rx-viper/rxsms/eagle/bom-total.ods

Sheet: All
 |  | Qty Variant |  |  | 11 | 6 | 1 | 1 | 1 | 6 | Extra, Staffelung | Qty Total
Value | Device | OC_FARNELL | OC_RS | OC_Buerklin | Qty RX | Qty ZARM | Qty MST1 | Qty MST2 | Qty Pwr ZARM | Qty MST Test
 | AK500/2 | 1131855 |  |  | 1 | 0 | 1 | 1 |  |  | 2 | 15
 | F09HP | 1207597 |  |  | 2 | 2 | 2 | 2 |  |  |  | 38
 | F15HP | 1207598 |  |  | 1 | 1 | 1 | 1 | 1 |  |  | 20
 | M15HPS | 1097065 |  |  | 0 | 0 | 0 | 0 | 0 | 1 |  | 6
 | schrauben | 1855027 |  |  | 6 | 6 | 6 | 6 | 2 | 2 |  | 128
 | ML26L | 1096983 |  |  | 0 | 1 | 1 | 1 | 1 |  |  | 9
 | ML6 | 1096984 |  |  | 1 | 1 | 5 | 5 |  |  |  | 27
100k | R-EU_R0805 | 2333538 |  |  | 1 | 1 | 1 | 1 |  |  |  | 19
100n | C-EUC0805K | 1759265 |  |  | 20 | 16 | 20 | 20 |  |  | 4 | 360
10k | R-EU_R0805 | 1887308 |  |  | 17 | 17 | 17 | 17 |  |  | 2 | 325
10u/16V | C-EUC0805K | 2320856 |  |  | 1 | 1 | 1 | 1 |  |  | 1 | 20
127 | R-EU_R0805 | 2141745 |  |  | 2 | 2 | 2 | 2 |  |  |  | 38
150 | R-EU_R0805 | 1099794 |  |  | 1 | 0 | 1 | 1 |  |  | 7 | 20
1M | R-EU_R0805 | 2333544 |  |  | 0 | 0 | 1 | 1 |  |  |  | 2
1k | R-EU_R0805 | 2332071 |  |  | 5 | 4 | 5 | 5 |  |  | 1 | 90
1u | C-EUC0805K | 2320853 |  |  | 5 | 5 | 9 | 9 |  |  | 7 | 110
22k | R-EU_R0805 | 2303686 |  |  | 1 | 1 | 1 | 1 |  |  | 1 | 20
22u/25V | C-EUC0805K | 1907510 |  |  | 2 | 2 | 2 | 2 |  |  | 2 | 40
24/1% | R-EU_R0805 |  | 666-2386 |  | 0 | 0 | 4 | 4 |  |  | 2 | 10
270 | R-EU_R0805 | 2332064 |  |  | 2 | 2 | 2 | 2 |  |  | 2 | 40
330 | R-EU_R0805 | 1500705 |  |  | 1 | 1 | 1 | 1 |  |  | 1 | 20
3V | ZENER-DIODESOT23 | 1081418 |  |  | 1 | 1 | 1 | 1 |  |  | 1 | 20
4n7 | C-EUC0805K | 2407305 |  |  | 0 | 0 | 1 | 1 |  |  |  | 2
4u7/50V | C-EUC0805K | 2346932 |  |  | 5 | 5 | 5 | 5 |  |  | 5 | 100
10k | STRK11K |  | 737-7833 |  | 0 | 0 | 3 | 3 |  |  |  | 6
50k | STRK11K | 1345093 |  |  | 3 | 0 | 0 | 0 |  |  |  | 33
68 | R-EU_R0805 | 1099792 |  |  | 7 | 6 | 7 | 7 |  |  | 3 | 130
ADUM3160 | ADUM3160 | 1843660 |  |  | 0 | 0 | 1 | 1 |  |  |  | 2
BERNSTEIN | LEDCHIPLED_1206 | 2322083 |  |  | 2 | 2 | 2 | 2 |  |  |  | 38
BSS123 | BSS123 | 9558640RL |  |  | 11 | 11 | 11 | 11 |  |  | 1 | 210
BTS6143 | BTS6143 | 1440813 |  |  | 1 | 1 | 1 | 1 |  |  |  | 19
COIL | COIL | 2333799 |  |  | 2 | 2 | 2 | 2 |  |  |  | 38
GREEN | LEDCHIPLED_1206 | 2099244 |  |  | 3 | 0 | 3 | 1 |  |  |  | 37
HCPL0600 | HCPL0600 | 9994696 |  |  | 4 | 4 | 4 | 4 |  |  |  | 76
LM1117 | LM1117 | 1685603 |  |  | 1 | 1 | 1 | 1 |  |  |  | 19
MAX3232ESE | MAX3232ESE | 9725539 |  |  | 1 | 1 | 1 | 1 |  |  |  | 19
NC7WZ17P6X | NC7WZ17P6X | 1651986 |  |  | 1 | 1 | 1 | 1 |  |  |  | 19
NUP2202W1 | NUP2202W1 |  | 463-690 |  | 0 | 0 | 1 | 1 |  |  | 8 | 10
PN61729-S | PN61729-S | 1642035 |  |  | 0 | 0 | 1 | 1 |  |  |  | 2
RLP2-200-500 | RLP2-200-500 |  | 752-9157 |  | 0 | 1 | 0 | 1 |  |  | 3 | 10
SMS_IP67 | SMS_IP67 | 1217758 |  |  | 5 | 0 | 5 | 0 |  |  |  | 60
SP490 | SP490 | 9387234 |  |  | 1 | 1 | 1 | 1 |  |  |  | 19
SWITCH_LED | SWITCH_LED |  |  | 12 G 203 | 0 | 3 | 0 | 3 |  |  |  | 21
SWITCH_LED | SWITCH_LED |  |  | 12 G 205 | 0 | 1 | 0 | 2 |  |  | 2 | 10
TEN3-2410N | TEN3-2410N |  | 801-9330 |  | 1 | 1 | 1 | 1 |  |  | -10 | 9
TEN3-2410N | TEN3-2410N |  | 801-9330P |  | 1 | 1 | 1 | 1 |  |  | -9 | 10
TPS73125 | TPS731 | 2112625 |  |  | 1 | 1 | 1 | 1 |  |  |  | 19
TSR_1-2450 | TSR_1-2450 | 1696320 |  |  | 1 | 1 | 1 | 1 |  |  |  | 19
UDN2596 | UDN2596 | 1103848 |  |  | 1 | 1 | 1 | 1 |  |  | 1 | 20
XMEGA-A4UTQFP | XMEGA-A4UTQFP | 2066309 |  |  | 1 | 1 | 1 | 1 |  |  |  | 19
YELLOW | LEDCHIPLED_1206 | 2099249 |  |  | 3 | 0 | 3 | 0 |  |  |  | 36
0 | R-EU_R0805 | 2309112 |  |  | 2 | 2 | 2 | 2 |  |  |  | 38
12V | ZENER-DIODEDO34-7 | 1779204 |  |  | 0 | 0 | 0 | 0 | 2 |  |  | 2
FDD4141TO252 | FDD4141TO252 | 2101406 |  |  | 0 | 0 | 0 | 0 | 1 |  |  | 1
black | JACK | 1854507 |  |  | 0 | 0 | 0 | 0 | 1 |  |  | 1
red | JACK | 1854508 |  |  | 0 | 0 | 0 | 0 | 1 |  |  | 1
blue | JACK | 1854511 |  |  | 0 | 0 | 0 | 0 | 0 |  |  | 0
yellow | JACK | 1854510 |  |  | 0 | 0 | 0 | 0 | 1 |  |  | 1
RLP1-200-500 | RLP1-200-500 | 1887972 |  |  | 0 | 0 | 0 | 0 | 1 |  |  | 1
SCHURTER-LSH-1301.9314 | SCHURTER-LSH-1301.9314 | 1217763 |  |  | 0 | 0 | 0 | 0 | 0 | 1 |  | 6
26 Pol | Flachbandkabel | 297343 |  |  | 0 | 0 | 0 | 0 | 1 | 0 |  | 1
26 Pol | Crimp Buchse | 1200506 |  |  | 0 | 1 | 0 | 0 | 1 | 0 | 3 | 10
BUERKLIN17H912 | BUERKLIN17H912 |  |  | 17H912 | 0 | 0 | 0 | 0 | 1 | 0 |  | 1

Sheet: RS
666-2386 | 10
737-7833 | 6
463-690 | 10
752-9157 | 10
801-9330 | 9
801-9330P | 10

Sheet: FARNELL
1131855 | 15
1207597 | 38
1207598 | 20
1097065 | 6
1855027 | 128
1096983 | 9
1096984 | 27
2333538 | 19
1759265 | 360
1887308 | 325
2320856 | 20
2141745 | 38
1099794 | 20
2333544 | 2
2332071 | 90
2320853 | 110
2303686 | 20
1907510 | 40
2332064 | 40
1500705 | 20
1081418 | 20
2407305 | 2
2346932 | 100
1345093 | 33
1099792 | 130
1843660 | 2
2322083 | 38
9558640RL | 210
1440813 | 19
2333799 | 38
2099244 | 37
9994696 | 76
1685603 | 19
9725539 | 19
1651986 | 19
1642035 | 2
1217758 | 60
9387234 | 19
2112625 | 19
1696320 | 19
1103848 | 20
2066309 | 19
2099249 | 36
2309112 | 38
1779204 | 2
2101406 | 1
1854507 | 1
1854508 | 1
1854510 | 1
1887972 | 1
1217763 | 6
297343 | 1
1200506 | 10

Sheet: BUERKLIN
12 G 203 | 21
12 G 205 | 10
17H912 | 1
