rx-viper/rxsms/eagle/simulator/bom-sim.ods

Sheet: rxsms-2.0-parts
Part | Value | Device | Package | Description | OC_BUERKLIN | OC_FARNELL | OC_RS | VAR_RX | VAR_ZARM | VAR_MST_RX | VAR_MST_ZARM | Bestückung
C1 | 1u | C-EUC0805K | C0805K | CAPACITOR, European symbol |  | 2320853 |  | 1 | 1 | 1 | 1 | 1
C2 | 1u | C-EUC0805K | C0805K | CAPACITOR, European symbol |  | 2320853 |  | 1 | 1 | 1 | 1 | 1
C3 | 1u | C-EUC0805K | C0805K | CAPACITOR, European symbol |  | 2320853 |  | 1 | 1 | 1 | 1 | 1
C4 | 1u | C-EUC0805K | C0805K | CAPACITOR, European symbol |  | 2320853 |  | 1 | 1 | 1 | 1 | 1
C5 | 1u | C-EUC0805K | C0805K | CAPACITOR, European symbol |  | 2320853 |  | 1 | 1 | 1 | 1 | 1
C6 | 100n | C-EUC0805K | C0805K | CAPACITOR, European symbol |  | 1759265 |  | 1 | 1 | 1 | 1 | 1
C7 | 100n | C-EUC0805K | C0805K | CAPACITOR, European symbol |  | 1759265 |  | 1 | 1 | 1 | 1 | 1
C8 | 100n | C-EUC0805K | C0805K | CAPACITOR, European symbol |  | 1759265 |  | 1 | 1 | 1 | 1 | 1
C9 | 100n | C-EUC0805K | C0805K | CAPACITOR, European symbol |  | 1759265 |  | 1 | 1 | 1 | 1 | 1
C10 | opt | C-EUC0805K | C0805K | CAPACITOR, European symbol
C11 | opt | C-EUC0805K | C0805K | CAPACITOR, European symbol
C12 | 4u7/50V | C-EUC0805K | C0805K | CAPACITOR, European symbol |  | 2346932 |  | 1 | 1 | 1 | 1 | 1
C13 | 4u7/50V | C-EUC0805K | C0805K | CAPACITOR, European symbol |  | 2346932 |  | 1 | 1 | 1 | 1 | 1
C14 | 22u/25V | C-EUC0805K | C0805K | CAPACITOR, European symbol |  | 1907510 |  | 1 | 1 | 1 | 1 | 1
C15 | 22u/25V | C-EUC0805K | C0805K | CAPACITOR, European symbol |  | 1907510 |  | 1 | 1 | 1 | 1 | 1
C16 | 100n | C-EUC0805K | C0805K | CAPACITOR, European symbol |  | 1759265 |  | 1 | 1 | 1 | 1 | 1
C17 | 1u | C-EUC0805K | C0805K | CAPACITOR, European symbol |  | 2320853 |  |  |  | 1 | 1
C18 | 1u | C-EUC0805K | C0805K | CAPACITOR, European symbol |  | 2320853 |  |  |  | 1 | 1
C19 | 1u | C-EUC0805K | C0805K | CAPACITOR, European symbol |  | 2320853 |  |  |  | 1 | 1
C20 | 1u | C-EUC0805K | C0805K | CAPACITOR, European symbol |  | 2320853 |  |  |  | 1 | 1
C21 | 100n | C-EUC0805K | C0805K | CAPACITOR, European symbol |  | 1759265 |  | 1 | 1 | 1 | 1 | 1
C22 | 100n | C-EUC0805K | C0805K | CAPACITOR, European symbol |  | 1759265 |  | 1 | 1 | 1 | 1 | 1
C23 | 100n | C-EUC0805K | C0805K | CAPACITOR, European symbol |  | 1759265 |  | 1 | 1 | 1 | 1 | 1
C24 | 100n | C-EUC0805K | C0805K | CAPACITOR, European symbol |  | 1759265 |  | 1 | 1 | 1 | 1 | 1
C25 | 100n | C-EUC0805K | C0805K | CAPACITOR, European symbol |  | 1759265 |  | 1 | 1 | 1 | 1 | 1
C26 | 100n | C-EUC0805K | C0805K | CAPACITOR, European symbol |  | 1759265 |  | 1 | 1 | 1 | 1 | 1
C27 | 100n | C-EUC0805K | C0805K | CAPACITOR, European symbol |  | 1759265 |  | 1 | 1 | 1 | 1 | 1
C28 | 100n | C-EUC0805K | C0805K | CAPACITOR, European symbol |  | 1759265 |  | 1 | 1 | 1 | 1 | 1
C29 | 100n | C-EUC0805K | C0805K | CAPACITOR, European symbol |  | 1759265 |  | 1 | 1 | 1 | 1 | 1
C30 | 4u7/50V | C-EUC0805K | C0805K | CAPACITOR, European symbol |  | 2346932 |  | 1 | 1 | 1 | 1 | 1
C31 | 4u7/50V | C-EUC0805K | C0805K | CAPACITOR, European symbol |  | 2346932 |  | 1 | 1 | 1 | 1 | 1
C32 | 10u/16V | C-EUC0805K | C0805K | CAPACITOR, European symbol |  | 2320856 |  | 1 | 1 | 1 | 1 | 1
C33 | 100n | C-EUC0805K | C0805K | CAPACITOR, European symbol |  | 1759265 |  | 1 | 1 | 1 | 1 | 1
C34 | 4n7 | C-EUC0805K | C0805K | CAPACITOR, European symbol |  | 2407305 |  |  |  | 1 | 1
C35 | 4u7/50V | C-EUC0805K | C0805K | CAPACITOR, European symbol |  | 2346932 |  | 1 | 1 | 1 | 1 | 1
C36 | 100n | C-EUC0805K | C0805K | CAPACITOR, European symbol |  | 1759265 |  | 1 | 1 | 1 | 1 | 1
C37 | 100n | C-EUC0805K | C0805K | CAPACITOR, European symbol |  | 1759265 |  | 1 | 1 | 1 | 1 | 1
C38 | 100n | C-EUC0805K | C0805K | CAPACITOR, European symbol |  | 1759265 |  | 1 | 1 | 1 | 1 | 1
C39 | 100n | C-EUC0805K | C0805K | CAPACITOR, European symbol |  | 1759265 |  | 1 | 1 | 1 | 1 | 1
C40 | 100n | C-EUC0805K | C0805K | CAPACITOR, European symbol |  | 1759265 |  | 1 | 1 | 1 | 1 | 1
D1 | 12V | ZENER-DIODEDO34-7 | DO34Z7 | Z-Diode |  | 1779204 |  | 1 | 1 | 1 | 1 | 1
JP1 |  | JP1E | JP1 | JUMPER
JP2 |  | JP1E | JP1 | JUMPER
L1 | COIL | COIL | BOURNS-SRR0906 |  |  | 2333799 |  | 1 | 1 | 1 | 1 | 1
L2 | COIL | COIL | BOURNS-SRR0906 |  |  | 2333799 |  | 1 | 1 | 1 | 1 | 1
LED1_LO | YELLOW | LEDCHIPLED_1206 | CHIPLED_1206 | LED |  | 2099249 |  | 1 |  | 1 |  | 1
LED2_SOE | YELLOW | LEDCHIPLED_1206 | CHIPLED_1206 | LED |  | 2099249 |  | 1 |  | 1 |  | 1
LED3_SODS | YELLOW | LEDCHIPLED_1206 | CHIPLED_1206 | LED |  | 2099249 |  | 1 |  | 1 |  | 1
LED4_ERRINH | GREEN | LEDCHIPLED_1206 | CHIPLED_1206 | LED |  | 2099244 |  | 1 |  | 1 |  | 1
LED5_PWR | GREEN | LEDCHIPLED_1206 | CHIPLED_1206 | LED |  | 2099244 |  | 1 |  | 1 |  | 1
LED6 | BERNSTEIN | LEDCHIPLED_1206 | CHIPLED_1206 | LED |  | 2322083 |  | 1 | 1 | 1 | 1 | 1
LED7 | BERNSTEIN | LEDCHIPLED_1206 | CHIPLED_1206 | LED |  | 2322083 |  | 1 | 1 | 1 | 1 | 1
LED8 | GREEN | LEDCHIPLED_1206 | CHIPLED_1206 | LED |  | 2099244 |  | 1 | 1 | 1 | 1 | 1
OK1 | HCPL0600 | HCPL0600 | SOIC08 | HEWLETT PACKARD OPTO COUPLER |  | 9994696 |  | 1 | 1 | 1 | 1 | 1
OK2 | HCPL0600 | HCPL0600 | SOIC08 | HEWLETT PACKARD OPTO COUPLER |  | 9994696 |  | 1 | 1 | 1 | 1 | 1
OK3 | HCPL0600 | HCPL0600 | SOIC08 | HEWLETT PACKARD OPTO COUPLER |  | 9994696 |  | 1 | 1 | 1 | 1 | 1
OK4 | HCPL0600 | HCPL0600 | SOIC08 | HEWLETT PACKARD OPTO COUPLER |  | 9994696 |  | 1 | 1 | 1 | 1 | 1
Q1 | opt | CRYSTALHC49S | HC49/S | CRYSTAL |  | 1667008
Q2 | BSS123 | BSS123 | SOT23 | N-CHANNEL MOS FET |  | 9558640 | 545-0135 | 1 | 1 | 1 | 1 | 1
Q3 | BSS123 | BSS123 | SOT23 | N-CHANNEL MOS FET |  | 9558640 | 545-0135 | 1 | 1 | 1 | 1 | 1
Q4 | BSS123 | BSS123 | SOT23 | N-CHANNEL MOS FET |  | 9558640 | 545-0135 | 1 | 1 | 1 | 1 | 1
Q5 | BSS123 | BSS123 | SOT23 | N-CHANNEL MOS FET |  | 9558640 | 545-0135 | 1 | 1 | 1 | 1 | 1
Q6 | BSS123 | BSS123 | SOT23 | N-CHANNEL MOS FET |  | 9558640 | 545-0135 | 1 | 1 | 1 | 1 | 1
Q7 | BSS123 | BSS123 | SOT23 | N-CHANNEL MOS FET |  | 9558640 | 545-0135 | 1 | 1 | 1 | 1 | 1
Q8 | BSS123 | BSS123 | SOT23 | N-CHANNEL MOS FET |  | 9558640 | 545-0135 | 1 | 1 | 1 | 1 | 1
Q9 | BSS123 | BSS123 | SOT23 | N-CHANNEL MOS FET |  | 9558640 | 545-0135 | 1 | 1 | 1 | 1 | 1
Q10 | BSS123 | BSS123 | SOT23 | N-CHANNEL MOS FET |  | 9558640 | 545-0135 | 1 | 1 | 1 | 1 | 1
Q11 | BSS123 | BSS123 | SOT23 | N-CHANNEL MOS FET |  | 9558640 | 545-0135 | 1 | 1 | 1 | 1 | 1
Q12 | BSS123 | BSS123 | SOT23 | N-CHANNEL MOS FET |  | 9558640 | 545-0135 | 1 | 1 | 1 | 1 | 1
Q13 | FDD4141TO252 | FDD4141TO252 | TO252 | P-Channel PowerTrench� MOSFET |  | 2101406 |  | 1 | 1 | 1 | 1 | 1
R1 | 10k | R-EU_R0805 | R0805 | RESISTOR, European symbol |  | 1887308 |  | 1 | 1 | 1 | 1 | 1
R2 | 10k | R-EU_R0805 | R0805 | RESISTOR, European symbol |  | 1887308 |  | 1 | 1 | 1 | 1 | 1
R3 | 10k | R-EU_R0805 | R0805 | RESISTOR, European symbol |  | 1887308 |  | 1 | 1 | 1 | 1 | 1
R4 | 2k2 | R-EU_R0805 | R0805 | RESISTOR, European symbol |  | 2332076 |  | 1 | 1 | 1 | 1 | 1
R5 | 10k | R-EU_R0805 | R0805 | RESISTOR, European symbol |  | 1887308 |  | 1 | 1 | 1 | 1 | 1
R6 | 10k | R-EU_R0805 | R0805 | RESISTOR, European symbol |  | 1887308 |  | 1 | 1 | 1 | 1 | 1
R7 | 10k | R-EU_R0805 | R0805 | RESISTOR, European symbol |  | 1887308 |  | 1 | 1 | 1 | 1 | 1
R8 | 10k | R-EU_R0805 | R0805 | RESISTOR, European symbol |  | 1887308 |  | 1 | 1 | 1 | 1 | 1
R9 | 10k | R-EU_R0805 | R0805 | RESISTOR, European symbol |  | 1887308 |  | 1 | 1 | 1 | 1 | 1
R10 | 10k | R-EU_R0805 | R0805 | RESISTOR, European symbol |  | 1887308 |  | 1 | 1 | 1 | 1 | 1
R11 | 10k | R-EU_R0805 | R0805 | RESISTOR, European symbol |  | 1887308 |  | 1 | 1 | 1 | 1 | 1
R12 | 24/1% | R-EU_R0805 | R0805 | RESISTOR, European symbol |  |  | 666-2386 |  |  | 1 | 1
R13 | 24/1% | R-EU_R0805 | R0805 | RESISTOR, European symbol |  |  | 666-2386 |  |  | 1 | 1
R14 | 24/1% | R-EU_R0805 | R0805 | RESISTOR, European symbol |  |  | 666-2386 |  |  | 1 | 1
R15 | 24/1% | R-EU_R0805 | R0805 | RESISTOR, European symbol |  |  | 666-2386 |  |  | 1 | 1
R16 | 1k | R-EU_R0805 | R0805 | RESISTOR, European symbol |  | 2332071 |  | 1 | 1 | 1 | 1 | 1
R17 | 1k | R-EU_R0805 | R0805 | RESISTOR, European symbol |  | 2332071 |  | 1 | 1 | 1 | 1 | 1
R18 | 1k | R-EU_R0805 | R0805 | RESISTOR, European symbol |  | 2332071 |  | 1 | 1 | 1 | 1 | 1
R19 | 1k | R-EU_R0805 | R0805 | RESISTOR, European symbol |  | 2332071 |  | 1 | 1 | 1 | 1 | 1
R20 | 1k | R-EU_R0805 | R0805 | RESISTOR, European symbol |  | 2332071 |  | 1 | 1 | 1 | 1 | 1
R21 | 10k | R-EU_R0805 | R0805 | RESISTOR, European symbol |  | 1887308 |  | 1 | 1 | 1 | 1 | 1
R22 | 127 | R-EU_R0805 | R0805 | RESISTOR, European symbol |  | 2141745 |  | 1 | 1 | 1 | 1 | 1
R23 | 10k | R-EU_R0805 | R0805 | RESISTOR, European symbol |  | 1887308 |  | 1 | 1 | 1 | 1 | 1
R24 | 10k | R-EU_R0805 | R0805 | RESISTOR, European symbol |  | 1887308 |  | 1 | 1 | 1 | 1 | 1
R25 | 127 | R-EU_R0805 | R0805 | RESISTOR, European symbol |  | 2141745 |  | 1 | 1 | 1 | 1 | 1
R26 | 10k | R-EU_R0805 | R0805 | RESISTOR, European symbol |  | 1887308 |  | 1 | 1 | 1 | 1 | 1
R27 | 10k | R-EU_R0805 | R0805 | RESISTOR, European symbol |  | 1887308 |  | 1 | 1 | 1 | 1 | 1
R28 | 10k | R-EU_R0805 | R0805 | RESISTOR, European symbol |  | 1887308 |  | 1 | 1 | 1 | 1 | 1
R29 | 270 | R-EU_R0805 | R0805 | RESISTOR, European symbol |  | 2332064 |  | 1 | 1 | 1 | 1 | 1
R30 | 10k | R-EU_R0805 | R0805 | RESISTOR, European symbol |  | 1887308 |  | 1 | 1 | 1 | 1 | 1
R31 | 10k | R-EU_R0805 | R0805 | RESISTOR, European symbol |  | 1887308 |  | 1 | 1 | 1 | 1 | 1
R32 | 270 | R-EU_R0805 | R0805 | RESISTOR, European symbol |  | 2332064 |  | 1 | 1 | 1 | 1 | 1
R33 | 0 | R-EU_R0805 | R0805 | RESISTOR, European symbol |  | 2309112 |  | 1 | 1 | 1 | 1 | 1
R34 | 0 | R-EU_R0805 | R0805 | RESISTOR, European symbol |  | 2309112
R35 | 0 | R-EU_R0805 | R0805 | RESISTOR, European symbol |  | 2309112 |  | 1 | 1 | 1 | 1 | 1
R36 | 1k | R-EU_R0805 | R0805 | RESISTOR, European symbol |  | 2332071 |  | 1 | 1 | 1 | 1 | 1
R37 | 2k2 | R-EU_R0805 | R0805 | RESISTOR, European symbol |  | 2332076 |  | 1 | 1 | 1 | 1 | 1
R39 | 2k2 | R-EU_R0805 | R0805 | RESISTOR, European symbol |  | 2332076 |  | 1 | 1 | 1 | 1 | 1
R40 | 2k2 | R-EU_R0805 | R0805 | RESISTOR, European symbol |  | 2332076 |  | 1 | 1 | 1 | 1 | 1
R43 | 1k | R-EU_R0805 | R0805 | RESISTOR, European symbol |  | 2332071 |  | 1 | 1 | 1 | 1 | 1
R44 | 1k | R-EU_R0805 | R0805 | RESISTOR, European symbol |  | 2332071 |  | 1 | 1 | 1 | 1 | 1
R46.1 | 1k | R-EU_R0805 | R0805 | RESISTOR, European symbol |  | 2332071 |  | 1 |  | 1 |  | 1
R46.2 | 100 | R-EU_R0805 | R0805 | RESISTOR, European symbol |  | 2332058 |  |  | 1 |  | 1
R47.1 | 1k | R-EU_R0805 | R0805 | RESISTOR, European symbol |  | 2332071 |  | 1 |  | 1 |  | 1
R47.2 | 100 | R-EU_R0805 | R0805 | RESISTOR, European symbol |  | 2332058 |  |  | 1 |  | 1
R48 | 1M | R-EU_R0805 | R0805 | RESISTOR, European symbol |  | 2333544 |  |  |  | 1 | 1
R49 | 2k7 | R-EU_R0805 | R0805 | RESISTOR, European symbol |  | 2332077 |  | 1 | 1 | 1 | 1 | 1
R50 | 330 | R-EU_R0805 | R0805 | RESISTOR, European symbol |  | 1500705 |  | 1 | 1 | 1 | 1 | 1
SCREW1 | 4-40/M3 | DSUB_MOUNTING_SCREW | SCREW_DUMMY |  |  | 2135988 |  | 1 | 1 | 1 | 1
SCREW2 | 4-40/M3 | DSUB_MOUNTING_SCREW | SCREW_DUMMY |  |  | 2135988 |  | 1 | 1 | 1 | 1
SCREW3 | 4-40/M3 | DSUB_MOUNTING_SCREW | SCREW_DUMMY |  |  | 2135988 |  | 1 | 1 | 1 | 1
SCREW4 | 4-40/M3 | DSUB_MOUNTING_SCREW | SCREW_DUMMY |  |  | 2135988 |  | 1 | 1 | 1 | 1
SCREW5 | 4-40/M3 | DSUB_MOUNTING_SCREW | SCREW_DUMMY |  |  | 2135988 |  | 1 | 1 | 1 | 1
SCREW6 | 4-40/M3 | DSUB_MOUNTING_SCREW | SCREW_DUMMY |  |  | 2135988 |  | 1 | 1 | 1 | 1
SJ1 |  | SJ | SJ | SMD solder JUMPER
SJ2 |  | SJ | SJ | SMD solder JUMPER
SJ3 |  | SJ | SJ | SMD solder JUMPER
SJ4 |  | SJ | SJ | SMD solder JUMPER
SJ5 |  | SJ | SJ | SMD solder JUMPER
SJ6 |  | SJ | SJ | SMD solder JUMPER
SJ7 |  | SJ | SJ | SMD solder JUMPER
SJ8 |  | SJ | SJ | SMD solder JUMPER
SJ9 |  | SJ | SJ | SMD solder JUMPER
SV1 |  | ML26L | ML26L | HARTING |  | 1096983 |  | 1 | 1 | 1 | 1 | 1
SV2 |  | ML6 | ML6 | HARTING |  | 1096984 | 740-7105 |  |  | 1 | 1
SV3 |  | ML6 | ML6 | HARTING |  | 1096984 | 740-7105 |  |  | 1 | 1
SV4 |  | ML6 | ML6 | HARTING |  | 1096984 | 740-7105 |  |  | 1 | 1
SV5 |  | ML6 | ML6 | HARTING |  | 1096984 | 740-7105 |  |  | 1 | 1
SV6 |  | ML6 | ML6 | HARTING |  | 1096984 | 740-7105 | 1 | 1 | 1 | 1 | 1
T1_LO | SMS_IP67 | SMS_IP67 | IP67 | Gro�er Tastschalter Taster Switch Schalter |  | 1217758 |  | 1 |  | 1
T2_SOE | SMS_IP67 | SMS_IP67 | IP67 | Gro�er Tastschalter Taster Switch Schalter |  | 1217758 |  | 1 |  | 1
T3_SOE | SWITCH_LED | SWITCH_LED | SWITCH_LED |  | 12 G 203 |  |  |  | 1 |  | 1
T4_PWR | SMS_IP67 | SMS_IP67 | IP67 | Gro�er Tastschalter Taster Switch Schalter |  | 1217758 |  | 1 |  | 1
T5_ERRINH | SMS_IP67 | SMS_IP67 | IP67 | Gro�er Tastschalter Taster Switch Schalter |  | 1217758 |  | 1 |  | 1
T6_PWR | SWITCH_LED | SWITCH_LED | SWITCH_LED |  | 12 G 205 |  |  |  | 1 |  | 1
T7_ERRINH | SWITCH_LED | SWITCH_LED | SWITCH_LED |  | 12 G 205 |  |  |  |  |  | 1
T8_LO | SWITCH_LED | SWITCH_LED | SWITCH_LED |  | 12 G 203 |  |  |  | 1 |  | 1
T9_SODS | SMS_IP67 | SMS_IP67 | IP67 | Gro�er Tastschalter Taster Switch Schalter |  | 1217758 |  | 1 |  | 1
T10_SODS | SWITCH_LED | SWITCH_LED | SWITCH_LED |  | 12 G 203 |  |  |  | 1 |  | 1
U$3 | black | JACK | JACK |  |  | 1854507 |  | 1 |  | 1
U$4 | UDN2596 | UDN2596 | DIL20 |  |  | 1103848 |  | 1 | 1 | 1 | 1 | 1
U$5 | SP490 | SP490 | SO08 |  |  | 9387234 |  | 1 | 1 | 1 | 1 | 1
U$6 | BTS6143 | BTS6143 | TO-252-5-1 |  |  | 1440813 |  | 1 | 1 | 1 | 1 | 1
U$7_BER | 50k | STRK11K | VERT_POTI | Potentiometer |  | 1345093 |  | 1 |  | 1 | 1
U$8_DROPR | 50k | STRK11K | VERT_POTI | Potentiometer |  | 1345093 |  | 1 |  | 1 | 1
U$9 | red | JACK | JACK |  |  | 1854508 |  | 1 |  | 1
U$9_DROPDUR | 50k | STRK11K | VERT_POTI | Potentiometer |  | 1345093 |  | 1 |  | 1 | 1
U$10 | TEN3-2410N | TEN3-2410N | TEN3-2410N |  |  |  | 801-9330 | 1 | 1 | 1 | 1 | 1
U1 | MAX3232ESE | MAX3232ESE | SO16 | True RS-232 Transceivers 3.0V to 5.5V, Low-Power |  | 9725539 |  | 1 | 1 | 1 | 1 | 1
U2 | XMEGA-A4UTQFP | XMEGA-A4UTQFP | TQFP44 | Atmel XMega A4U series processor |  | 2066309 |  | 1 | 1 | 1 | 1 | 1
U3 | TSR_1-2450 | TSR_1-2450 | TSR-1 | TRACO TSR-1 Series |  | 1696320 |  | 1 | 1 | 1 | 1 | 1
U4 | LM1117 | LM1117 | TO252 |  |  | 1685603 |  | 1 | 1 | 1 | 1 | 1
U5 | NC7WZ17P6X | NC7WZ17P6X | SOT65P210X110-6N | Dual Buffer |  | 1651986 |  | 1 | 1 | 1 | 1 | 1
U6 | ADUM3160 | ADUM3160 | SO-16W |  |  | 1843660 |  |  |  | 1 | 1
U7 | TPS73125 | TPS731 | SOT25 |  |  | 2112625 |  | 1 | 1 | 1 | 1 | 1
U8 | NUP2202W1 | NUP2202W1 | SOT363_PHILIPS |  |  |  | 463-690 |  |  | 1 | 1
X1 | PN61729-S | PN61729-S | PN61729-S | BERG USB connector |  | 1642035 | 515-1989 |  |  | 1 | 1
X2_GROUNDSTATION |  | F09HP | F09HP | SUB-D |  | 1207597 |  | 1 | 1 | 1 | 1 | 1
X3_DEBUG |  | F09HP | F09HP | SUB-D |  | 1207597 |  | 1 | 1 | 1 | 1 | 1
X4 |  | F15HP | F15HP | SUB-D |  | 1207598 |  | 1 | 1 | 1 | 1 | 1
X5 | RLP2-200-500 | RLP2-200-500 | RLP2-200-500 |  |  |  | 752-9157 |  | 1 |  | 1
X6 |  | AK500/2 | AK500/2 | CONNECTOR |  | 1131855 |  | 1 | 1 | 1 | 1 | 1

Sheet: rxsms-2.0-values
 | Value | Device | Package | Parts | OC_BUERKLIN | OC_FARNELL | OC_RS
1 |  | AK500/2 | AK500/2 | X6 |  | 1131855
2 |  | F09HP | F09HP | X2_GROUNDSTATION, X3_DEBUG |  | 1207597
1 |  | F15HP | F15HP | X4 |  | 1207598
2 |  | JP1E | JP1 | JP1, JP2
1 |  | ML26L | ML26L | SV1 |  | 1096983
5 |  | ML6 | ML6 | SV2, SV3, SV4, SV5, SV6 |  | 1096984 | 740-7105
9 |  | SJ | SJ | SJ1, SJ2, SJ3, SJ4, SJ5, SJ6, SJ7, SJ8, SJ9
20 | 100n | C-EUC0805K | C0805K | C6, C7, C8, C9, C16, C21, C22, C23, C24, C25, C26, C27, C28, C29, C33, C36, C37, C38, C39, C40 |  | 1759265
18 | 10k | R-EU_R0805 | R0805 | R1, R2, R3, R5, R6, R7, R8, R9, R10, R11, R21, R23, R24, R26, R27, R28, R30, R31 |  | 1887308
1 | 10u/16V | C-EUC0805K | C0805K | C32 |  | 2320856
2 | 127 | R-EU_R0805 | R0805 | R22, R25 |  | 2141745
1 | 12V | ZENER-DIODEDO34-7 | DO34Z7 | D1 |  | 1779204
1 | 1M | R-EU_R0805 | R0805 | R48 |  | 2333544
8 | 1k | R-EU_R0805 | R0805 | R16, R17, R18, R19, R20, R36, R43, R44 |  | 2332071
2 | 1k | R-EU_R0805 | R0805 | R46, R47 |  | 2332071
2 | 100 | R-EU_R0805 | R0805 | R46, R47 |  | 2332058
9 | 1u | C-EUC0805K | C0805K | C1, C2, C3, C4, C5, C17, C18, C19, C20 |  | 2320853
2 | 22u/25V | C-EUC0805K | C0805K | C14, C15 |  | 1907510
4 | 24/1% | R-EU_R0805 | R0805 | R12, R13, R14, R15 |  |  | 666-2386
2 | 270 | R-EU_R0805 | R0805 | R29, R32 |  | 2332064
4 | 2k2 | R-EU_R0805 | R0805 | R4, R37, R39, R40 |  | 2332076
1 | 2k7 | R-EU_R0805 | R0805 | R49 |  | 2332077
1 | 330 | R-EU_R0805 | R0805 | R50 |  | 1500705
6 | 4-40/M3 | DSUB_MOUNTING_SCREW | SCREW_DUMMY | SCREW1, SCREW2, SCREW3, SCREW4, SCREW5, SCREW6 |  | 2135988
1 | 4n7 | C-EUC0805K | C0805K | C34 |  | 2407305
5 | 4u7/50V | C-EUC0805K | C0805K | C12, C13, C30, C31, C35 |  | 2346932
3 | 50k | STRK11K | VERT_POTI | U$7_BER, U$8_DROPR, U$9_DROPDUR |  | 1345093
1 | ADUM3160 | ADUM3160 | SO-16W | U6 |  | 1843660
2 | BERNSTEIN | LEDCHIPLED_1206 | CHIPLED_1206 | LED6, LED7 |  | 2322083
11 | BSS123 | BSS123 | SOT23 | Q2, Q3, Q4, Q5, Q6, Q7, Q8, Q9, Q10, Q11, Q12 |  | 9558640 | 545-0135
1 | BTS6143 | BTS6143 | TO-252-5-1 | U$6 |  | 1440813
2 | COIL | COIL | BOURNS-SRR0906 | L1, L2 |  | 2333799
1 | FDD4141TO252 | FDD4141TO252 | TO252 | Q13 |  | 2101406
3 | GREEN | LEDCHIPLED_1206 | CHIPLED_1206 | LED4_ERRINH, LED5_PWR, LED8 |  | 2099244
4 | HCPL0600 | HCPL0600 | SOIC08 | OK1, OK2, OK3, OK4 |  | 9994696
1 | black | JACK | JACK | U$3 |  | 1854507
1 | red | JACK | JACK | U$9 |  | 1854508
1 | LM1117 | LM1117 | TO252 | U4 |  | 1685603
1 | MAX3232ESE | MAX3232ESE | SO16 | U1 |  | 9725539
1 | NC7WZ17P6X | NC7WZ17P6X | SOT65P210X110-6N | U5 |  | 1651986
1 | NUP2202W1 | NUP2202W1 | SOT363_PHILIPS | U8 |  |  | 463-690
1 | PN61729-S | PN61729-S | PN61729-S | X1 |  | 1642035 | 515-1989
1 | RLP2-200-500 | RLP2-200-500 | RLP2-200-500 | X5 |  |  | 752-9157
5 | SMS_IP67 | SMS_IP67 | IP67 | T1_LO, T2_SOE, T4_PWR, T5_ERRINH, T9_SODS |  | 1217758
1 | SP490 | SP490 | SO08 | U$5 |  | 9387234
3 | SWITCH_LED | SWITCH_LED | SWITCH_LED | T3_SOE, T8_LO, T10_SODS | 12 G 203
2 | SWITCH_LED | SWITCH_LED | SWITCH_LED | T6_PWR, T7_ERRINH | 12 G 205
1 | TEN3-2410N | TEN3-2410N | TEN3-2410N | U$10 |  |  | 801-9330
1 | TPS73125 | TPS731 | SOT25 | U7 |  | 2112625
1 | TSR_1-2450 | TSR_1-2450 | TSR-1 | U3 |  | 1696320
1 | UDN2596 | UDN2596 | DIL20 | U$4 |  | 1103848
1 | XMEGA-A4UTQFP | XMEGA-A4UTQFP | TQFP44 | U2 |  | 2066309
3 | YELLOW | LEDCHIPLED_1206 | CHIPLED_1206 | LED1_LO, LED2_SOE, LED3_SODS |  | 2099249
2 | opt | C-EUC0805K | C0805K | C10, C11
1 | opt | CRYSTALHC49S | HC49/S | Q1 |  | 1667008
3 | 0 | R-EU_R0805 | R0805 | R33, R34, R35 |  | 2309112

Sheet: VAR_RX
 | Value | Device | Package | Parts | Description | MF | MPN | OC_BUERKLIN | OC_FARNELL | OC_NEWARK | OC_RS | PACKAGE | SUPPLIER
1 |  | AK500/2 | AK500/2 | X6 | CONNECTOR |  |  |  | 1131855 | unknown
2 |  | F09HP | F09HP | X2_GROUNDSTATION, X3_DEBUG | SUB-D |  |  |  | 1207597 | unknown
1 |  | F15HP | F15HP | X4 | SUB-D |  |  |  | 1207598 | unknown
0 |  | JP1E | JP1 | JP1, JP2 | JUMPER
1 |  | ML26L | ML26L | SV1 | HARTING |  |  |  | 1096983 | unknown
1 |  | ML6 | ML6 | SV2, SV3, SV4, SV5, SV6 | HARTING |  |  |  | 1096984 | unknown | 740-7105
0 |  | SJ | SJ | SJ1, SJ2, SJ3, SJ4, SJ5, SJ6, SJ7, SJ8, SJ9 | SMD solder JUMPER
20 | 100n | C-EUC0805K | C0805K | C6, C7, C8, C9, C16, C21, C22, C23, C24, C25, C26, C27, C28, C29, C33, C36, C37, C38, C39, C40 | CAPACITOR, European symbol |  |  |  | 1759265
18 | 10k | R-EU_R0805 | R0805 | R1, R2, R3, R5, R6, R7, R8, R9, R10, R11, R21, R23, R24, R26, R27, R28, R30, R31 | RESISTOR, European symbol |  |  |  | 1887308
1 | 10u/16V | C-EUC0805K | C0805K | C32 | CAPACITOR, European symbol |  |  |  | 2320856
2 | 127 | R-EU_R0805 | R0805 | R22, R25 | RESISTOR, European symbol |  |  |  | 2141745
1 | 12V | ZENER-DIODEDO34-7 | DO34Z7 | D1 | Z-Diode |  |  |  | 1779204
0 | 1M | R-EU_R0805 | R0805 | R48 | RESISTOR, European symbol |  |  |  | 2333544
8 | 1k | R-EU_R0805 | R0805 | R16, R17, R18, R19, R20, R36, R43, R44 | RESISTOR, European symbol |  |  |  | 2332071
2 | 1k | R-EU_R0805 | R0805 | R46, R47 | RESISTOR, European symbol |  |  |  | 2332071
0 | 100 | R-EU_R0805 | R0805 | R46, R47 | RESISTOR, European symbol |  |  |  | 2332058
5 | 1u | C-EUC0805K | C0805K | C1, C2, C3, C4, C5, C17, C18, C19, C20 | CAPACITOR, European symbol |  |  |  | 2320853
2 | 22u/25V | C-EUC0805K | C0805K | C14, C15 | CAPACITOR, European symbol |  |  |  | 1907510
0 | 24/1% | R-EU_R0805 | R0805 | R12, R13, R14, R15 | RESISTOR, European symbol |  |  |  |  |  | 666-2386
2 | 270 | R-EU_R0805 | R0805 | R29, R32 | RESISTOR, European symbol |  |  |  | 2332064
4 | 2k2 | R-EU_R0805 | R0805 | R4, R37, R39, R40 | RESISTOR, European symbol |  |  |  |  |  | 679-1207
1 | 2k7 | R-EU_R0805 | R0805 | R49 | RESISTOR, European symbol |  |  |  | 2332077
1 | 330 | R-EU_R0805 | R0805 | R50 | RESISTOR, European symbol |  |  |  | 1500705
6 | 4-40/M3 | DSUB_MOUNTING_SCREW | SCREW_DUMMY | SCREW1, SCREW2, SCREW3, SCREW4, SCREW5, SCREW6 |  |  |  |  | 2135988
0 | 4n7 | C-EUC0805K | C0805K | C34 | CAPACITOR, European symbol |  |  |  | 2407305
5 | 4u7/50V | C-EUC0805K | C0805K | C12, C13, C30, C31, C35 | CAPACITOR, European symbol |  |  |  | 2346932
3 | 50k | STRK11K | VERT_POTI | U$7_BER, U$8_DROPR, U$9_DROPDUR | Potentiometer |  |  |  | 1345093
0 | ADUM3160 | ADUM3160 | SO-16W | U6 |  |  |  |  | 1843660
2 | BERNSTEIN | LEDCHIPLED_1206 | CHIPLED_1206 | LED6, LED7 | LED |  |  |  | 2322083
11 | BSS123 | BSS123 | SOT23 | Q2, Q3, Q4, Q5, Q6, Q7, Q8, Q9, Q10, Q11, Q12 | N-CHANNEL MOS FET |  |  |  | 9558640 |  | 545-0135
1 | BTS6143 | BTS6143 | TO-252-5-1 | U$6 |  |  |  |  | 1440813
2 | COIL | COIL | BOURNS-SRR0906 | L1, L2 |  |  |  |  | 2333799
1 | FDD4141TO252 | FDD4141TO252 | TO252 | Q13 | P-Channel PowerTrench� MOSFET |  |  |  | 2101406
3 | GREEN | LEDCHIPLED_1206 | CHIPLED_1206 | LED4_ERRINH, LED5_PWR, LED8 | LED |  |  |  | 2099244
4 | HCPL0600 | HCPL0600 | SOIC08 | OK1, OK2, OK3, OK4 | HEWLETT PACKARD OPTO COUPLER | AGILENT TECHNOLOGIES | HCPL-0600-000E |  | 9994696 | 88H7774
1 | black | JACK | JACK | U$3 |  |  |  |  | 1854507
1 | red | JACK | JACK | U$9 |  |  |  |  | 1854508
1 | LM1117 | LM1117 | TO252 | U4 |  |  |  |  | 1685603
1 | MAX3232ESE | MAX3232ESE | SO16 | U1 | True RS-232 Transceivers 3.0V to 5.5V, Low-Power | MAXIM | MAX3232ESE |  | 9725539 | 79C3880
1 | NC7WZ17P6X | NC7WZ17P6X | SOT65P210X110-6N | U5 | Dual Buffer |  | NC7WZ17P6X |  | 1651986 | 38C7625 |  | SC-70-6 | FAIRCHILD SEMICONDUCTOR
0 | NUP2202W1 | NUP2202W1 | SOT363_PHILIPS | U8 |  |  |  |  |  |  | 463-690
0 | PN61729-S | PN61729-S | PN61729-S | X1 | BERG USB connector |  |  |  | 1642035 | unknown | 515-1989
0 | RLP2-200-500 | RLP2-200-500 | RLP2-200-500 | X5 |  |  |  |  |  |  | 752-9157
5 | SMS_IP67 | SMS_IP67 | IP67 | T1_LO, T2_SOE, T4_PWR, T5_ERRINH, T9_SODS | Gro�er Tastschalter Taster Switch Schalter |  |  |  | 1217758
1 | SP490 | SP490 | SO08 | U$5 |  |  |  |  | 9387234
0 | SWITCH_LED | SWITCH_LED | SWITCH_LED | T3_SOE, T8_LO, T10_SODS |  |  |  | 12 G 203
0 | SWITCH_LED | SWITCH_LED | SWITCH_LED | T6_PWR, T7_ERRINH |  |  |  | 12 G 205
1 | TEN3-2410N | TEN3-2410N | TEN3-2410N | U$10 |  |  |  |  |  |  | 801-9330
1 | TPS73125 | TPS731 | SOT25 | U7 |  |  |  |  | 2112625
1 | TSR_1-2450 | TSR_1-2450 | TSR-1 | U3 | TRACO TSR-1 Series |  |  |  | 1696320
1 | UDN2596 | UDN2596 | DIL20 | U$4 |  |  |  |  | 1103848
1 | XMEGA-A4UTQFP | XMEGA-A4UTQFP | TQFP44 | U2 | Atmel XMega A4U series processor |  |  |  | 2066309
3 | YELLOW | LEDCHIPLED_1206 | CHIPLED_1206 | LED1_LO, LED2_SOE, LED3_SODS | LED |  |  |  | 2099249
0 | opt | C-EUC0805K | C0805K | C10, C11 | CAPACITOR, European symbol
0 | opt | CRYSTALHC49S | HC49/S | Q1 | CRYSTAL |  |  |  | 1667008 | unknown
2 | 0 | R-EU_R0805 | R0805 | R33, R34, R35 | RESISTOR, European symbol |  |  |  | 2309112

Sheet: VAR_ZARM
 | Value | Device | Package | Parts | Description | MF | MPN | OC_BUERKLIN | OC_FARNELL | OC_NEWARK | OC_RS | PACKAGE | SUPPLIER
1 |  | AK500/2 | AK500/2 | X6 | CONNECTOR |  |  |  | 1131855 | unknown
2 |  | F09HP | F09HP | X2_GROUNDSTATION, X3_DEBUG | SUB-D |  |  |  | 1207597 | unknown
1 |  | F15HP | F15HP | X4 | SUB-D |  |  |  | 1207598 | unknown
0 |  | JP1E | JP1 | JP1, JP2 | JUMPER
1 |  | ML26L | ML26L | SV1 | HARTING |  |  |  | 1096983 | unknown
1 |  | ML6 | ML6 | SV2, SV3, SV4, SV5, SV6 | HARTING |  |  |  | 1096984 | unknown | 740-7105
0 |  | SJ | SJ | SJ1, SJ2, SJ3, SJ4, SJ5, SJ6, SJ7, SJ8, SJ9 | SMD solder JUMPER
20 | 100n | C-EUC0805K | C0805K | C6, C7, C8, C9, C16, C21, C22, C23, C24, C25, C26, C27, C28, C29, C33, C36, C37, C38, C39, C40 | CAPACITOR, European symbol |  |  |  | 1759265
18 | 10k | R-EU_R0805 | R0805 | R1, R2, R3, R5, R6, R7, R8, R9, R10, R11, R21, R23, R24, R26, R27, R28, R30, R31 | RESISTOR, European symbol |  |  |  | 1887308
1 | 10u/16V | C-EUC0805K | C0805K | C32 | CAPACITOR, European symbol |  |  |  | 2320856
2 | 127 | R-EU_R0805 | R0805 | R22, R25 | RESISTOR, European symbol |  |  |  | 2141745
1 | 12V | ZENER-DIODEDO34-7 | DO34Z7 | D1 | Z-Diode |  |  |  | 1779204
0 | 1M | R-EU_R0805 | R0805 | R48 | RESISTOR, European symbol |  |  |  | 2333544
8 | 1k | R-EU_R0805 | R0805 | R16, R17, R18, R19, R20, R36, R43, R44 | RESISTOR, European symbol |  |  |  | 2332071
0 | 1k | R-EU_R0805 | R0805 | R46, R47 | RESISTOR, European symbol |  |  |  | 2332071
2 | 100 | R-EU_R0805 | R0805 | R46, R47 | RESISTOR, European symbol |  |  |  | 2332058
5 | 1u | C-EUC0805K | C0805K | C1, C2, C3, C4, C5, C17, C18, C19, C20 | CAPACITOR, European symbol |  |  |  | 2320853
2 | 22u/25V | C-EUC0805K | C0805K | C14, C15 | CAPACITOR, European symbol |  |  |  | 1907510
0 | 24/1% | R-EU_R0805 | R0805 | R12, R13, R14, R15 | RESISTOR, European symbol |  |  |  |  |  | 666-2386
2 | 270 | R-EU_R0805 | R0805 | R29, R32 | RESISTOR, European symbol |  |  |  | 2332064
4 | 2k2 | R-EU_R0805 | R0805 | R4, R37, R39, R40 | RESISTOR, European symbol |  |  |  |  |  | 679-1207
1 | 2k7 | R-EU_R0805 | R0805 | R49 | RESISTOR, European symbol |  |  |  | 2332077
1 | 330 | R-EU_R0805 | R0805 | R50 | RESISTOR, European symbol |  |  |  | 1500705
6 | 4-40/M3 | DSUB_MOUNTING_SCREW | SCREW_DUMMY | SCREW1, SCREW2, SCREW3, SCREW4, SCREW5, SCREW6 |  |  |  |  | 2135988
0 | 4n7 | C-EUC0805K | C0805K | C34 | CAPACITOR, European symbol |  |  |  | 2407305
5 | 4u7/50V | C-EUC0805K | C0805K | C12, C13, C30, C31, C35 | CAPACITOR, European symbol |  |  |  | 2346932
0 | 50k | STRK11K | VERT_POTI | U$7_BER, U$8_DROPR, U$9_DROPDUR | Potentiometer |  |  |  | 1345093
0 | ADUM3160 | ADUM3160 | SO-16W | U6 |  |  |  |  | 1843660
2 | BERNSTEIN | LEDCHIPLED_1206 | CHIPLED_1206 | LED6, LED7 | LED |  |  |  | 2322083
11 | BSS123 | BSS123 | SOT23 | Q2, Q3, Q4, Q5, Q6, Q7, Q8, Q9, Q10, Q11, Q12 | N-CHANNEL MOS FET |  |  |  | 9558640 |  | 545-0135
1 | BTS6143 | BTS6143 | TO-252-5-1 | U$6 |  |  |  |  | 1440813
2 | COIL | COIL | BOURNS-SRR0906 | L1, L2 |  |  |  |  | 2333799
1 | FDD4141TO252 | FDD4141TO252 | TO252 | Q13 | P-Channel PowerTrench� MOSFET |  |  |  | 2101406
1 | GREEN | LEDCHIPLED_1206 | CHIPLED_1206 | LED4_ERRINH, LED5_PWR, LED8 | LED |  |  |  | 2099244
4 | HCPL0600 | HCPL0600 | SOIC08 | OK1, OK2, OK3, OK4 | HEWLETT PACKARD OPTO COUPLER | AGILENT TECHNOLOGIES | HCPL-0600-000E |  | 9994696 | 88H7774
0 | black | JACK | JACK | U$3 |  |  |  |  | 1854507
0 | red | JACK | JACK | U$9 |  |  |  |  | 1854508
1 | LM1117 | LM1117 | TO252 | U4 |  |  |  |  | 1685603
1 | MAX3232ESE | MAX3232ESE | SO16 | U1 | True RS-232 Transceivers 3.0V to 5.5V, Low-Power | MAXIM | MAX3232ESE |  | 9725539 | 79C3880
1 | NC7WZ17P6X | NC7WZ17P6X | SOT65P210X110-6N | U5 | Dual Buffer |  | NC7WZ17P6X |  | 1651986 | 38C7625 |  | SC-70-6 | FAIRCHILD SEMICONDUCTOR
0 | NUP2202W1 | NUP2202W1 | SOT363_PHILIPS | U8 |  |  |  |  |  |  | 463-690
0 | PN61729-S | PN61729-S | PN61729-S | X1 | BERG USB connector |  |  |  | 1642035 | unknown | 515-1989
1 | RLP2-200-500 | RLP2-200-500 | RLP2-200-500 | X5 |  |  |  |  |  |  | 752-9157
0 | SMS_IP67 | SMS_IP67 | IP67 | T1_LO, T2_SOE, T4_PWR, T5_ERRINH, T9_SODS | Gro�er Tastschalter Taster Switch Schalter |  |  |  | 1217758
1 | SP490 | SP490 | SO08 | U$5 |  |  |  |  | 9387234
3 | SWITCH_LED | SWITCH_LED | SWITCH_LED | T3_SOE, T8_LO, T10_SODS |  |  |  | 12 G 203
1 | SWITCH_LED | SWITCH_LED | SWITCH_LED | T6_PWR, T7_ERRINH |  |  |  | 12 G 205
1 | TEN3-2410N | TEN3-2410N | TEN3-2410N | U$10 |  |  |  |  |  |  | 801-9330
1 | TPS73125 | TPS731 | SOT25 | U7 |  |  |  |  | 2112625
1 | TSR_1-2450 | TSR_1-2450 | TSR-1 | U3 | TRACO TSR-1 Series |  |  |  | 1696320
1 | UDN2596 | UDN2596 | DIL20 | U$4 |  |  |  |  | 1103848
1 | XMEGA-A4UTQFP | XMEGA-A4UTQFP | TQFP44 | U2 | Atmel XMega A4U series processor |  |  |  | 2066309
0 | YELLOW | LEDCHIPLED_1206 | CHIPLED_1206 | LED1_LO, LED2_SOE, LED3_SODS | LED |  |  |  | 2099249
0 | opt | C-EUC0805K | C0805K | C10, C11 | CAPACITOR, European symbol
0 | opt | CRYSTALHC49S | HC49/S | Q1 | CRYSTAL |  |  |  | 1667008 | unknown
2 | 0 | R-EU_R0805 | R0805 | R33, R34, R35 | RESISTOR, European symbol |  |  |  | 2309112

Sheet: VAR_MSTRX
 | Value | Device | Package | Parts | Description | MF | MPN | OC_BUERKLIN | OC_FARNELL | OC_NEWARK | OC_RS | PACKAGE | SUPPLIER
1 |  | AK500/2 | AK500/2 | X6 | CONNECTOR |  |  |  | 1131855 | unknown
2 |  | F09HP | F09HP | X2_GROUNDSTATION, X3_DEBUG | SUB-D |  |  |  | 1207597 | unknown
1 |  | F15HP | F15HP | X4 | SUB-D |  |  |  | 1207598 | unknown
0 |  | JP1E | JP1 | JP1, JP2 | JUMPER
1 |  | ML26L | ML26L | SV1 | HARTING |  |  |  | 1096983 | unknown
5 |  | ML6 | ML6 | SV2, SV3, SV4, SV5, SV6 | HARTING |  |  |  | 1096984 | unknown | 740-7105
0 |  | SJ | SJ | SJ1, SJ2, SJ3, SJ4, SJ5, SJ6, SJ7, SJ8, SJ9 | SMD solder JUMPER
20 | 100n | C-EUC0805K | C0805K | C6, C7, C8, C9, C16, C21, C22, C23, C24, C25, C26, C27, C28, C29, C33, C36, C37, C38, C39, C40 | CAPACITOR, European symbol |  |  |  | 1759265
18 | 10k | R-EU_R0805 | R0805 | R1, R2, R3, R5, R6, R7, R8, R9, R10, R11, R21, R23, R24, R26, R27, R28, R30, R31 | RESISTOR, European symbol |  |  |  | 1887308
1 | 10u/16V | C-EUC0805K | C0805K | C32 | CAPACITOR, European symbol |  |  |  | 2320856
2 | 127 | R-EU_R0805 | R0805 | R22, R25 | RESISTOR, European symbol |  |  |  | 2141745
1 | 12V | ZENER-DIODEDO34-7 | DO34Z7 | D1 | Z-Diode |  |  |  | 1779204
1 | 1M | R-EU_R0805 | R0805 | R48 | RESISTOR, European symbol |  |  |  | 2333544
8 | 1k | R-EU_R0805 | R0805 | R16, R17, R18, R19, R20, R36, R43, R44 | RESISTOR, European symbol |  |  |  | 2332071
2 | 1k | R-EU_R0805 | R0805 | R46, R47 | RESISTOR, European symbol |  |  |  | 2332071
0 | 100 | R-EU_R0805 | R0805 | R46, R47 | RESISTOR, European symbol |  |  |  | 2332058
9 | 1u | C-EUC0805K | C0805K | C1, C2, C3, C4, C5, C17, C18, C19, C20 | CAPACITOR, European symbol |  |  |  | 2320853
2 | 22u/25V | C-EUC0805K | C0805K | C14, C15 | CAPACITOR, European symbol |  |  |  | 1907510
4 | 24/1% | R-EU_R0805 | R0805 | R12, R13, R14, R15 | RESISTOR, European symbol |  |  |  |  |  | 666-2386
2 | 270 | R-EU_R0805 | R0805 | R29, R32 | RESISTOR, European symbol |  |  |  | 2332064
4 | 2k2 | R-EU_R0805 | R0805 | R4, R37, R39, R40 | RESISTOR, European symbol |  |  |  |  |  | 679-1207
1 | 2k7 | R-EU_R0805 | R0805 | R49 | RESISTOR, European symbol |  |  |  | 2332077
1 | 330 | R-EU_R0805 | R0805 | R50 | RESISTOR, European symbol |  |  |  | 1500705
6 | 4-40/M3 | DSUB_MOUNTING_SCREW | SCREW_DUMMY | SCREW1, SCREW2, SCREW3, SCREW4, SCREW5, SCREW6 |  |  |  |  | 2135988
1 | 4n7 | C-EUC0805K | C0805K | C34 | CAPACITOR, European symbol |  |  |  | 2407305
5 | 4u7/50V | C-EUC0805K | C0805K | C12, C13, C30, C31, C35 | CAPACITOR, European symbol |  |  |  | 2346932
3 | 50k | STRK11K | VERT_POTI | U$7_BER, U$8_DROPR, U$9_DROPDUR | Potentiometer |  |  |  | 1345093
1 | ADUM3160 | ADUM3160 | SO-16W | U6 |  |  |  |  | 1843660
2 | BERNSTEIN | LEDCHIPLED_1206 | CHIPLED_1206 | LED6, LED7 | LED |  |  |  | 2322083
11 | BSS123 | BSS123 | SOT23 | Q2, Q3, Q4, Q5, Q6, Q7, Q8, Q9, Q10, Q11, Q12 | N-CHANNEL MOS FET |  |  |  | 9558640 |  | 545-0135
1 | BTS6143 | BTS6143 | TO-252-5-1 | U$6 |  |  |  |  | 1440813
2 | COIL | COIL | BOURNS-SRR0906 | L1, L2 |  |  |  |  | 2333799
1 | FDD4141TO252 | FDD4141TO252 | TO252 | Q13 | P-Channel PowerTrench� MOSFET |  |  |  | 2101406
3 | GREEN | LEDCHIPLED_1206 | CHIPLED_1206 | LED4_ERRINH, LED5_PWR, LED8 | LED |  |  |  | 2099244
4 | HCPL0600 | HCPL0600 | SOIC08 | OK1, OK2, OK3, OK4 | HEWLETT PACKARD OPTO COUPLER | AGILENT TECHNOLOGIES | HCPL-0600-000E |  | 9994696 | 88H7774
1 | black | JACK | JACK | U$3 |  |  |  |  | 1854507
1 | red | JACK | JACK | U$9 |  |  |  |  | 1854508
1 | LM1117 | LM1117 | TO252 | U4 |  |  |  |  | 1685603
1 | MAX3232ESE | MAX3232ESE | SO16 | U1 | True RS-232 Transceivers 3.0V to 5.5V, Low-Power | MAXIM | MAX3232ESE |  | 9725539 | 79C3880
1 | NC7WZ17P6X | NC7WZ17P6X | SOT65P210X110-6N | U5 | Dual Buffer |  | NC7WZ17P6X |  | 1651986 | 38C7625 |  | SC-70-6 | FAIRCHILD SEMICONDUCTOR
1 | NUP2202W1 | NUP2202W1 | SOT363_PHILIPS | U8 |  |  |  |  |  |  | 463-690
1 | PN61729-S | PN61729-S | PN61729-S | X1 | BERG USB connector |  |  |  | 1642035 | unknown | 515-1989
0 | RLP2-200-500 | RLP2-200-500 | RLP2-200-500 | X5 |  |  |  |  |  |  | 752-9157
5 | SMS_IP67 | SMS_IP67 | IP67 | T1_LO, T2_SOE, T4_PWR, T5_ERRINH, T9_SODS | Gro�er Tastschalter Taster Switch Schalter |  |  |  | 1217758
1 | SP490 | SP490 | SO08 | U$5 |  |  |  |  | 9387234
0 | SWITCH_LED | SWITCH_LED | SWITCH_LED | T3_SOE, T8_LO, T10_SODS |  |  |  | 12 G 203
0 | SWITCH_LED | SWITCH_LED | SWITCH_LED | T6_PWR, T7_ERRINH |  |  |  | 12 G 205
1 | TEN3-2410N | TEN3-2410N | TEN3-2410N | U$10 |  |  |  |  |  |  | 801-9330
1 | TPS73125 | TPS731 | SOT25 | U7 |  |  |  |  | 2112625
1 | TSR_1-2450 | TSR_1-2450 | TSR-1 | U3 | TRACO TSR-1 Series |  |  |  | 1696320
1 | UDN2596 | UDN2596 | DIL20 | U$4 |  |  |  |  | 1103848
1 | XMEGA-A4UTQFP | XMEGA-A4UTQFP | TQFP44 | U2 | Atmel XMega A4U series processor |  |  |  | 2066309
3 | YELLOW | LEDCHIPLED_1206 | CHIPLED_1206 | LED1_LO, LED2_SOE, LED3_SODS | LED |  |  |  | 2099249
0 | opt | C-EUC0805K | C0805K | C10, C11 | CAPACITOR, European symbol
0 | opt | CRYSTALHC49S | HC49/S | Q1 | CRYSTAL |  |  |  | 1667008 | unknown
2 | 0 | R-EU_R0805 | R0805 | R33, R34, R35 | RESISTOR, European symbol |  |  |  | 2309112

Sheet: VAR_MSTZARM
 | Value | Device | Package | Parts | Description | MF | MPN | OC_BUERKLIN | OC_FARNELL | OC_NEWARK | OC_RS | PACKAGE | SUPPLIER
1 |  | AK500/2 | AK500/2 | X6 | CONNECTOR |  |  |  | 1131855 | unknown
2 |  | F09HP | F09HP | X2_GROUNDSTATION, X3_DEBUG | SUB-D |  |  |  | 1207597 | unknown
1 |  | F15HP | F15HP | X4 | SUB-D |  |  |  | 1207598 | unknown
0 |  | JP1E | JP1 | JP1, JP2 | JUMPER
1 |  | ML26L | ML26L | SV1 | HARTING |  |  |  | 1096983 | unknown
5 |  | ML6 | ML6 | SV2, SV3, SV4, SV5, SV6 | HARTING |  |  |  | 1096984 | unknown | 740-7105
0 |  | SJ | SJ | SJ1, SJ2, SJ3, SJ4, SJ5, SJ6, SJ7, SJ8, SJ9 | SMD solder JUMPER
20 | 100n | C-EUC0805K | C0805K | C6, C7, C8, C9, C16, C21, C22, C23, C24, C25, C26, C27, C28, C29, C33, C36, C37, C38, C39, C40 | CAPACITOR, European symbol |  |  |  | 1759265
18 | 10k | R-EU_R0805 | R0805 | R1, R2, R3, R5, R6, R7, R8, R9, R10, R11, R21, R23, R24, R26, R27, R28, R30, R31 | RESISTOR, European symbol |  |  |  | 1887308
1 | 10u/16V | C-EUC0805K | C0805K | C32 | CAPACITOR, European symbol |  |  |  | 2320856
2 | 127 | R-EU_R0805 | R0805 | R22, R25 | RESISTOR, European symbol |  |  |  | 2141745
1 | 12V | ZENER-DIODEDO34-7 | DO34Z7 | D1 | Z-Diode |  |  |  | 1779204
1 | 1M | R-EU_R0805 | R0805 | R48 | RESISTOR, European symbol |  |  |  | 2333544
8 | 1k | R-EU_R0805 | R0805 | R16, R17, R18, R19, R20, R36, R43, R44 | RESISTOR, European symbol |  |  |  | 2332071
0 | 1k | R-EU_R0805 | R0805 | R46, R47 | RESISTOR, European symbol |  |  |  | 2332071
2 | 100 | R-EU_R0805 | R0805 | R46, R47 | RESISTOR, European symbol |  |  |  | 2332058
9 | 1u | C-EUC0805K | C0805K | C1, C2, C3, C4, C5, C17, C18, C19, C20 | CAPACITOR, European symbol |  |  |  | 2320853
2 | 22u/25V | C-EUC0805K | C0805K | C14, C15 | CAPACITOR, European symbol |  |  |  | 1907510
4 | 24/1% | R-EU_R0805 | R0805 | R12, R13, R14, R15 | RESISTOR, European symbol |  |  |  |  |  | 666-2386
2 | 270 | R-EU_R0805 | R0805 | R29, R32 | RESISTOR, European symbol |  |  |  | 2332064
4 | 2k2 | R-EU_R0805 | R0805 | R4, R37, R39, R40 | RESISTOR, European symbol |  |  |  |  |  | 679-1207
1 | 2k7 | R-EU_R0805 | R0805 | R49 | RESISTOR, European symbol |  |  |  | 2332077
1 | 330 | R-EU_R0805 | R0805 | R50 | RESISTOR, European symbol |  |  |  | 1500705
6 | 4-40/M3 | DSUB_MOUNTING_SCREW | SCREW_DUMMY | SCREW1, SCREW2, SCREW3, SCREW4, SCREW5, SCREW6 |  |  |  |  | 2135988
1 | 4n7 | C-EUC0805K | C0805K | C34 | CAPACITOR, European symbol |  |  |  | 2407305
5 | 4u7/50V | C-EUC0805K | C0805K | C12, C13, C30, C31, C35 | CAPACITOR, European symbol |  |  |  | 2346932
3 | 50k | STRK11K | VERT_POTI | U$7_BER, U$8_DROPR, U$9_DROPDUR | Potentiometer |  |  |  | 1345093
1 | ADUM3160 | ADUM3160 | SO-16W | U6 |  |  |  |  | 1843660
2 | BERNSTEIN | LEDCHIPLED_1206 | CHIPLED_1206 | LED6, LED7 | LED |  |  |  | 2322083
11 | BSS123 | BSS123 | SOT23 | Q2, Q3, Q4, Q5, Q6, Q7, Q8, Q9, Q10, Q11, Q12 | N-CHANNEL MOS FET |  |  |  | 9558640 |  | 545-0135
1 | BTS6143 | BTS6143 | TO-252-5-1 | U$6 |  |  |  |  | 1440813
2 | COIL | COIL | BOURNS-SRR0906 | L1, L2 |  |  |  |  | 2333799
1 | FDD4141TO252 | FDD4141TO252 | TO252 | Q13 | P-Channel PowerTrench� MOSFET |  |  |  | 2101406
1 | GREEN | LEDCHIPLED_1206 | CHIPLED_1206 | LED4_ERRINH, LED5_PWR, LED8 | LED |  |  |  | 2099244
4 | HCPL0600 | HCPL0600 | SOIC08 | OK1, OK2, OK3, OK4 | HEWLETT PACKARD OPTO COUPLER | AGILENT TECHNOLOGIES | HCPL-0600-000E |  | 9994696 | 88H7774
0 | black | JACK | JACK | U$3 |  |  |  |  | 1854507
0 | red | JACK | JACK | U$9 |  |  |  |  | 1854508
1 | LM1117 | LM1117 | TO252 | U4 |  |  |  |  | 1685603
1 | MAX3232ESE | MAX3232ESE | SO16 | U1 | True RS-232 Transceivers 3.0V to 5.5V, Low-Power | MAXIM | MAX3232ESE |  | 9725539 | 79C3880
1 | NC7WZ17P6X | NC7WZ17P6X | SOT65P210X110-6N | U5 | Dual Buffer |  | NC7WZ17P6X |  | 1651986 | 38C7625 |  | SC-70-6 | FAIRCHILD SEMICONDUCTOR
1 | NUP2202W1 | NUP2202W1 | SOT363_PHILIPS | U8 |  |  |  |  |  |  | 463-690
1 | PN61729-S | PN61729-S | PN61729-S | X1 | BERG USB connector |  |  |  | 1642035 | unknown | 515-1989
1 | RLP2-200-500 | RLP2-200-500 | RLP2-200-500 | X5 |  |  |  |  |  |  | 752-9157
0 | SMS_IP67 | SMS_IP67 | IP67 | T1_LO, T2_SOE, T4_PWR, T5_ERRINH, T9_SODS | Gro�er Tastschalter Taster Switch Schalter |  |  |  | 1217758
1 | SP490 | SP490 | SO08 | U$5 |  |  |  |  | 9387234
3 | SWITCH_LED | SWITCH_LED | SWITCH_LED | T3_SOE, T8_LO, T10_SODS |  |  |  | 12 G 203
2 | SWITCH_LED | SWITCH_LED | SWITCH_LED | T6_PWR, T7_ERRINH |  |  |  | 12 G 205
1 | TEN3-2410N | TEN3-2410N | TEN3-2410N | U$10 |  |  |  |  |  |  | 801-9330
1 | TPS73125 | TPS731 | SOT25 | U7 |  |  |  |  | 2112625
1 | TSR_1-2450 | TSR_1-2450 | TSR-1 | U3 | TRACO TSR-1 Series |  |  |  | 1696320
1 | UDN2596 | UDN2596 | DIL20 | U$4 |  |  |  |  | 1103848
1 | XMEGA-A4UTQFP | XMEGA-A4UTQFP | TQFP44 | U2 | Atmel XMega A4U series processor |  |  |  | 2066309
0 | YELLOW | LEDCHIPLED_1206 | CHIPLED_1206 | LED1_LO, LED2_SOE, LED3_SODS | LED |  |  |  | 2099249
0 | opt | C-EUC0805K | C0805K | C10, C11 | CAPACITOR, European symbol
0 | opt | CRYSTALHC49S | HC49/S | Q1 | CRYSTAL |  |  |  | 1667008 | unknown
2 | 0 | R-EU_R0805 | R0805 | R33, R34, R35 | RESISTOR, European symbol |  |  |  | 2309112

Sheet: VAR_Bestückung
Qty | Value | Device | Package | Parts | Description | MF | MPN | OC_BUERKLIN | OC_FARNELL | OC_NEWARK | OC_RS | PACKAGE | SUPPLIER
1 |  | AK500/2 | AK500/2 | X6 | CONNECTOR |  |  |  | 1131855 | unknown
2 |  | F09HP | F09HP | X2_GROUNDSTATION, X3_DEBUG | SUB-D |  |  |  | 1207597 | unknown
1 |  | F15HP | F15HP | X4 | SUB-D |  |  |  | 1207598 | unknown
0 |  | JP1E | JP1 | JP1, JP2 | JUMPER
1 |  | ML26L | ML26L | SV1 | HARTING |  |  |  | 1096983 | unknown
1 |  | ML6 | ML6 | SV2, SV3, SV4, SV5, SV6 | HARTING |  |  |  | 1096984 | unknown | 740-7105
0 |  | SJ | SJ | SJ1, SJ2, SJ3, SJ4, SJ5, SJ6, SJ7, SJ8, SJ9 | SMD solder JUMPER
20 | 100n | C-EUC0805K | C0805K | C6, C7, C8, C9, C16, C21, C22, C23, C24, C25, C26, C27, C28, C29, C33, C36, C37, C38, C39, C40 | CAPACITOR, European symbol |  |  |  | 1759265
18 | 10k | R-EU_R0805 | R0805 | R1, R2, R3, R5, R6, R7, R8, R9, R10, R11, R21, R23, R24, R26, R27, R28, R30, R31 | RESISTOR, European symbol |  |  |  | 1887308
1 | 10u/16V | C-EUC0805K | C0805K | C32 | CAPACITOR, European symbol |  |  |  | 2320856
2 | 127 | R-EU_R0805 | R0805 | R22, R25 | RESISTOR, European symbol |  |  |  | 2141745
1 | 12V | ZENER-DIODEDO34-7 | DO34Z7 | D1 | Z-Diode |  |  |  | 1779204
0 | 1M | R-EU_R0805 | R0805 | R48 | RESISTOR, European symbol |  |  |  | 2333544
8 | 1k | R-EU_R0805 | R0805 | R16, R17, R18, R19, R20, R36, R43, R44 | RESISTOR, European symbol |  |  |  | 2332071
2 | 1k | R-EU_R0805 | R0805 | R46, R47 | RESISTOR, European symbol |  |  |  | 2332071
0 | 100 | R-EU_R0805 | R0805 | R46, R47 | RESISTOR, European symbol |  |  |  | 2332058
5 | 1u | C-EUC0805K | C0805K | C1, C2, C3, C4, C5, C17, C18, C19, C20 | CAPACITOR, European symbol |  |  |  | 2320853
2 | 22u/25V | C-EUC0805K | C0805K | C14, C15 | CAPACITOR, European symbol |  |  |  | 1907510
0 | 24/1% | R-EU_R0805 | R0805 | R12, R13, R14, R15 | RESISTOR, European symbol |  |  |  |  |  | 666-2386
2 | 270 | R-EU_R0805 | R0805 | R29, R32 | RESISTOR, European symbol |  |  |  | 2332064
4 | 2k2 | R-EU_R0805 | R0805 | R4, R37, R39, R40 | RESISTOR, European symbol |  |  |  |  |  | 679-1207
1 | 2k7 | R-EU_R0805 | R0805 | R49 | RESISTOR, European symbol |  |  |  | 2332077
1 | 330 | R-EU_R0805 | R0805 | R50 | RESISTOR, European symbol |  |  |  | 1500705
0 | 4-40/M3 | DSUB_MOUNTING_SCREW | SCREW_DUMMY | SCREW1, SCREW2, SCREW3, SCREW4, SCREW5, SCREW6 |  |  |  |  | 2135988
0 | 4n7 | C-EUC0805K | C0805K | C34 | CAPACITOR, European symbol |  |  |  | 2407305
5 | 4u7/50V | C-EUC0805K | C0805K | C12, C13, C30, C31, C35 | CAPACITOR, European symbol |  |  |  | 2346932
0 | 10k | STRK11K | VERT_POTI | U$7_BER, U$8_DROPR, U$9_DROPDUR | Potentiometer |  |  |  |  |  | 737-7833P
0 | ADUM3160 | ADUM3160 | SO-16W | U6 |  |  |  |  | 1843660
2 | BERNSTEIN | LEDCHIPLED_1206 | CHIPLED_1206 | LED6, LED7 | LED |  |  |  | 2322083
11 | BSS123 | BSS123 | SOT23 | Q2, Q3, Q4, Q5, Q6, Q7, Q8, Q9, Q10, Q11, Q12 | N-CHANNEL MOS FET |  |  |  | 9558640 |  | 545-0135
1 | BTS6143 | BTS6143 | TO-252-5-1 | U$6 |  |  |  |  | 1440813
2 | COIL | COIL | BOURNS-SRR0906 | L1, L2 |  |  |  |  | 2333799
1 | FDD4141TO252 | FDD4141TO252 | TO252 | Q13 | P-Channel PowerTrench� MOSFET |  |  |  | 2101406
3 | GREEN | LEDCHIPLED_1206 | CHIPLED_1206 | LED4_ERRINH, LED5_PWR, LED8 | LED |  |  |  | 2099244
4 | HCPL0600 | HCPL0600 | SOIC08 | OK1, OK2, OK3, OK4 | HEWLETT PACKARD OPTO COUPLER | AGILENT TECHNOLOGIES | HCPL-0600-000E |  | 9994696 | 88H7774
0 | black | JACK | JACK | U$3 |  |  |  |  | 1854507
0 | red | JACK | JACK | U$9 |  |  |  |  | 1854508
1 | LM1117 | LM1117 | TO252 | U4 |  |  |  |  | 1685603
1 | MAX3232ESE | MAX3232ESE | SO16 | U1 | True RS-232 Transceivers 3.0V to 5.5V, Low-Power | MAXIM | MAX3232ESE |  | 9725539 | 79C3880
1 | NC7WZ17P6X | NC7WZ17P6X | SOT65P210X110-6N | U5 | Dual Buffer |  | NC7WZ17P6X |  | 1651986 | 38C7625 |  | SC-70-6 | FAIRCHILD SEMICONDUCTOR
0 | NUP2202W1 | NUP2202W1 | SOT363_PHILIPS | U8 |  |  |  |  |  |  | 463-690
0 | PN61729-S | PN61729-S | PN61729-S | X1 | BERG USB connector |  |  |  | 1642035 | unknown | 515-1989
0 | RLP2-200-500 | RLP2-200-500 | RLP2-200-500 | X5 |  |  |  |  |  |  | 752-9157
0 | SMS_IP67 | SMS_IP67 | IP67 | T1_LO, T2_SOE, T4_PWR, T5_ERRINH, T9_SODS | Gro�er Tastschalter Taster Switch Schalter |  |  |  | 1217758
1 | SP490 | SP490 | SO08 | U$5 |  |  |  |  | 9387234
0 | SWITCH_LED | SWITCH_LED | SWITCH_LED | T3_SOE, T8_LO, T10_SODS |  |  |  | 12 G 203
0 | SWITCH_LED | SWITCH_LED | SWITCH_LED | T6_PWR, T7_ERRINH |  |  |  | 12 G 205
1 | TEN3-2410N | TEN3-2410N | TEN3-2410N | U$10 |  |  |  |  |  |  | 801-9330
1 | TPS73125 | TPS731 | SOT25 | U7 |  |  |  |  | 2112625
1 | TSR_1-2450 | TSR_1-2450 | TSR-1 | U3 | TRACO TSR-1 Series |  |  |  | 1696320
1 | UDN2596 | UDN2596 | DIL20 | U$4 |  |  |  |  | 1103848
1 | XMEGA-A4UTQFP | XMEGA-A4UTQFP | TQFP44 | U2 | Atmel XMega A4U series processor |  |  |  | 2066309
3 | YELLOW | LEDCHIPLED_1206 | CHIPLED_1206 | LED1_LO, LED2_SOE, LED3_SODS | LED |  |  |  | 2099249
0 | opt | C-EUC0805K | C0805K | C10, C11 | CAPACITOR, European symbol
0 | opt | CRYSTALHC49S | HC49/S | Q1 | CRYSTAL |  |  |  | 1667008 | unknown
2 | 0 | R-EU_R0805 | R0805 | R33, R34, R35 | RESISTOR, European symbol |  |  |  | 2309112

Sheet: SUM
Qty
Bestückung | VAR_RX | VAR_ZARM | VAR_MSTRX | VAR_MSTZARM
22 | 14 | 6 | 1 | 1
 |  |  |  |  |  |  |  |  | Extra Factor
 |  |  |  |  |  |  |  |  | 0.1
Qty | Value | Device | Parts | Description | OC_BUERKLIN | OC_FARNELL | OC_RS | Total_Min | Extra | Total Needed | Lagerbestand | Need to order
1 | 0 | AK500/2 | X6 | CONNECTOR | 0 | 1131855 | 0 | 22 | 2.2 | 25 | 13 | 12
2 | 0 | F09HP | X2_GROUNDSTATION, X3_DEBUG | SUB-D | 0 | 1207597 | 0 | 44 | 4.4 | 49 | 34 | 15
1 | 0 | F15HP | X4 | SUB-D | 0 | 1207598 | 0 | 22 | 2.2 | 25 | 18 | 7
0 | 0 | JP1E | JP1, JP2 | JUMPER | 0 | 0 | 0 | 0 | 0 | 0 | 0 | 0
1 | 0 | ML26L | SV1 | HARTING | 0 | 1096983 | 0 | 22 | 2.2 | 25 | 7 | 18
1 | 0 | ML6 | SV2, SV3, SV4, SV5, SV6 | HARTING | 0 | 1096984 | 740-7105 | 30 | 3 | 33 | 17 | 16
0 | 0 | SJ | SJ1, SJ2, SJ3, SJ4, SJ5, SJ6, SJ7, SJ8, SJ9 | SMD solder JUMPER | 0 | 0 | 0 | 0 | 0 | 0 | 0 | 0
20 | 100n | C-EUC0805K | C6, C7, C8, C9, C16, C21, C22, C23, C24, C25, C26, C27, C28, C29, C33, C36, C37, C38, C39, C40 | CAPACITOR, European symbol | 0 | 1759265 | 0 | 440 | 44 | 484 | 320 | 164
18 | 10k | R-EU_R0805 | R1, R2, R3, R5, R6, R7, R8, R9, R10, R11, R21, R23, R24, R26, R27, R28, R30, R31 | RESISTOR, European symbol | 0 | 1887308 | 0 | 396 | 39.6 | 436 | 291 | 145
1 | 10u/16V | C-EUC0805K | C32 | CAPACITOR, European symbol | 0 | 2320856 | 0 | 22 | 2.2 | 25 | 18 | 7
2 | 127 | R-EU_R0805 | R22, R25 | RESISTOR, European symbol | 0 | 2141745 | 0 | 44 | 4.4 | 49 | 34 | 15
1 | 12V | ZENER-DIODEDO34-7 | D1 | Z-Diode | 0 | 1779204 | 0 | 22 | 2.2 | 25 | 0 | 25
0 | 1M | R-EU_R0805 | R48 | RESISTOR, European symbol | 0 | 2333544 | 0 | 2 | 0 | 2 | 2 | 0
8 | 1k | R-EU_R0805 | R16, R17, R18, R19, R20, R36, R43, R44 | RESISTOR, European symbol | 0 | 2332071 | 0 | 176 | 17.6 | 194 | 80 | 114
2 | 1k | R-EU_R0805 | R46, R47 | RESISTOR, European symbol | 0 | 2332071 | 0 | 44 | 4.4 | 49 | 0 | 49
0 | 100 | R-EU_R0805 | R46, R47 | RESISTOR, European symbol | 0 | 2332058 | 0 | 14 | 0 | 14 | 0 | 14
5 | 1u | C-EUC0805K | C1, C2, C3, C4, C5, C17, C18, C19, C20 | CAPACITOR, European symbol | 0 | 2320853 | 0 | 118 | 11.8 | 130 | 92 | 38
2 | 22u/25V | C-EUC0805K | C14, C15 | CAPACITOR, European symbol | 0 | 1907510 | 0 | 44 | 4.4 | 49 | 36 | 13
0 | 24/1% | R-EU_R0805 | R12, R13, R14, R15 | RESISTOR, European symbol | 0 | 0 | 666-2386 | 8 | 0 | 8 | 10 | 0
2 | 270 | R-EU_R0805 | R29, R32 | RESISTOR, European symbol | 0 | 2332064 | 0 | 44 | 4.4 | 49 | 36 | 13
4 | 2k2 | R-EU_R0805 | R4, R37, R39, R40 | RESISTOR, European symbol | 0 | 0 | 679-1207 | 88 | 8.8 | 97 | 0 | 97
1 | 2k7 | R-EU_R0805 | R49 | RESISTOR, European symbol | 0 | 2332077 | 0 | 22 | 2.2 | 25 | 0 | 25
1 | 330 | R-EU_R0805 | R50 | RESISTOR, European symbol | 0 | 1500705 | 0 | 22 | 2.2 | 25 | 18 | 7
0 | 4-40/M3 | DSUB_MOUNTING_SCREW | SCREW1, SCREW2, SCREW3, SCREW4, SCREW5, SCREW6 | 0 | 0 | 2135988 | 0 | 132 | 0 | 132 | 0 | 132
0 | 4n7 | C-EUC0805K | C34 | CAPACITOR, European symbol | 0 | 2407305 | 0 | 2 | 0 | 2 | 2 | 0
5 | 4u7/50V | C-EUC0805K | C12, C13, C30, C31, C35 | CAPACITOR, European symbol | 0 | 2346932 | 0 | 110 | 11 | 121 | 90 | 31
0 | 10k | STRK11K | U$7_BER, U$8_DROPR, U$9_DROPDUR | Potentiometer | 0 | 0 | 737-7833P | 48 | 0 | 48 | 33 | 15
0 | ADUM3160 | ADUM3160 | U6 | 0 | 0 | 1843660 | 0 | 2 | 0 | 2 | 2 | 0
2 | BERNSTEIN | LEDCHIPLED_1206 | LED6, LED7 | LED | 0 | 2322083 | 0 | 44 | 4.4 | 49 | 34 | 15
11 | BSS123 | BSS123 | Q2, Q3, Q4, Q5, Q6, Q7, Q8, Q9, Q10, Q11, Q12 | N-CHANNEL MOS FET | 0 | 9558640 | 545-0135 | 242 | 24.2 | 267 | 188 | 79
1 | BTS6143 | BTS6143 | U$6 | 0 | 0 | 1440813 | 0 | 22 | 2.2 | 25 | 17 | 8
2 | COIL | COIL | L1, L2 | 0 | 0 | 2333799 | 0 | 44 | 4.4 | 49 | 34 | 15
1 | FDD4141TO252 | FDD4141TO252 | Q13 | P-Channel PowerTrench� MOSFET | 0 | 2101406 | 0 | 22 | 2.2 | 25 | 0 | 25
3 | GREEN | LEDCHIPLED_1206 | LED4_ERRINH, LED5_PWR, LED8 | LED | 0 | 2099244 | 0 | 66 | 6.6 | 73 | 31 | 42
4 | HCPL0600 | HCPL0600 | OK1, OK2, OK3, OK4 | HEWLETT PACKARD OPTO COUPLER | 0 | 9994696 | 0 | 88 | 8.8 | 97 | 68 | 29
0 | black | JACK | U$3 | 0 | 0 | 1854507 | 0 | 15 | 0 | 15 | 0 | 15
0 | red | JACK | U$9 | 0 | 0 | 1854508 | 0 | 15 | 0 | 15 | 0 | 15
1 | LM1117 | LM1117 | U4 | 0 | 0 | 1685603 | 0 | 22 | 2.2 | 25 | 17 | 8
1 | MAX3232ESE | MAX3232ESE | U1 | True RS-232 Transceivers 3.0V to 5.5V, Low-Power | 0 | 9725539 | 0 | 22 | 2.2 | 25 | 17 | 8
1 | NC7WZ17P6X | NC7WZ17P6X | U5 | Dual Buffer | 0 | 1651986 | 0 | 22 | 2.2 | 25 | 17 | 8
0 | NUP2202W1 | NUP2202W1 | U8 | 0 | 0 | 0 | 463-690 | 2 | 0 | 2 | 8 | 0
0 | PN61729-S | PN61729-S | X1 | BERG USB connector | 0 | 1642035 | 515-1989 | 2 | 0 | 2 | 2 | 0
0 | RLP2-200-500 | RLP2-200-500 | X5 | 0 | 0 | 0 | 752-9157 | 7 | 0 | 7 | 10 | 0
0 | SMS_IP67 | SMS_IP67 | T1_LO, T2_SOE, T4_PWR, T5_ERRINH, T9_SODS | Gro�er Tastschalter Taster Switch Schalter | 0 | 1217758 | 0 | 75 | 0 | 75 | 50 | 25
1 | SP490 | SP490 | U$5 | 0 | 0 | 9387234 | 0 | 22 | 2.2 | 25 | 17 | 8
0 | SWITCH_LED | SWITCH_LED | T3_SOE, T8_LO, T10_SODS | 0 | 12 G 203 | 0 | 0 | 21 | 0 | 21 | 21 | 0
0 | SWITCH_LED | SWITCH_LED | T6_PWR, T7_ERRINH | 0 | 12 G 205 | 0 | 0 | 8 | 0 | 8 | 10 | 0
1 | TEN3-2410N | TEN3-2410N | U$10 | 0 | 0 | 0 | 801-9330 | 22 | 2.2 | 25 | 17 | 8
1 | TPS73125 | TPS731 | U7 | 0 | 0 | 2112625 | 0 | 22 | 2.2 | 25 | 17 | 8
1 | TSR_1-2450 | TSR_1-2450 | U3 | TRACO TSR-1 Series | 0 | 1696320 | 0 | 22 | 2.2 | 25 | 17 | 8
1 | UDN2596 | UDN2596 | U$4 | 0 | 0 | 1103848 | 0 | 22 | 2.2 | 25 | 18 | 7
1 | XMEGA-A4UTQFP | XMEGA-A4UTQFP | U2 | Atmel XMega A4U series processor | 0 | 2066309 | 0 | 22 | 2.2 | 25 | 17 | 8
3 | YELLOW | LEDCHIPLED_1206 | LED1_LO, LED2_SOE, LED3_SODS | LED | 0 | 2099249 | 0 | 66 | 6.6 | 73 | 30 | 43
0 | opt | C-EUC0805K | C10, C11 | CAPACITOR, European symbol | 0 | 0 | 0 | 0 | 0 | 0 | 0 | 0
0 | opt | CRYSTALHC49S | Q1 | CRYSTAL | 0 | 1667008 | 0 | 0 | 0 | 0 | 0 | 0
2 | 0 | R-EU_R0805 | R33, R34, R35 | RESISTOR, European symbol | 0 | 2309112 | 0 | 44 | 4.4 | 49 | 34 | 15
0 | 0 | 0 | 0 | 0 | 0 | 0 | 0 | 0 | 0 | 0 |  | 0
0 | 0 | 0 | 0 | 0 | 0 | 0 | 0 | 0 | 0 | 0 |  | 0
0 | 0 | 0 | 0 | 0 | 0 | 0 | 0 | 0 | 0 | 0 |  | 0
0 | 0 | 0 | 0 | 0 | 0 | 0 | 0 | 0 | 0 | 0 |  | 0
0 | 0 | 0 | 0 | 0 | 0 | 0 | 0 | 0 | 0 | 0 |  | 0
0 | 0 | 0 | 0 | 0 | 0 | 0 | 0 | 0 | 0 | 0 |  | 0
0 | 0 | 0 | 0 | 0 | 0 | 0 | 0 | 0 | 0 | 0 |  | 0
0 | 0 | 0 | 0 | 0 | 0 | 0 | 0 | 0 | 0 | 0 |  | 0
0 | 0 | 0 | 0 | 0 | 0 | 0 | 0 | 0 | 0 | 0 |  | 0
0 | 0 | 0 | 0 | 0 | 0 | 0 | 0 | 0 | 0 | 0 |  | 0
0 | 0 | 0 | 0 | 0 | 0 | 0 | 0 | 0 | 0 | 0 |  | 0
0 | 0 | 0 | 0 | 0 | 0 | 0 | 0 | 0 | 0 | 0 |  | 0
0 | 0 | 0 | 0 | 0 | 0 | 0 | 0 | 0 | 0 | 0 |  | 0
0 | 0 | 0 | 0 | 0 | 0 | 0 | 0 | 0 | 0 | 0 |  | 0
0 | 0 | 0 | 0 | 0 | 0 | 0 | 0 | 0 | 0 | 0 |  | 0
0 | 0 | 0 | 0 | 0 | 0 | 0 | 0 | 0 | 0 | 0 |  | 0
0 | 0 | 0 | 0 | 0 | 0 | 0 | 0 | 0 | 0 | 0 |  | 0
0 | 0 | 0 | 0 | 0 | 0 | 0 | 0 | 0 | 0 | 0 |  | 0
0 | 0 | 0 | 0 | 0 | 0 | 0 | 0 | 0 | 0 | 0 |  | 0
0 | 0 | 0 | 0 | 0 | 0 | 0 | 0 | 0 | 0 | 0 |  | 0
0 | 0 | 0 | 0 | 0 | 0 | 0 | 0 | 0 | 0 | 0 |  | 0
0 | 0 | 0 | 0 | 0 | 0 | 0 | 0 | 0 | 0 | 0 |  | 0
0 | 0 | 0 | 0 | 0 | 0 | 0 | 0 | 0 | 0 | 0 |  | 0
0 | 0 | 0 | 0 | 0 | 0 | 0 | 0 | 0 | 0 | 0 |  | 0
0 | 0 | 0 | 0 | 0 | 0 | 0 | 0 | 0 | 0 | 0 |  | 0
0 | 0 | 0 | 0 | 0 | 0 | 0 | 0 | 0 | 0 | 0 |  | 0
0 | 0 | 0 | 0 | 0 | 0 | 0 | 0 | 0 | 0 | 0 |  | 0
0 | 0 | 0 | 0 | 0 | 0 | 0 | 0 | 0 | 0 | 0 |  | 0
0 | 0 | 0 | 0 | 0 | 0 | 0 | 0 | 0 | 0 | 0 |  | 0
0 | 0 | 0 | 0 | 0 | 0 | 0 | 0 | 0 | 0 | 0 |  | 0
0 | 0 | 0 | 0 | 0 | 0 | 0 | 0 | 0 | 0 | 0 |  | 0
0 | 0 | 0 | 0 | 0 | 0 | 0 | 0 | 0 | 0 | 0 |  | 0
0 | 0 | 0 | 0 | 0 | 0 | 0 | 0 | 0 | 0 | 0 |  | 0
0 | 0 | 0 | 0 | 0 | 0 | 0 | 0 | 0 | 0 | 0 |  | 0
0 | 0 | 0 | 0 | 0 | 0 | 0 | 0 | 0 | 0 | 0 |  | 0
0 | 0 | 0 | 0 | 0 | 0 | 0 | 0 | 0 | 0 | 0 |  | 0
0 | 0 | 0 | 0 | 0 | 0 | 0 | 0 | 0 | 0 | 0 |  | 0
0 | 0 | 0 | 0 | 0 | 0 | 0 | 0 | 0 | 0 | 0 |  | 0
 |  |  | 14 | 6 | 1 | 1
 |  |  | VAR_RX_EXTRA | VAR_ZARM_EXTRA | VAR_MSTRX_EXTRA | VAR_MSTZARM_EXTRA
OC_BUERKLIN | OC_FARNELL | OC_RS | Qty | Qty | Qty | Qty |  | Value | Device
0 | 1131855 | 0 | 0 | 0 | 0 | 0 |  | 0 | AK500/2
0 | 1207597 | 0 | 0 | 0 | 0 | 0 |  | 0 | F09HP
0 | 1207598 | 0 | 0 | 0 | 0 | 0 |  | 0 | F15HP
0 | 0 | 0 | 0 | 0 | 0 | 0 |  | 0 | JP1E
0 | 1096983 | 0 | 0 | 0 | 0 | 0 |  | 0 | ML26L
0 | 1096984 | 740-7105 | 0 | 0 | 4 | 4 |  | 0 | ML6
0 | 0 | 0 | 0 | 0 | 0 | 0 |  | 0 | SJ
0 | 1759265 | 0 | 0 | 0 | 0 | 0 |  | 100n | C-EUC0805K
0 | 1887308 | 0 | 0 | 0 | 0 | 0 |  | 10k | R-EU_R0805
0 | 2320856 | 0 | 0 | 0 | 0 | 0 |  | 10u/16V | C-EUC0805K
0 | 2141745 | 0 | 0 | 0 | 0 | 0 |  | 127 | R-EU_R0805
0 | 1779204 | 0 | 0 | 0 | 0 | 0 |  | 12V | ZENER-DIODEDO34-7
0 | 2333544 | 0 | 0 | 0 | 1 | 1 |  | 1M | R-EU_R0805 |  |  | ok
0 | 2332071 | 0 | 0 | 0 | 0 | 0 |  | 1k | R-EU_R0805
0 | 2332071 | 0 | 0 | 0 | 0 | 0 |  | 1k | R-EU_R0805
0 | 2332058 | 0 | 0 | 2 | 0 | 2 |  | 100 | R-EU_R0805 |  |  | ok
0 | 2320853 | 0 | 0 | 0 | 4 | 4 |  | 1u | C-EUC0805K
0 | 1907510 | 0 | 0 | 0 | 0 | 0 |  | 22u/25V | C-EUC0805K
0 | 0 | 666-2386 | 0 | 0 | 4 | 4 |  | 24/1% | R-EU_R0805 |  |  | ok
0 | 2332064 | 0 | 0 | 0 | 0 | 0 |  | 270 | R-EU_R0805
0 | 0 | 679-1207 | 0 | 0 | 0 | 0 |  | 2k2 | R-EU_R0805
0 | 2332077 | 0 | 0 | 0 | 0 | 0 |  | 2k7 | R-EU_R0805
0 | 1500705 | 0 | 0 | 0 | 0 | 0 |  | 330 | R-EU_R0805
0 | 2135988 | 0 | 6 | 6 | 6 | 6 |  | 4-40/M3 | DSUB_MOUNTING_SCREW |  |  | ok
0 | 2407305 | 0 | 0 | 0 | 1 | 1 |  | 4n7 | C-EUC0805K |  |  | ok
0 | 2346932 | 0 | 0 | 0 | 0 | 0 |  | 4u7/50V | C-EUC0805K
0 | 0 | 737-7833P | 3 | 0 | 3 | 3 |  | 10k | STRK11K |  |  | ok
0 | 1843660 | 0 | 0 | 0 | 1 | 1 |  | ADUM3160 | ADUM3160 |  |  | ok
0 | 2322083 | 0 | 0 | 0 | 0 | 0 |  | BERNSTEIN | LEDCHIPLED_1206
0 | 9558640 | 545-0135 | 0 | 0 | 0 | 0 |  | BSS123 | BSS123
0 | 1440813 | 0 | 0 | 0 | 0 | 0 |  | BTS6143 | BTS6143
0 | 2333799 | 0 | 0 | 0 | 0 | 0 |  | COIL | COIL
0 | 2101406 | 0 | 0 | 0 | 0 | 0 |  | FDD4141TO252 | FDD4141TO252
0 | 2099244 | 0 | 0 | 0 | 0 | 0 |  | GREEN | LEDCHIPLED_1206
0 | 9994696 | 0 | 0 | 0 | 0 | 0 |  | HCPL0600 | HCPL0600
0 | 1854507 | 0 | 1 | 0 | 1 | 0 |  | black | JACK |  |  | ok
0 | 1854508 | 0 | 1 | 0 | 1 | 0 |  | red | JACK |  |  | ok
0 | 1685603 | 0 | 0 | 0 | 0 | 0 |  | LM1117 | LM1117
0 | 9725539 | 0 | 0 | 0 | 0 | 0 |  | MAX3232ESE | MAX3232ESE
0 | 1651986 | 0 | 0 | 0 | 0 | 0 |  | NC7WZ17P6X | NC7WZ17P6X
0 | 0 | 463-690 | 0 | 0 | 1 | 1 |  | NUP2202W1 | NUP2202W1
0 | 1642035 | 515-1989 | 0 | 0 | 1 | 1 |  | PN61729-S | PN61729-S |  |  | ok
0 | 0 | 752-9157 | 0 | 1 | 0 | 1 |  | RLP2-200-500 | RLP2-200-500 |  |  | ok
0 | 1217758 | 0 | 5 | 0 | 5 | 0 |  | SMS_IP67 | SMS_IP67 |  |  | ok
0 | 9387234 | 0 | 0 | 0 | 0 | 0 |  | SP490 | SP490
12 G 203 | 0 | 0 | 0 | 3 | 0 | 3 |  | SWITCH_LED | SWITCH_LED |  |  | ok
12 G 205 | 0 | 0 | 0 | 1 | 0 | 2 |  | SWITCH_LED | SWITCH_LED |  |  | ok
0 | 0 | 801-9330 | 0 | 0 | 0 | 0 |  | TEN3-2410N | TEN3-2410N
0 | 2112625 | 0 | 0 | 0 | 0 | 0 |  | TPS73125 | TPS731
0 | 1696320 | 0 | 0 | 0 | 0 | 0 |  | TSR_1-2450 | TSR_1-2450
0 | 1103848 | 0 | 0 | 0 | 0 | 0 |  | UDN2596 | UDN2596
0 | 2066309 | 0 | 0 | 0 | 0 | 0 |  | XMEGA-A4UTQFP | XMEGA-A4UTQFP
0 | 2099249 | 0 | 0 | 0 | 0 | 0 |  | YELLOW | LEDCHIPLED_1206
0 | 0 | 0 | 0 | 0 | 0 | 0 |  | opt | C-EUC0805K
0 | 1667008 | 0 | 0 | 0 | 0 | 0 |  | opt | CRYSTALHC49S
0 | 2309112 | 0 | 0 | 0 | 0 | 0 |  | 0 | R-EU_R0805
0 | 0 | 0 | 0 | 0 | 0 | 0 |  | 0 | 0
0 | 0 | 0 | 0 | 0 | 0 | 0 |  | 0 | 0
0 | 0 | 0 | 0 | 0 | 0 | 0 |  | 0 | 0
0 | 0 | 0 | 0 | 0 | 0 | 0 |  | 0 | 0
0 | 0 | 0 | 0 | 0 | 0 | 0 |  | 0 | 0
0 | 0 | 0 | 0 | 0 | 0 | 0 |  | 0 | 0
0 | 0 | 0 | 0 | 0 | 0 | 0 |  | 0 | 0
0 | 0 | 0 | 0 | 0 | 0 | 0 |  | 0 | 0
0 | 0 | 0 | 0 | 0 | 0 | 0 |  | 0 | 0
0 | 0 | 0 | 0 | 0 | 0 | 0 |  | 0 | 0
0 | 0 | 0 | 0 | 0 | 0 | 0 |  | 0 | 0
0 | 0 | 0 | 0 | 0 | 0 | 0 |  | 0 | 0
0 | 0 | 0 | 0 | 0 | 0 | 0 |  | 0 | 0
0 | 0 | 0 | 0 | 0 | 0 | 0 |  | 0 | 0
0 | 0 | 0 | 0 | 0 | 0 | 0 |  | 0 | 0
0 | 0 | 0 | 0 | 0 | 0 | 0 |  | 0 | 0
0 | 0 | 0 | 0 | 0 | 0 | 0 |  | 0 | 0
0 | 0 | 0 | 0 | 0 | 0 | 0 |  | 0 | 0
0 | 0 | 0 | 0 | 0 | 0 | 0 |  | 0 | 0
0 | 0 | 0 | 0 | 0 | 0 | 0 |  | 0 | 0
0 | 0 | 0 | 0 | 0 | 0 | 0 |  | 0 | 0
0 | 0 | 0 | 0 | 0 | 0 | 0 |  | 0 | 0
0 | 0 | 0 | 0 | 0 | 0 | 0 |  | 0 | 0
0 | 0 | 0 | 0 | 0 | 0 | 0 |  | 0 | 0
0 | 0 | 0 | 0 | 0 | 0 | 0 |  | 0 | 0
0 | 0 | 0 | 0 | 0 | 0 | 0 |  | 0 | 0
0 | 0 | 0 | 0 | 0 | 0 | 0 |  | 0 | 0
0 | 0 | 0 | 0 | 0 | 0 | 0 |  | 0 | 0
0 | 0 | 0 | 0 | 0 | 0 | 0 |  | 0 | 0
0 | 0 | 0 | 0 | 0 | 0 | 0 |  | 0 | 0
0 | 0 | 0 | 0 | 0 | 0 | 0 |  | 0 | 0
0 | 0 | 0 | 0 | 0 | 0 | 0 |  | 0 | 0
0 | 0 | 0 | 0 | 0 | 0 | 0 |  | 0 | 0
0 | 0 | 0 | 0 | 0 | 0 | 0 |  | 0 | 0
0 | 0 | 0 | 0 | 0 | 0 | 0 |  | 0 | 0
0 | 0 | 0 | 0 | 0 | 0 | 0 |  | 0 | 0
0 | 0 | 0 | 0 | 0 | 0 | 0 |  | 0 | 0
0 | 0 | 0 | 0 | 0 | 0 | 0 |  | 0 | 0

Sheet: Order Farnell
1131855 | 12
1207597 | 15
1207598 | 7
1096983 | 18
1096984 | 16
1759265 | 164
1887308 | 145
2320856 | 7
2141745 | 15
1779204 | 25
2332071 | 114
2332071 | 49
2332058 | 14
2320853 | 38
1907510 | 13
2332064 | 13
2332077 | 25
1500705 | 7
2135988 | 132
2346932 | 31
2322083 | 15
9558640 | 79
1440813 | 8
2333799 | 15
2101406 | 25
2099244 | 42
9994696 | 29
1854507 | 15
1854508 | 15
1685603 | 8
9725539 | 8
1651986 | 8
1217758 | 25
9387234 | 8
2112625 | 8
1696320 | 8
1103848 | 7
2066309 | 8
2099249 | 43
2309112 | 15

Sheet: Order Buerklin
12 G 203 | 0
12 G 205 | 0

Sheet: Order RS
740-7105 | 16
679-1207 | 97
737-7833P | 15
545-0135 | 79
801-9330 | 8

Sheet: TODO
R37, R39, R40, R44, R43 | check values in variants ZARM and MST2_ZARM
U$3, U9 | assign correct prefix and update schematic/layout with updated symbol
