rx-viper/rxsms/eagle/pwrcircuit/rxsms-2.0-Stromvers.dxf

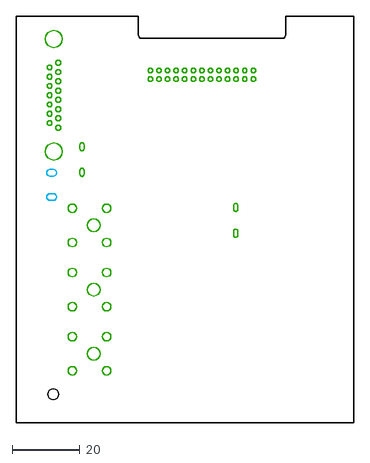
[picture p31: CAD file, 2015-03-17]
eagle/pwrcircuit/rxsms-2.0-Stromvers.dxf
100.0 x 120.5
