rx-viper/rxsms/doc/RXSMS Manual.pdf

# REXUS Service Module Simulator Manual RX(SM)²

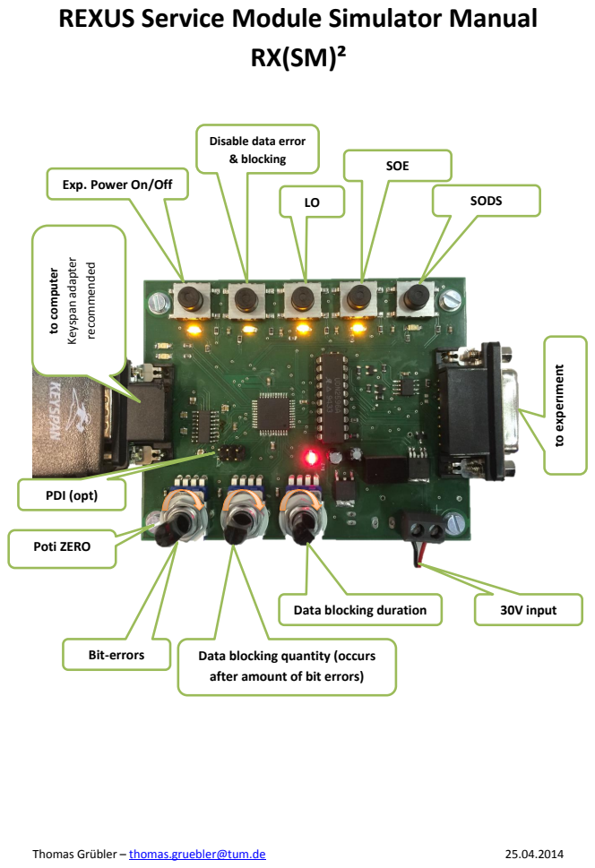
[picture p32: page 1]
Thomas Grübler – thomas.gruebler@tum.de; SODS; SOE; 30V input; to experiment; Bit-errors; Data blocking quantity (occurs; PDI (opt); to computer; Keyspan adapter; recommended; Poti ZERO

Disable data error
& blocking

Exp. Power On/Off

Data blocking duration

after amount of bit errors)
