rx-viper/rxsms/eagle/Testplatine/Testplatine_01_wiebeauftragt-sch.pdf

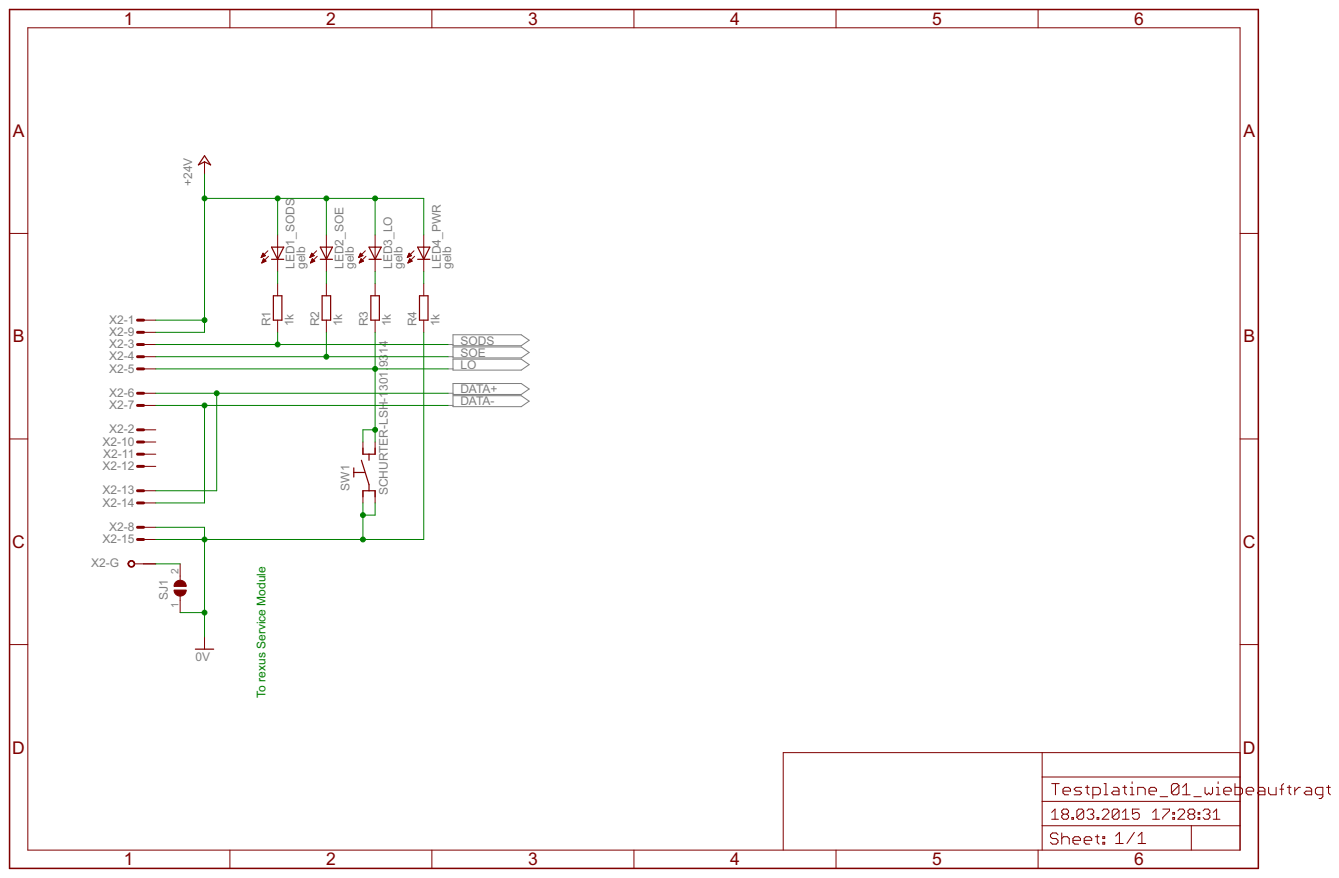
[picture p33: page 1]

+24V 0V 1k gelb gelb gelb gelb 1k1k1k SCHURTER-LSH-1301.9314 X2-9 X2-10 X2-11 X2-12 X2-13 X2-8 X2-7 X2-6 X2-5 X2-4 X2-3 X2-2 X2-1 X2-14 X2-15 X2-G R1 LED1_SODS LED2_SOE LED3_LO LED4_PWR R2R3R4 SW1 SJ1 2 1 SOE DATA+ DATA- SODS LO ABCD 1 2 3 4 5 6 ABCD 1 2 3 4 5 6 To rexus Service Module
