rx-viper/rxsms/eagle/simulator/rxsms-2.0-sch.pdf

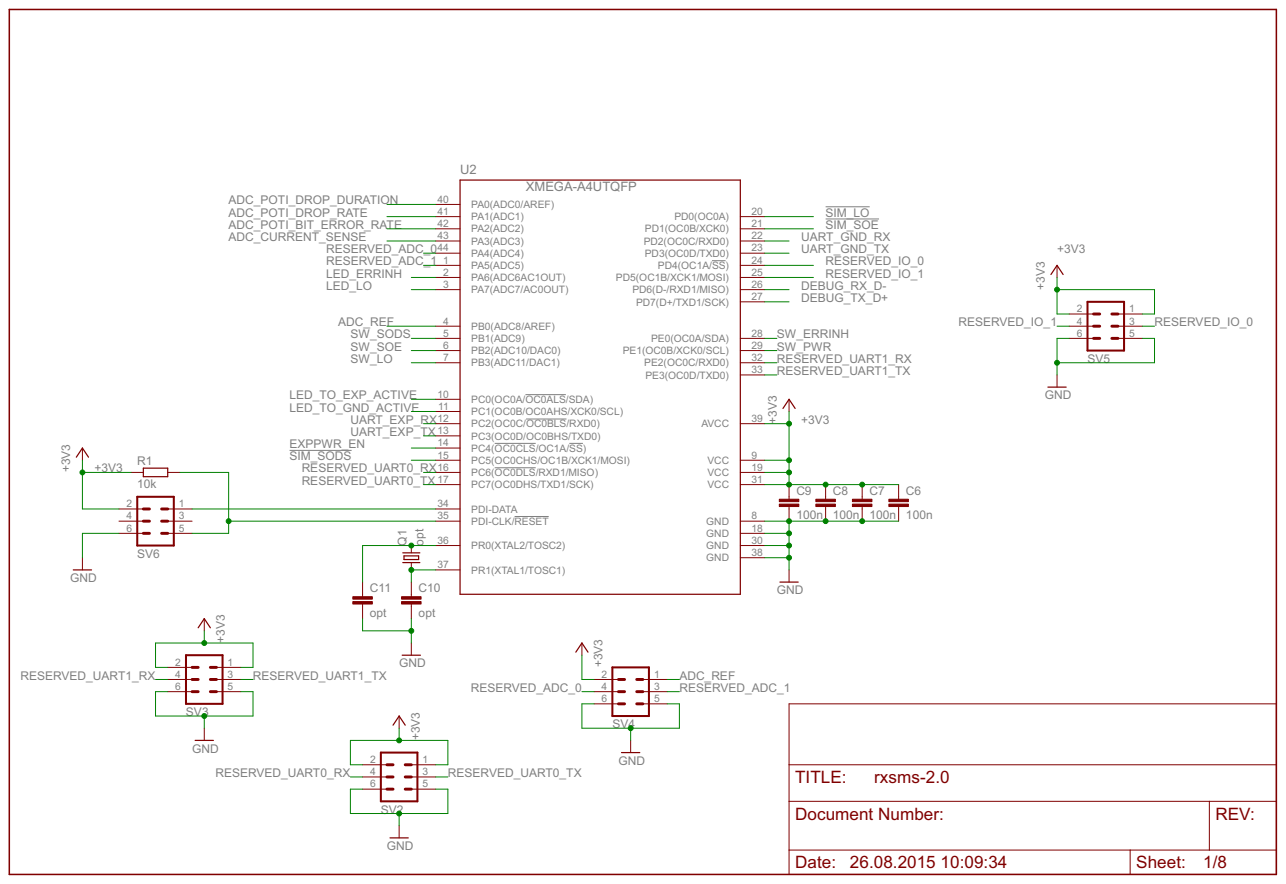
[picture p34: page 1]

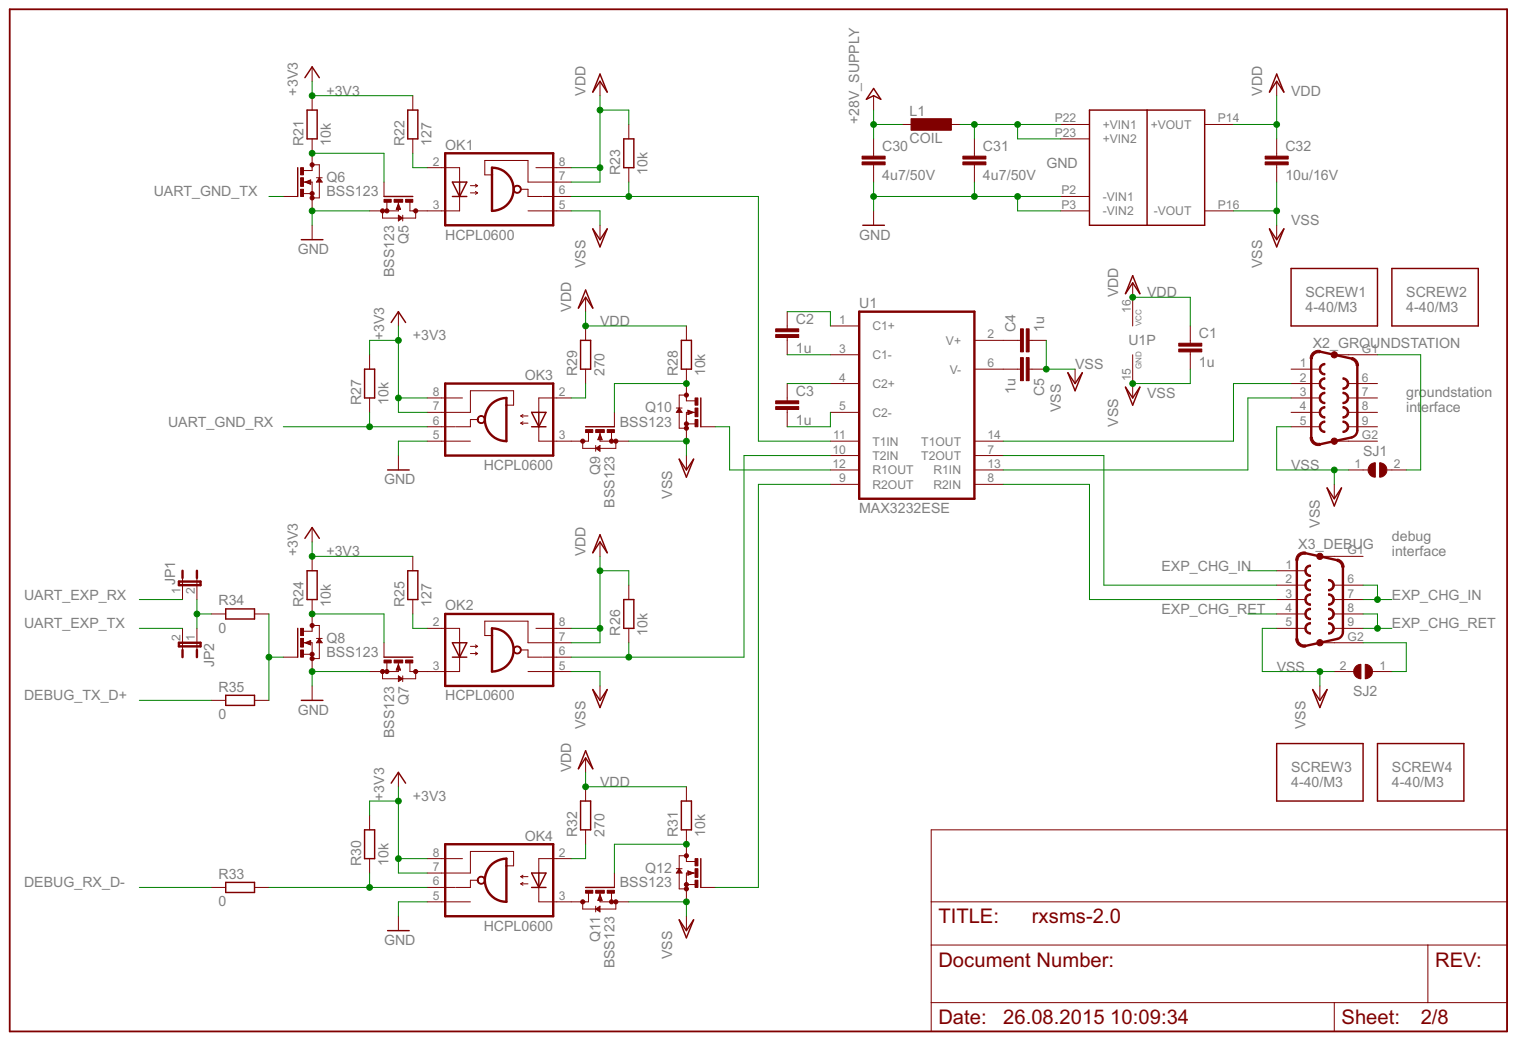
[picture p35: page 2]

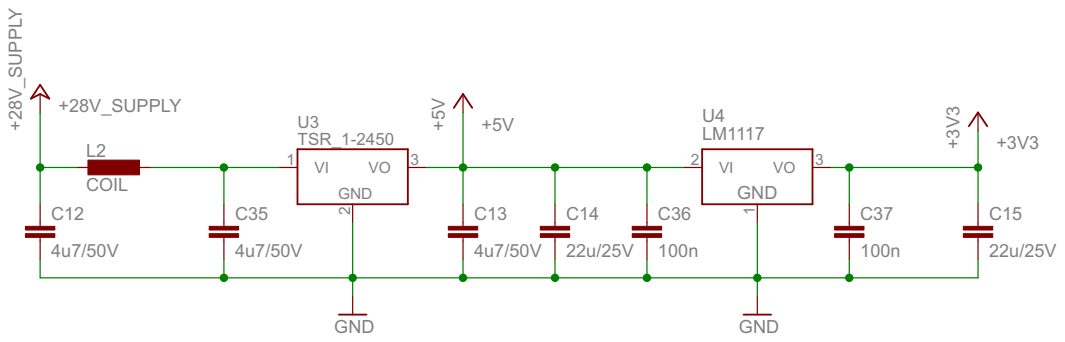
[picture p36: page 3]

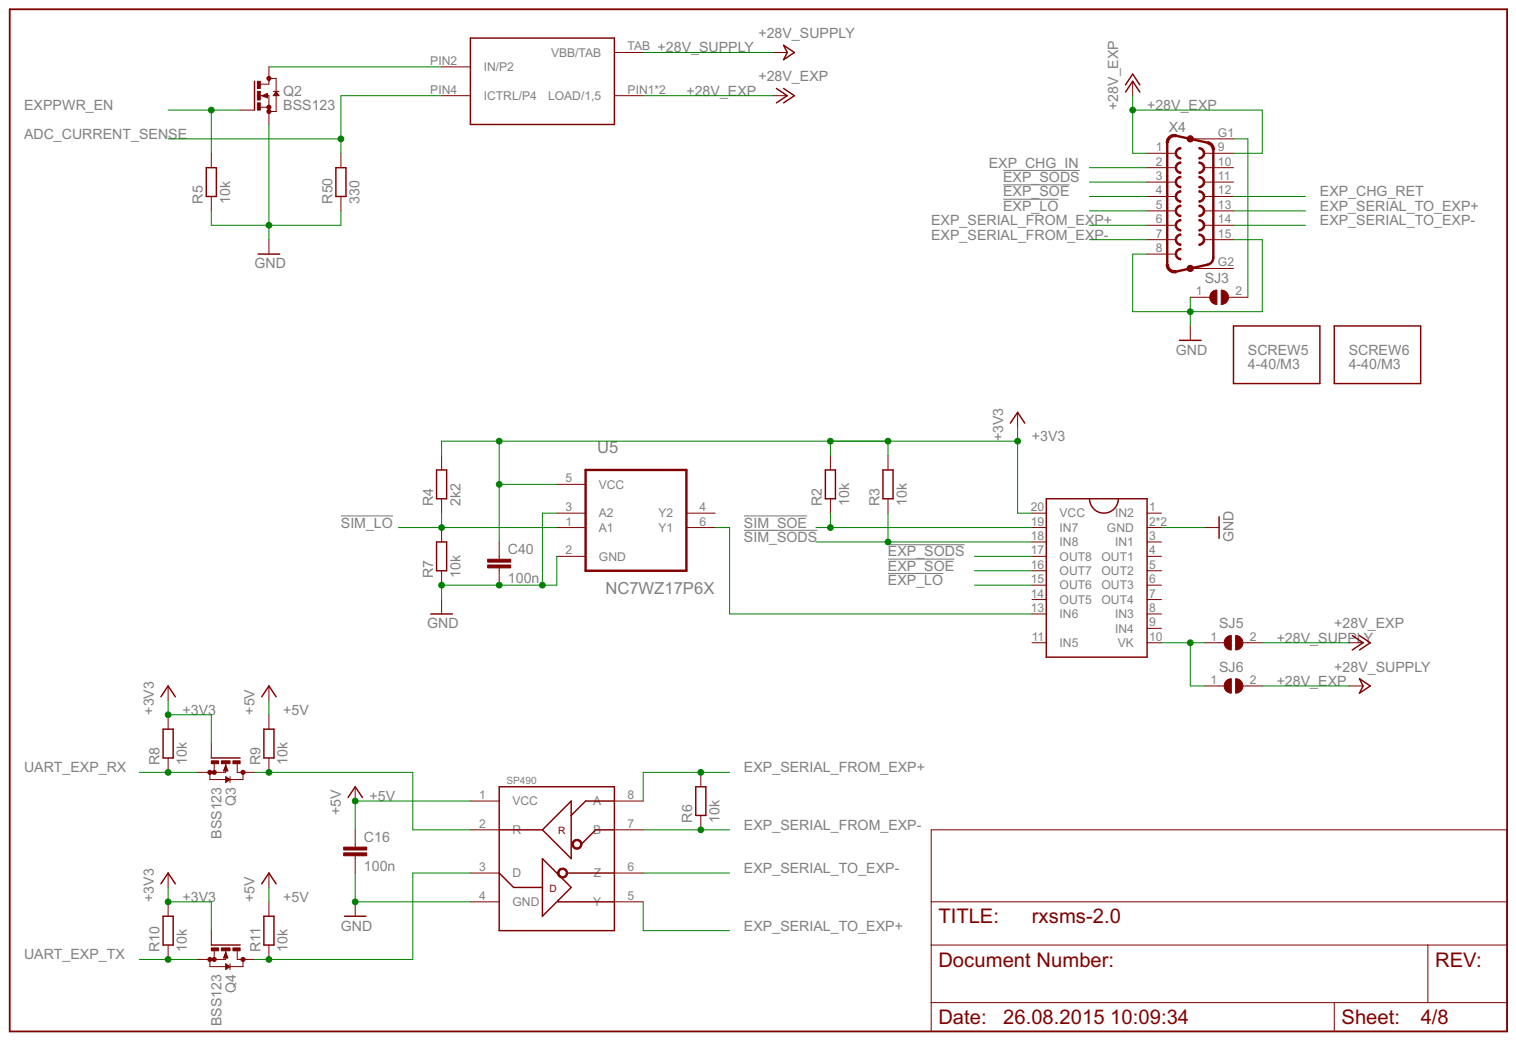
[picture p37: page 4]

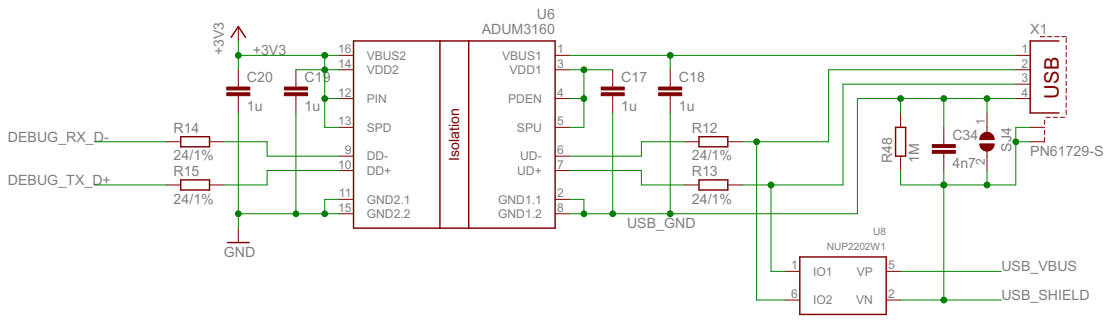
[picture p38: page 5]

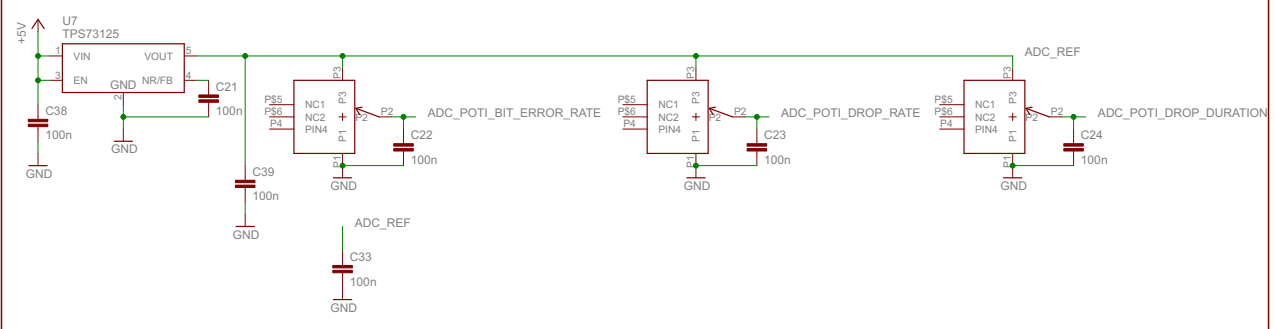
[picture p39: page 6]

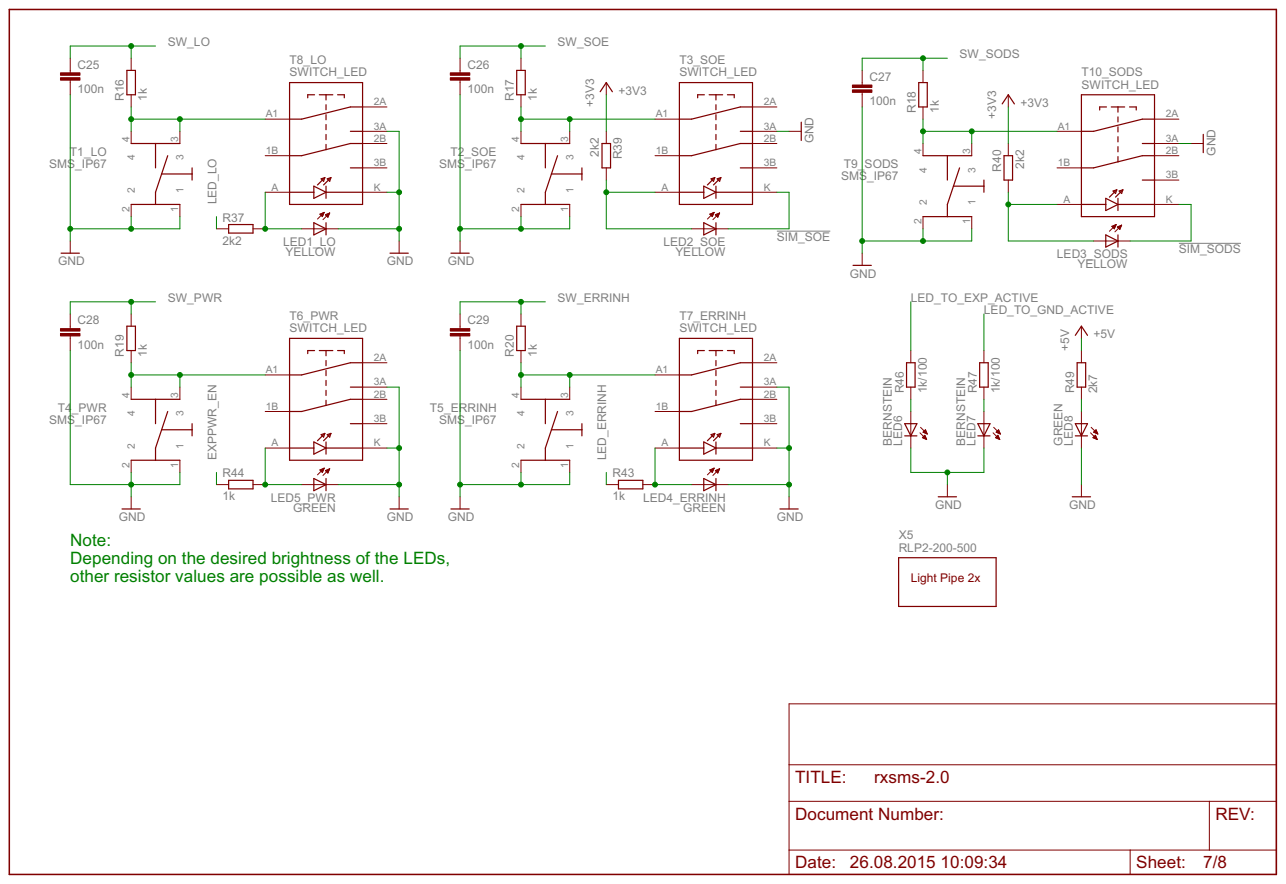
[picture p40: page 7]

Light Pipe 2x Note:
Depending on the desired brightness of the LEDs, other resistor values are possible as well.

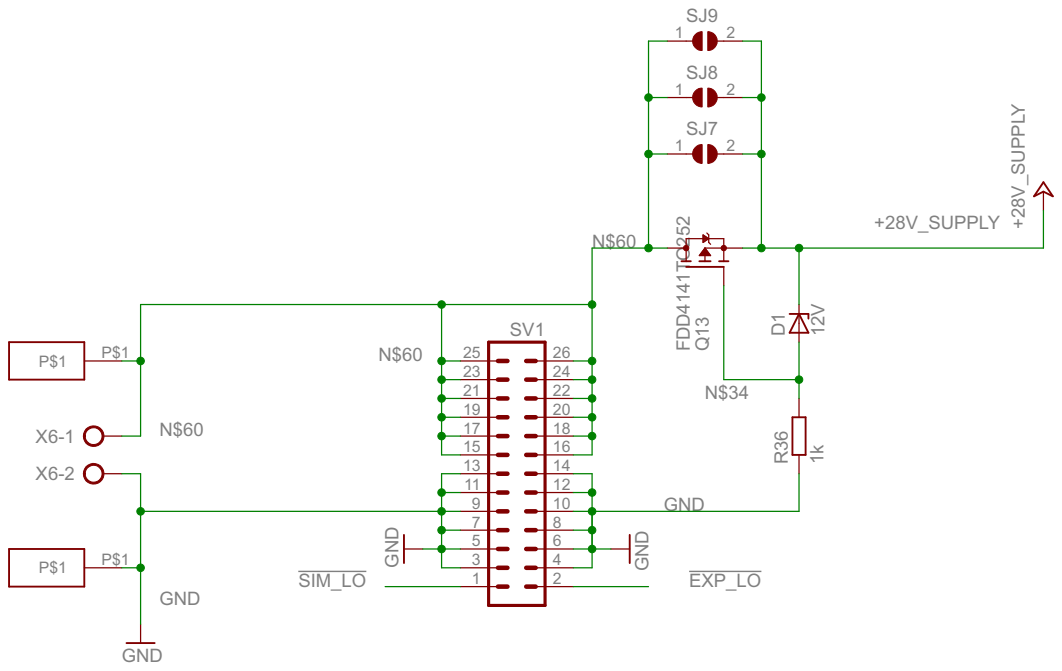
[picture p41: page 8]
