rx-viper/rxsms/eagle/Testplatine/Testplatine_01_wiebeauftragt-brd.pdf

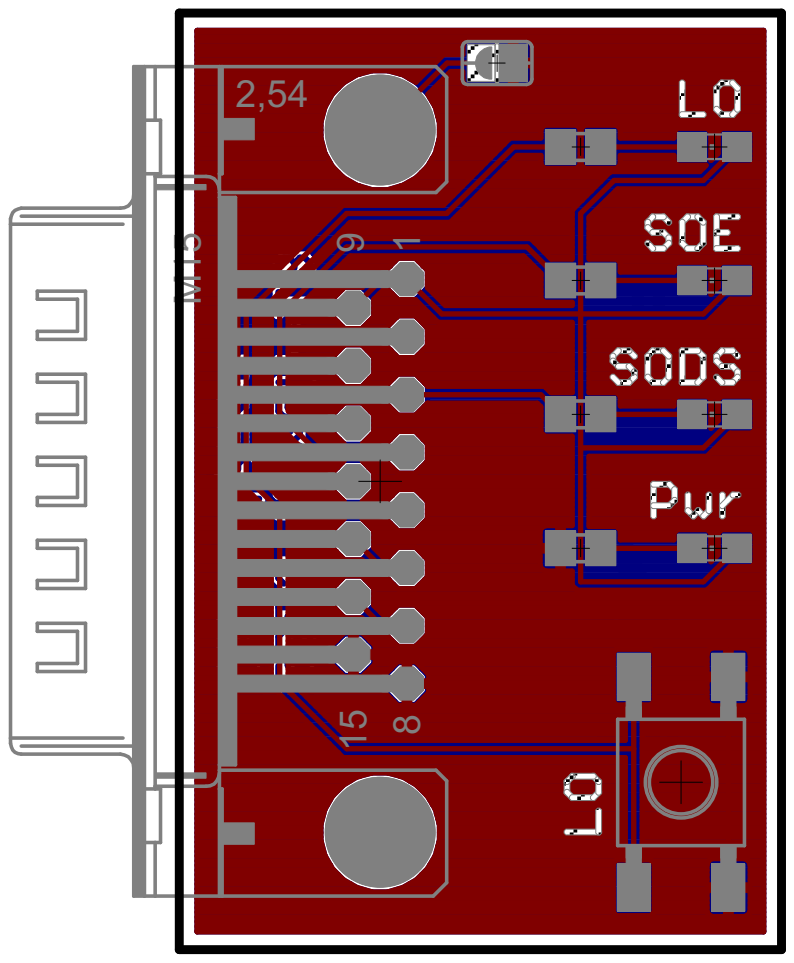
[picture p42: page 1]
