rx-viper/rxsms/eagle/Testplatine/Testplatine_01_wiebeauftragt-brd-bot.pdf

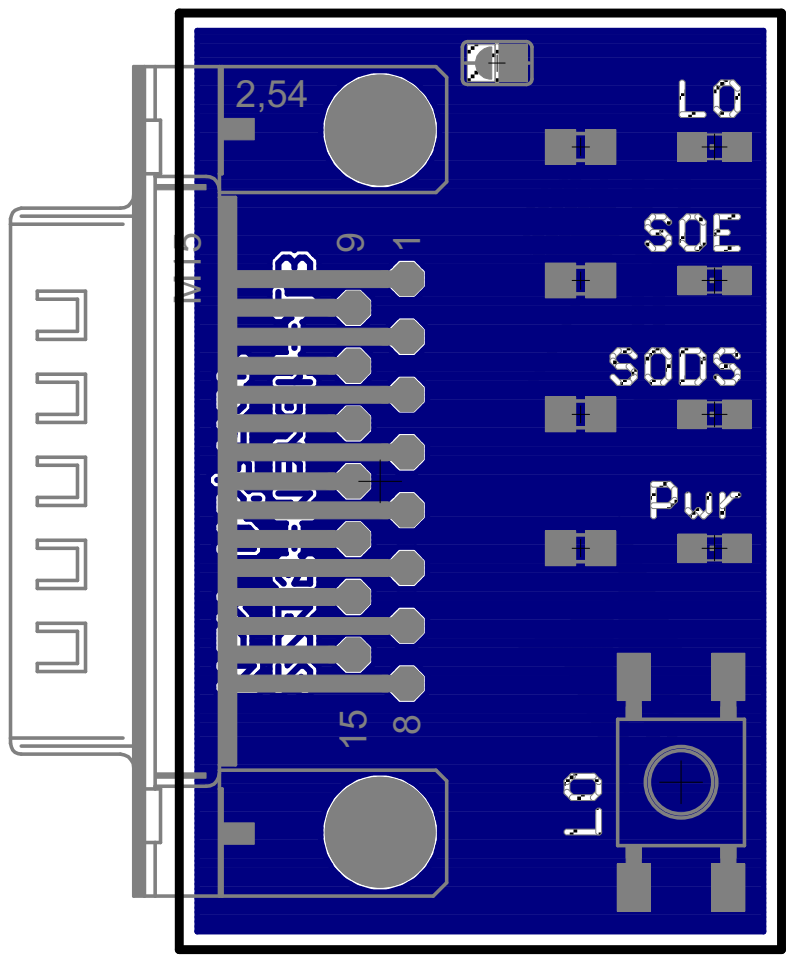
[picture p43: page 1]
