rx-viper/rxsms/eagle/Testplatine/Testplatine_01_wiebeauftragt-brd-top.pdf

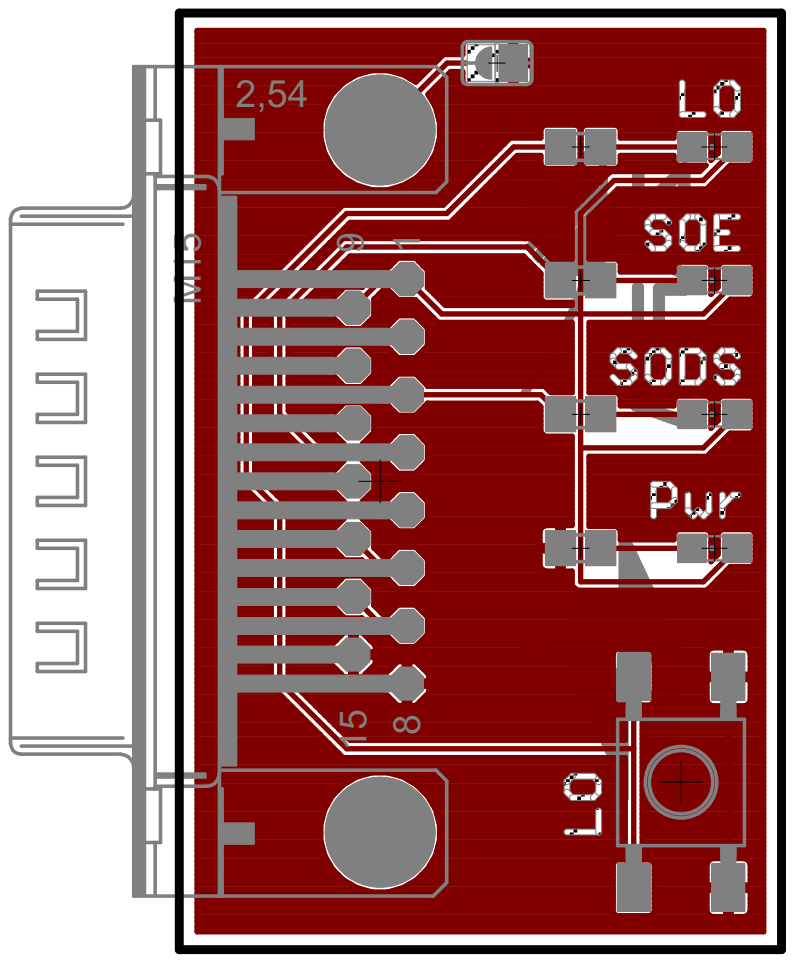
[picture p44: page 1]
