rx-viper/rxsms/eagle/pwrcircuit/rxsms-2.0-Stromvers-brd.pdf

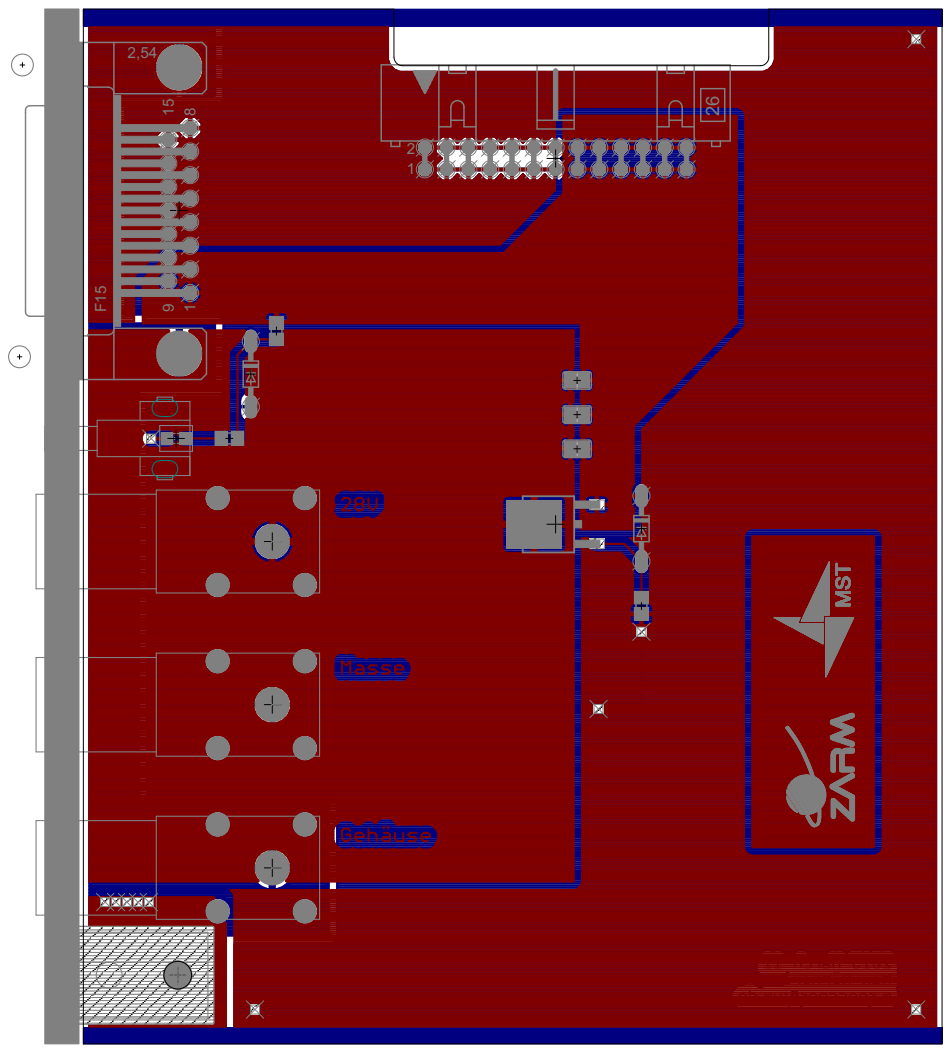
[picture p45: page 1]
