rx-viper/rxsms/eagle/pwrcircuit/rxsms-2.0-Stromvers-sch.pdf

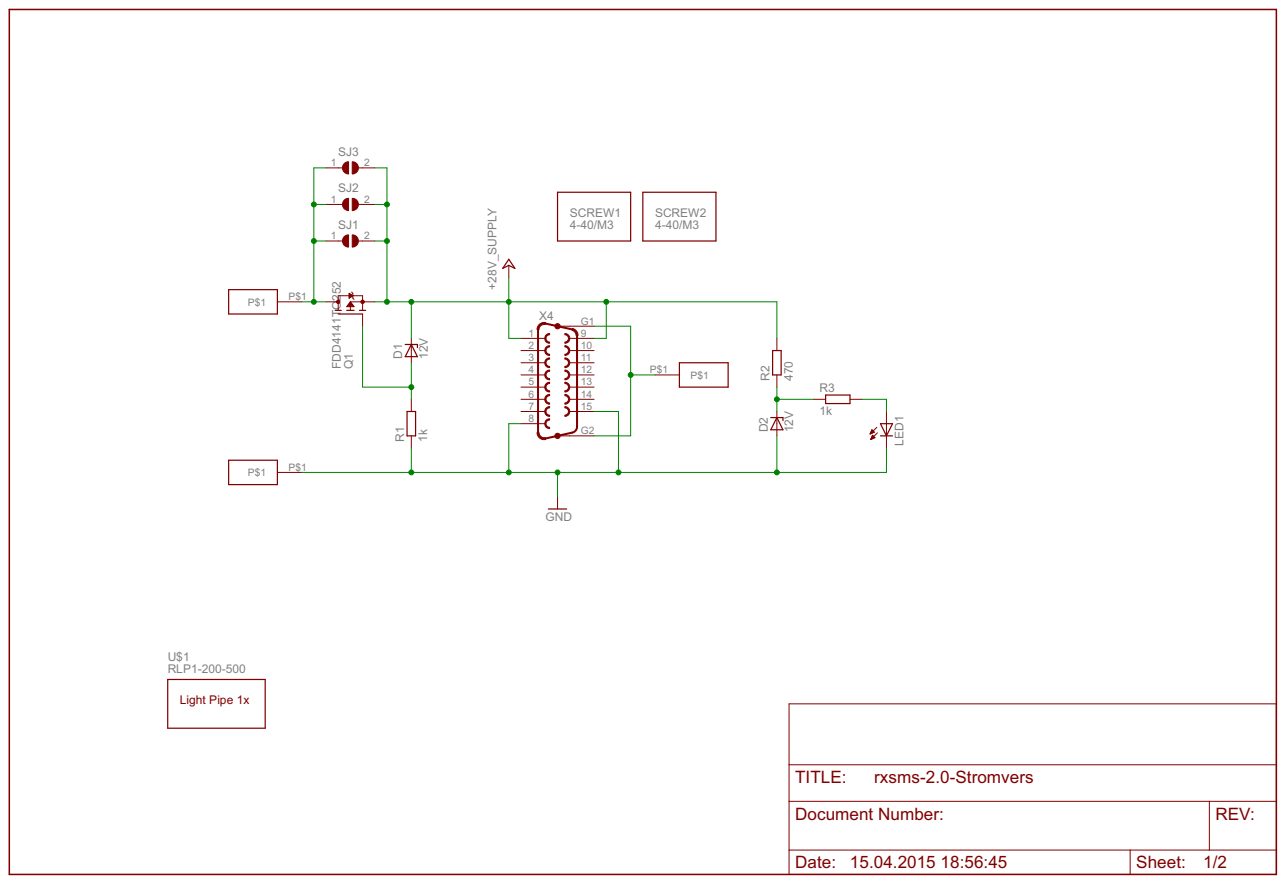
[picture p46: page 1]

Document Number: | REV:

Date: 15.04.2015 18:56:45 | Sheet: 1/2

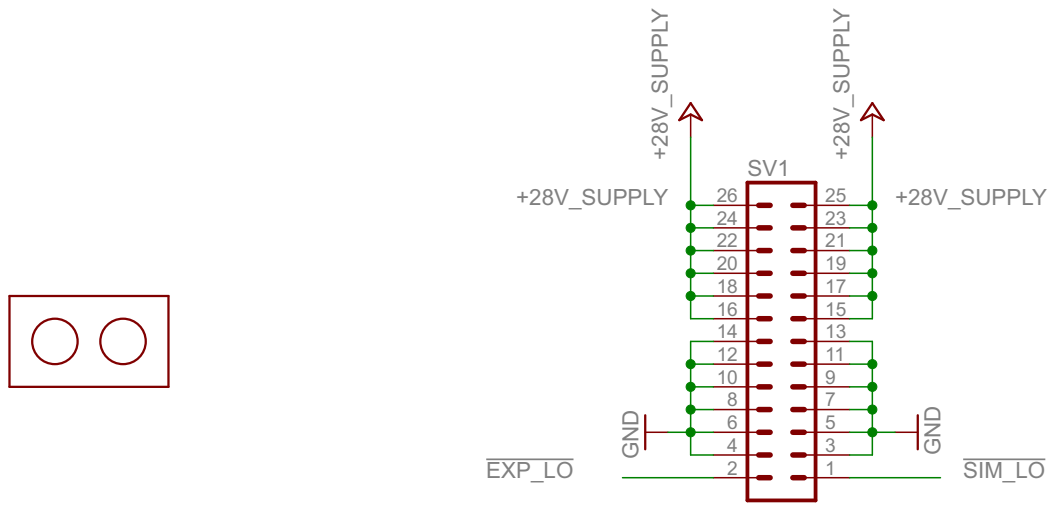
[picture p47: page 2]

Document Number: | REV:

Date: 15.04.2015 18:56:45 | Sheet: 2/2
