rx-viper/rxsms/eagle/simulator/rxsms-2.0-brd-bot.pdf

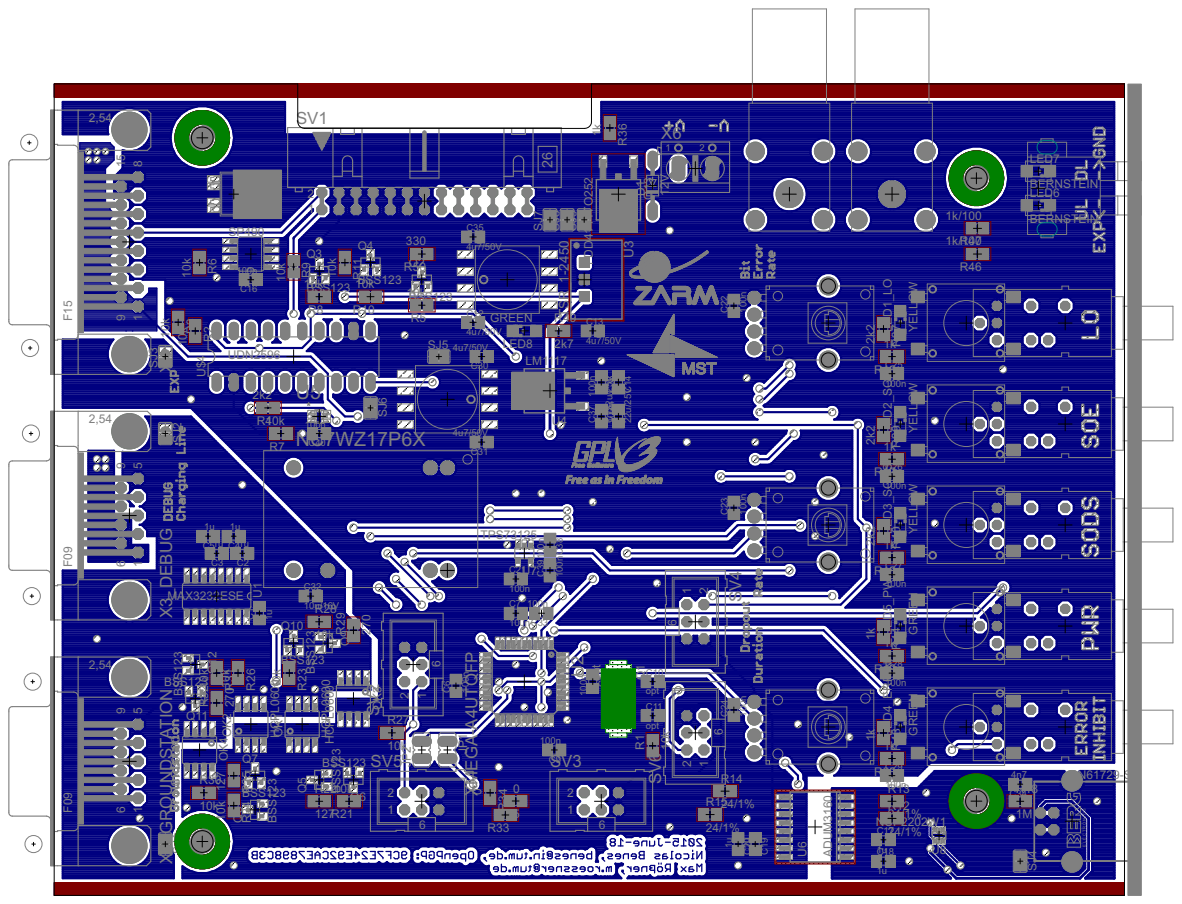
[picture p48: page 1]
