rx-viper/rxsms/eagle/simulator/rxsms-2.0-brd-fill.pdf

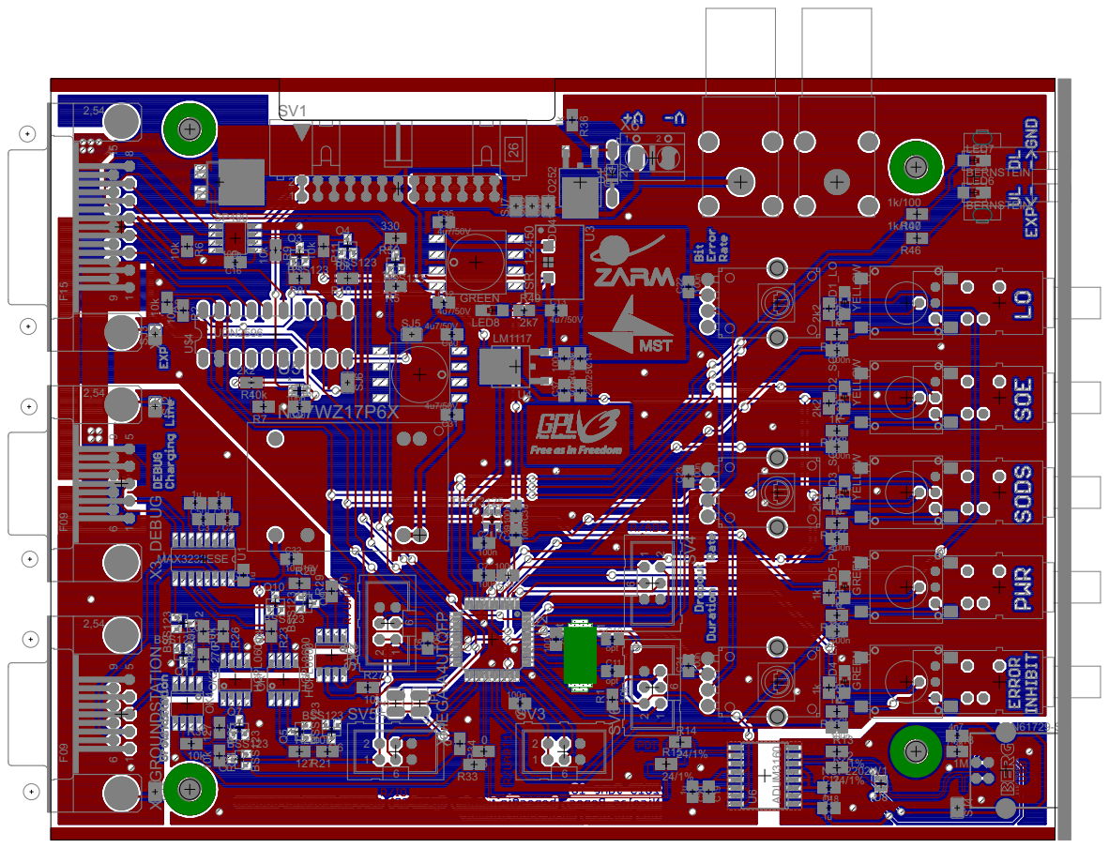
[picture p49: page 1]
