rx-viper/rxsms/eagle/simulator/rxsms-2.0-brd-outline.pdf

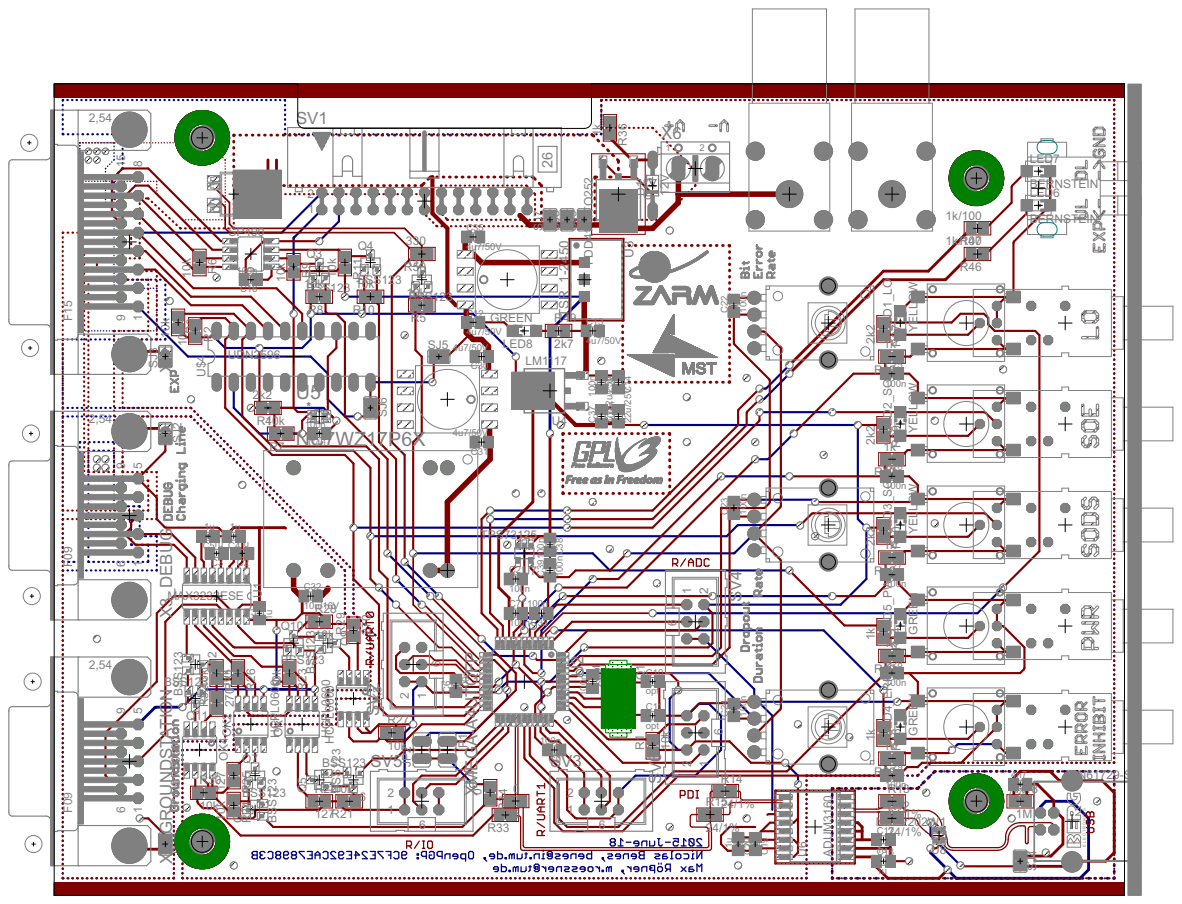
[picture p50: page 1]
