rx-viper/rxsms/eagle/simulator/rxsms-2.0-brd-top.pdf

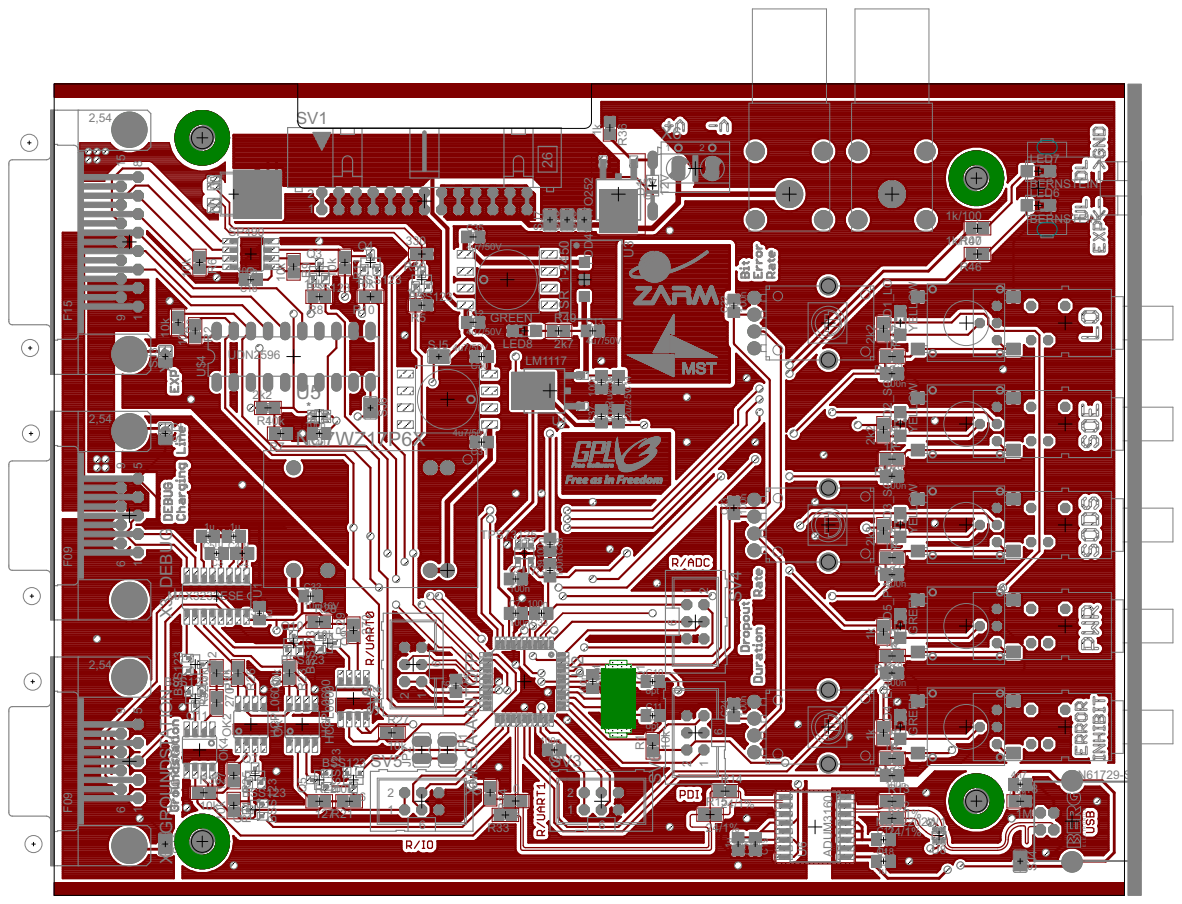
[picture p51: page 1]
