rx-viper/rxsms/eagle/pwrcircuit/rxsms-2.0-Stromvers-all.pdf

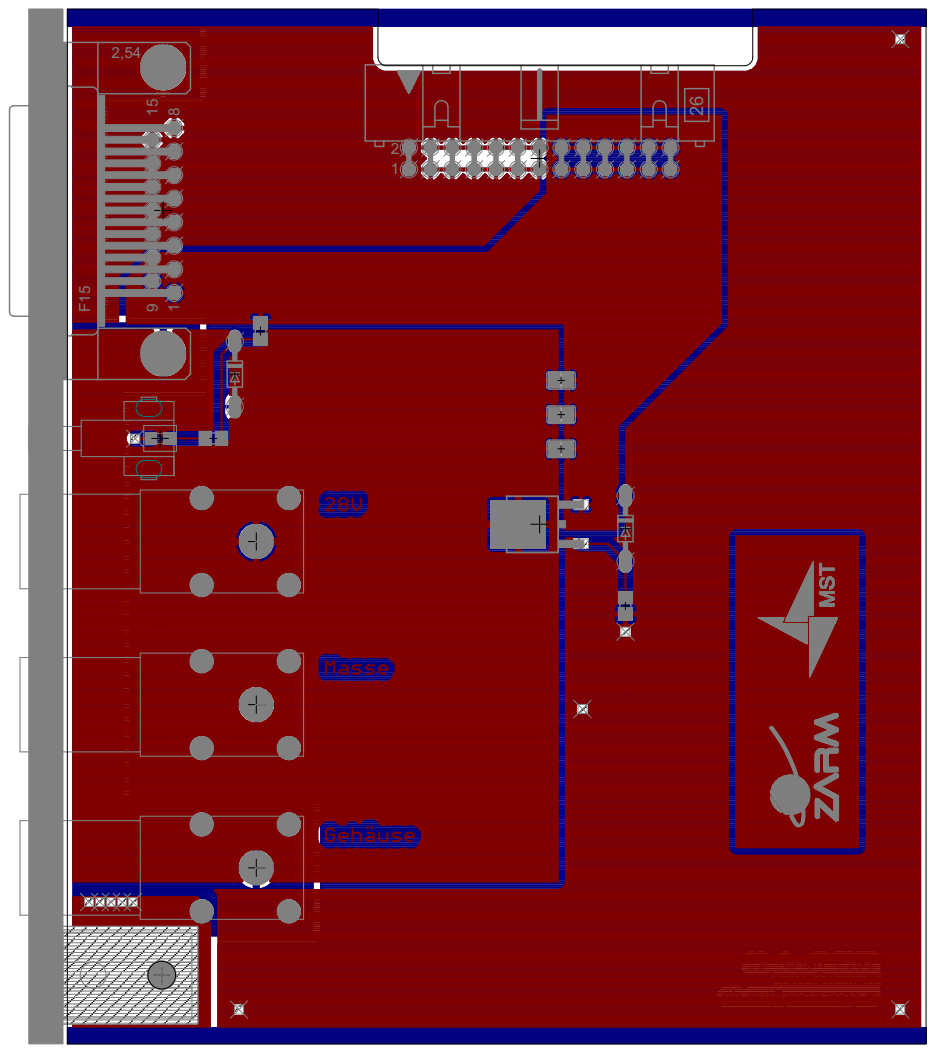
[picture p52: page 1]
