rx-viper/rxsms/eagle/pwrcircuit/rxsms-2.0-Stromvers-bot.pdf

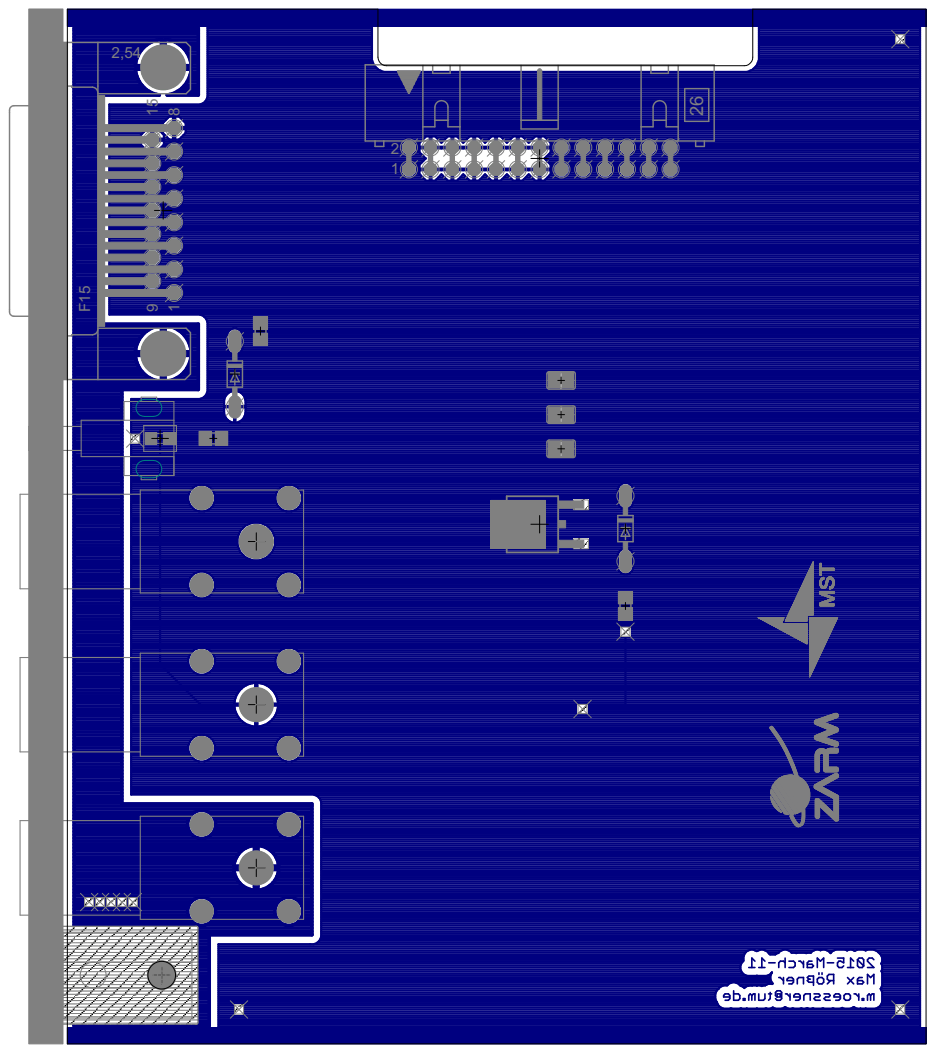
[picture p53: page 1]
