rx-viper/rxsms/eagle/pwrcircuit/rxsms-2.0-Stromvers-top.pdf

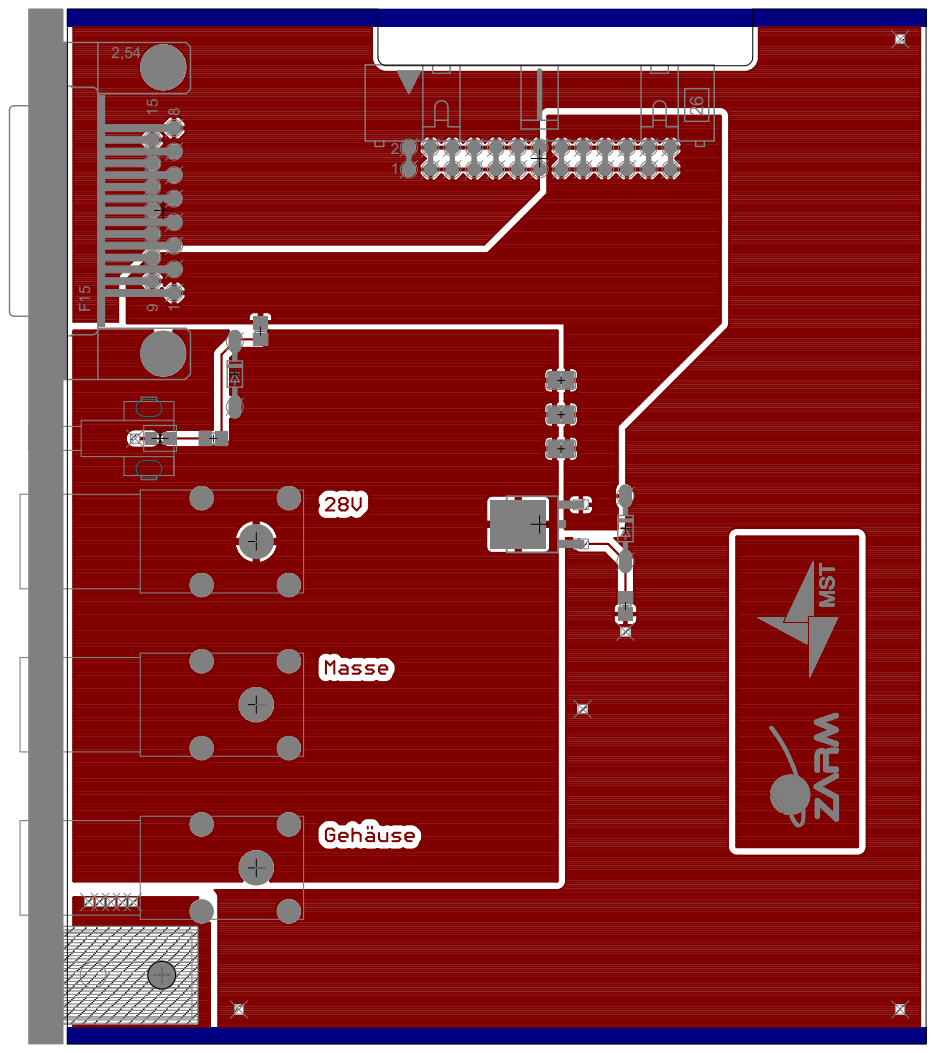
[picture p54: page 1]
