rx-viper/rxsms/eagle/simulator/rxsms-2.0.brd

## EAGLE design eagle/simulator/rxsms-2.0.brd (2015-06-18)

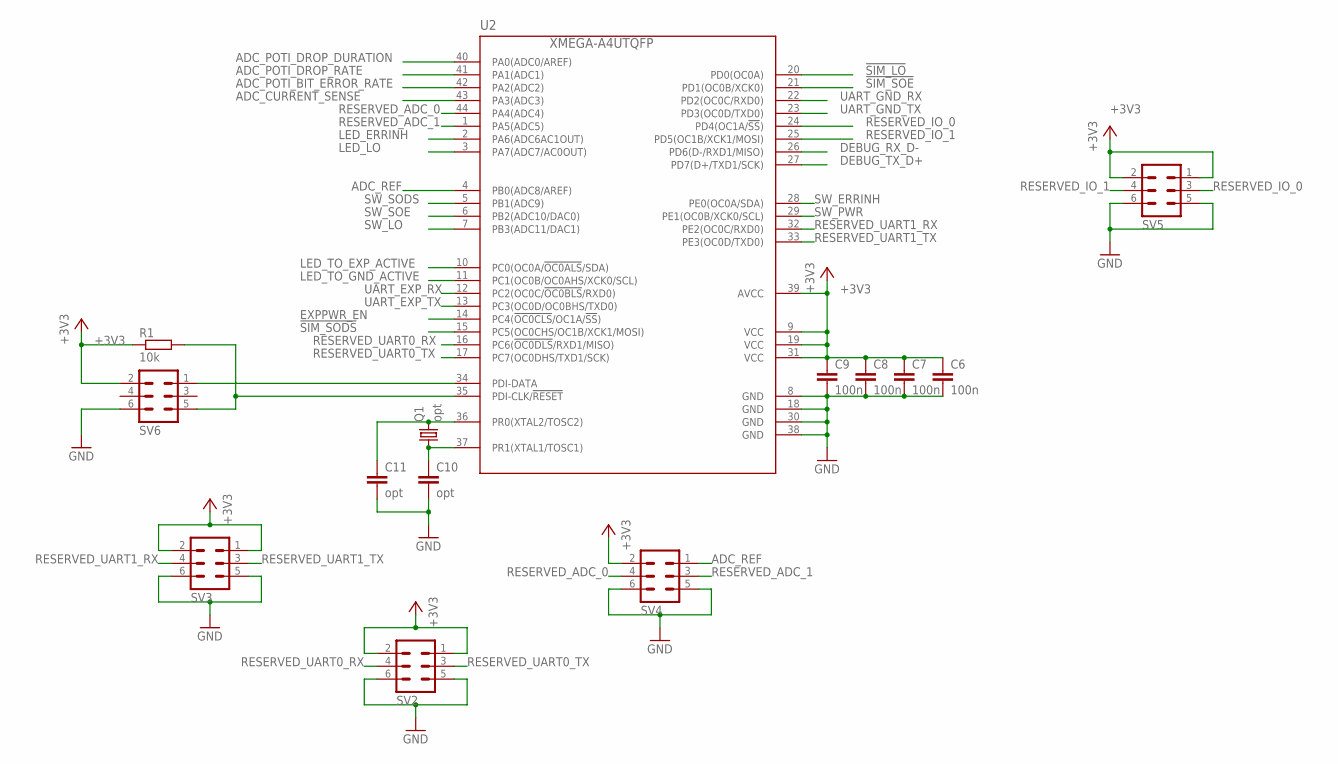
[picture p55: schematic rxsms-2.0.sch, sheet 1]

Parts:
C6, C7, C8, C9: 100n; C0805K
C10, C11: opt; C0805K
Q1: opt; HC49/S
R1: 10k; R0805
SV2, SV3, SV4, SV5, SV6: ML6
U2: XMEGA-A4UTQFP; TQFP44

Connections:
!SIM_LO: U2.20 (PD0(OC0A)); also elsewhere on the board
!SIM_SODS: U2.15 (PC5(OC0CHS/OC1B/XCK1/MOSI)); also elsewhere on the board
!SIM_SOE: U2.21 (PD1(OC0B/XCK0)); also elsewhere on the board
+3V3: C6.1, C7.1, C8.1, C9.1, R1.1, SV2.1, SV2.2, SV3.1, SV3.2, SV4.2, SV5.1, SV5.2, SV6.2, U2.9 (VCC), U2.19 (VCC), U2.31 (VCC), U2.39 (AVCC); also elsewhere on the board
ADC_CURRENT_SENSE: U2.43 (PA3(ADC3)); also elsewhere on the board
ADC_POTI_BIT_ERROR_RATE: U2.42 (PA2(ADC2)); also elsewhere on the board
ADC_POTI_DROP_DURATION: U2.40 (PA0(ADC0/AREF)); also elsewhere on the board
ADC_POTI_DROP_RATE: U2.41 (PA1(ADC1)); also elsewhere on the board
ADC_REF: SV4.1, U2.4 (PB0(ADC8/AREF)); also elsewhere on the board
DEBUG_RX_D-: U2.26 (PD6(D-/RXD1/MISO)); also elsewhere on the board
DEBUG_TX_D+: U2.27 (PD7(D+/TXD1/SCK)); also elsewhere on the board
EXPPWR_EN: U2.14 (PC4(!OC0CLS!/OC1A/!SS!)); also elsewhere on the board
GND: C6.2, C7.2, C8.2, C9.2, C10.2, C11.2, SV2.5, SV2.6, SV3.5, SV3.6, SV4.5, SV4.6, SV5.5, SV5.6, SV6.6, U2.8 (GND), U2.18 (GND), U2.30 (GND), U2.38 (GND); also elsewhere on the board
LED_ERRINH: U2.2 (PA6(ADC6AC1OUT)); also elsewhere on the board
LED_LO: U2.3 (PA7(ADC7/AC0OUT)); also elsewhere on the board
LED_TO_EXP_ACTIVE: U2.10 (PC0(OC0A/!OC0ALS!/SDA)); also elsewhere on the board
LED_TO_GND_ACTIVE: U2.11 (PC1(OC0B/OC0AHS/XCK0/SCL)); also elsewhere on the board
unnamed: C10.1, Q1.1, U2.37 (PR1(XTAL1/TOSC1))
unnamed: C11.1, Q1.2, U2.36 (PR0(XTAL2/TOSC2))
unnamed: SV6.1, U2.34 (PDI-DATA)
unnamed: R1.2, SV6.5, U2.35 (PDI-CLK/!RESET)
RESERVED_ADC_0: SV4.4, U2.44 (PA4(ADC4))
RESERVED_ADC_1: SV4.3, U2.1 (PA5(ADC5))
RESERVED_IO_0: SV5.3, U2.24 (PD4(OC1A/!SS!))
RESERVED_IO_1: SV5.4, U2.25 (PD5(OC1B/XCK1/MOSI))
RESERVED_UART0_RX: SV2.4, U2.16 (PC6(!OC0DLS!/RXD1/MISO))
RESERVED_UART0_TX: SV2.3, U2.17 (PC7(OC0DHS/TXD1/SCK))
RESERVED_UART1_RX: SV3.4, U2.32 (PE2(OC0C/RXD0))
RESERVED_UART1_TX: SV3.3, U2.33 (PE3(OC0D/TXD0))
SW_ERRINH: U2.28 (PE0(OC0A/SDA)); also elsewhere on the board
SW_LO: U2.7 (PB3(ADC11/DAC1)); also elsewhere on the board
SW_PWR: U2.29 (PE1(OC0B/XCK0/SCL)); also elsewhere on the board
SW_SODS: U2.5 (PB1(ADC9)); also elsewhere on the board
SW_SOE: U2.6 (PB2(ADC10/DAC0)); also elsewhere on the board
UART_EXP_RX: U2.12 (PC2(OC0C/!OC0BLS!/RXD0)); also elsewhere on the board
UART_EXP_TX: U2.13 (PC3(OC0D/OC0BHS/TXD0)); also elsewhere on the board
UART_GND_RX: U2.22 (PD2(OC0C/RXD0)); also elsewhere on the board
UART_GND_TX: U2.23 (PD3(OC0D/TXD0)); also elsewhere on the board

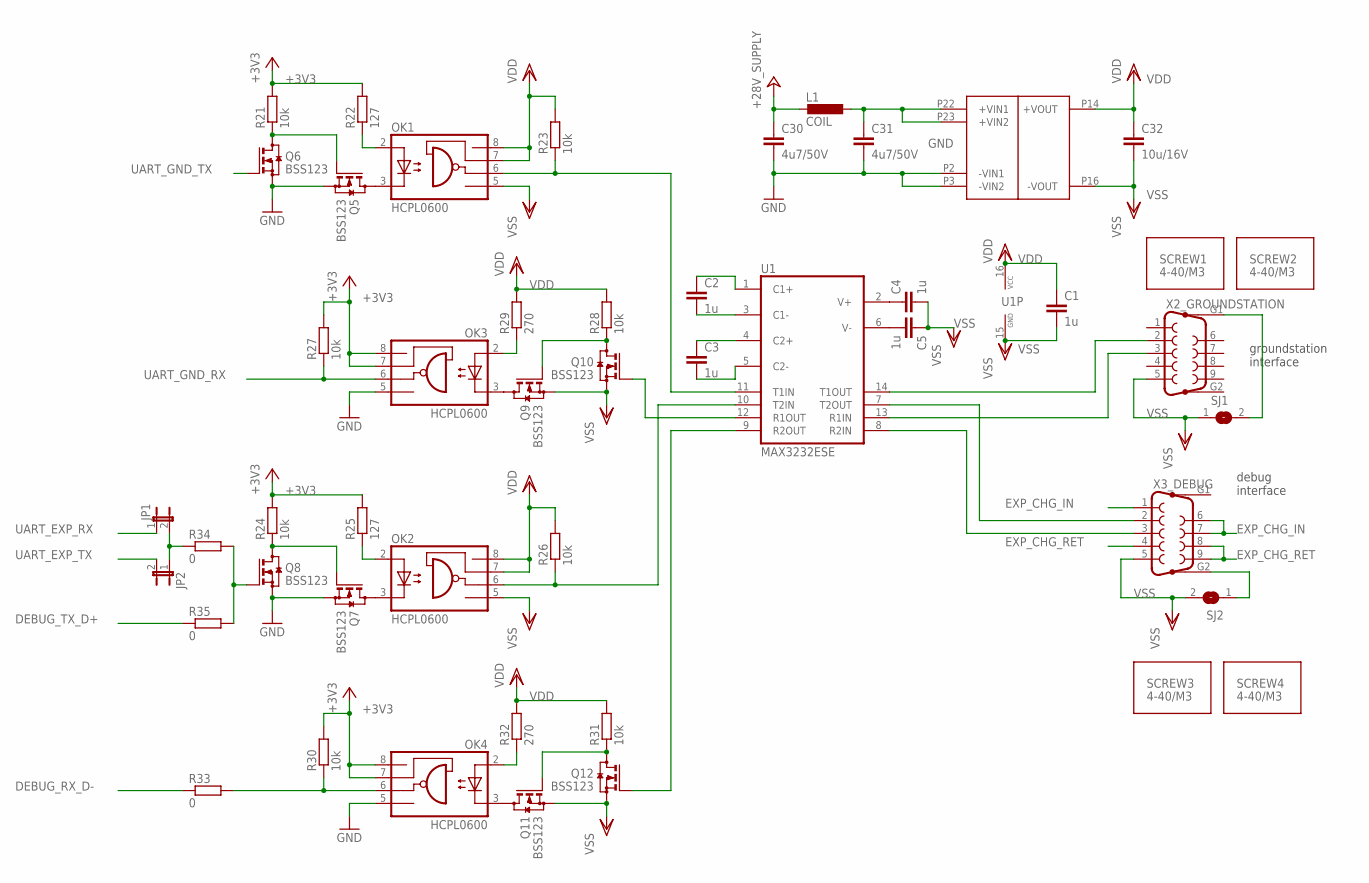
[picture p56: schematic rxsms-2.0.sch, sheet 2]

Parts:
C1, C2, C3, C4, C5: 1u; C0805K
C30, C31: 4u7/50V; C0805K
C32: 10u/16V; C0805K
JP1, JP2: JP1E; JP1
L1: COIL; BOURNS-SRR0906
OK1, OK2, OK3, OK4: HCPL0600; SOIC08
Q5, Q6, Q7, Q8, Q9, Q10, Q11, Q12: BSS123; SOT23
R21, R23, R24, R26, R27, R28, R30, R31: 10k; R0805
R22, R25: 127; R0805
R29, R32: 270; R0805
R33, R34, R35: 0; R0805
SCREW1, SCREW2, SCREW3, SCREW4: 4-40/M3; SCREW_DUMMY
SJ1, SJ2: SJ
U1: MAX3232ESE; SO16
U$10: TEN3-2410N
X2_GROUNDSTATION, X3_DEBUG: F09HP

Connections:
+3V3: OK3.7 (VE), OK3.8 (VCC), OK4.7 (VE), OK4.8 (VCC), R21.2, R22.2, R24.2, R25.2, R27.2, R30.2; also elsewhere on the board
+28V_SUPPLY: C30.1, L1.P4 (2); also elsewhere on the board
DEBUG_RX_D-: R33.1; also elsewhere on the board
DEBUG_TX_D+: R35.1; also elsewhere on the board
EXP_CHG_IN: X3_DEBUG.1, X3_DEBUG.6, X3_DEBUG.7; also elsewhere on the board
EXP_CHG_RET: X3_DEBUG.4, X3_DEBUG.8, X3_DEBUG.9; also elsewhere on the board
GND: C30.2, C31.2, OK3.5 (GND), OK4.5 (GND), Q5.2 (S), Q6.2 (S), Q7.2 (S), Q8.2 (S), U$10.P2 (-VIN1), U$10.P3 (-VIN2); also elsewhere on the board
unnamed: C4.1, U1.2 (V+)
unnamed: C5.2, U1.6 (V-)
unnamed: U1.14 (T1OUT), X2_GROUNDSTATION.2
unnamed: C2.2, U1.3 (C1-)
unnamed: C2.1, U1.1 (C1+)
unnamed: C3.1, U1.4 (C2+)
unnamed: C3.2, U1.5 (C2-)
unnamed: U1.13 (R1IN), X2_GROUNDSTATION.3
unnamed: U1.7 (T2OUT), X3_DEBUG.2
unnamed: U1.8 (R2IN), X3_DEBUG.3
unnamed: OK1.3 (C), Q5.3 (D)
unnamed: OK1.6 (VO), R23.1, U1.11 (T1IN)
unnamed: Q5.1 (G), Q6.3 (D), R21.1
unnamed: Q11.1 (G), Q12.3 (D), R31.1
unnamed: OK1.2 (A), R22.1
unnamed: OK2.3 (C), Q7.3 (D)
unnamed: OK2.2 (A), R25.1
unnamed: OK2.6 (VO), R26.1, U1.10 (T2IN)
unnamed: Q7.1 (G), Q8.3 (D), R24.1
unnamed: Q9.1 (G), Q10.3 (D), R28.1
unnamed: OK3.3 (C), Q9.3 (D)
unnamed: OK4.3 (C), Q11.3 (D)
unnamed: OK3.2 (A), R29.1
unnamed: OK4.2 (A), R32.1
unnamed: Q10.1 (G), U1.12 (R1OUT)
unnamed: Q12.1 (G), U1.9 (R2OUT)
unnamed: OK4.6 (VO), R30.1, R33.2
unnamed: Q8.1 (G), R34.2, R35.2
unnamed: SJ1.2, X2_GROUNDSTATION.G1
unnamed: SJ2.1, X3_DEBUG.G2
unnamed: JP1.2, JP2.1, R34.1
unnamed: C31.1, L1.P1 (1), U$10.P22 (+VIN1), U$10.P23 (+VIN2)
UART_EXP_RX: JP1.1; also elsewhere on the board
UART_EXP_TX: JP2.2; also elsewhere on the board
UART_GND_RX: OK3.6 (VO), R27.1; also elsewhere on the board
UART_GND_TX: Q6.1 (G); also elsewhere on the board
VDD: C1.1, C32.1, OK1.7 (VE), OK1.8 (VCC), OK2.7 (VE), OK2.8 (VCC), R23.2, R26.2, R28.2, R29.2, R31.2, R32.2, U1.16 (VCC), U$10.P14 (+VOUT)
VSS: C1.2, C4.2, C5.1, C32.2, OK1.5 (GND), OK2.5 (GND), Q9.2 (S), Q10.2 (S), Q11.2 (S), Q12.2 (S), SJ1.1, SJ2.2, U1.15 (GND), U$10.P16 (-VOUT), X2_GROUNDSTATION.5, X3_DEBUG.5

Notes on the sheet:
groundstation interface
debug interface

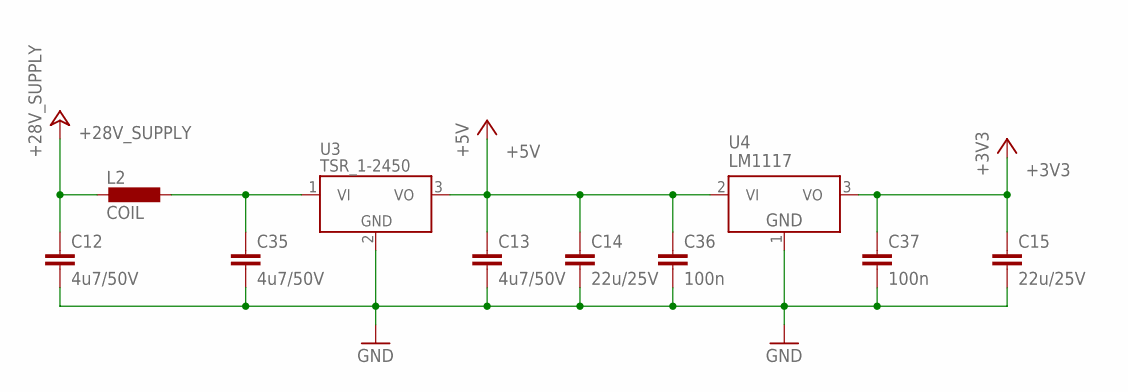
[picture p57: schematic rxsms-2.0.sch, sheet 3]

Parts:
C12, C13, C35: 4u7/50V; C0805K
C14, C15: 22u/25V; C0805K
C36, C37: 100n; C0805K
L2: COIL; BOURNS-SRR0906
U3: TSR_1-2450; TSR-1
U4: LM1117; TO252

Connections:
+3V3: C15.1, C37.1, U4.3 (VO); also elsewhere on the board
+5V: C13.1, C14.1, C36.1, U3.3 (VO), U4.2 (VI); also elsewhere on the board
+28V_SUPPLY: C12.1, L2.P4 (2); also elsewhere on the board
GND: C12.2, C13.2, C14.2, C15.2, C35.2, C36.2, C37.2, U3.2 (GND), U4.1 (GND); also elsewhere on the board
VI: C35.1, L2.P1 (1), U3.1 (VI)

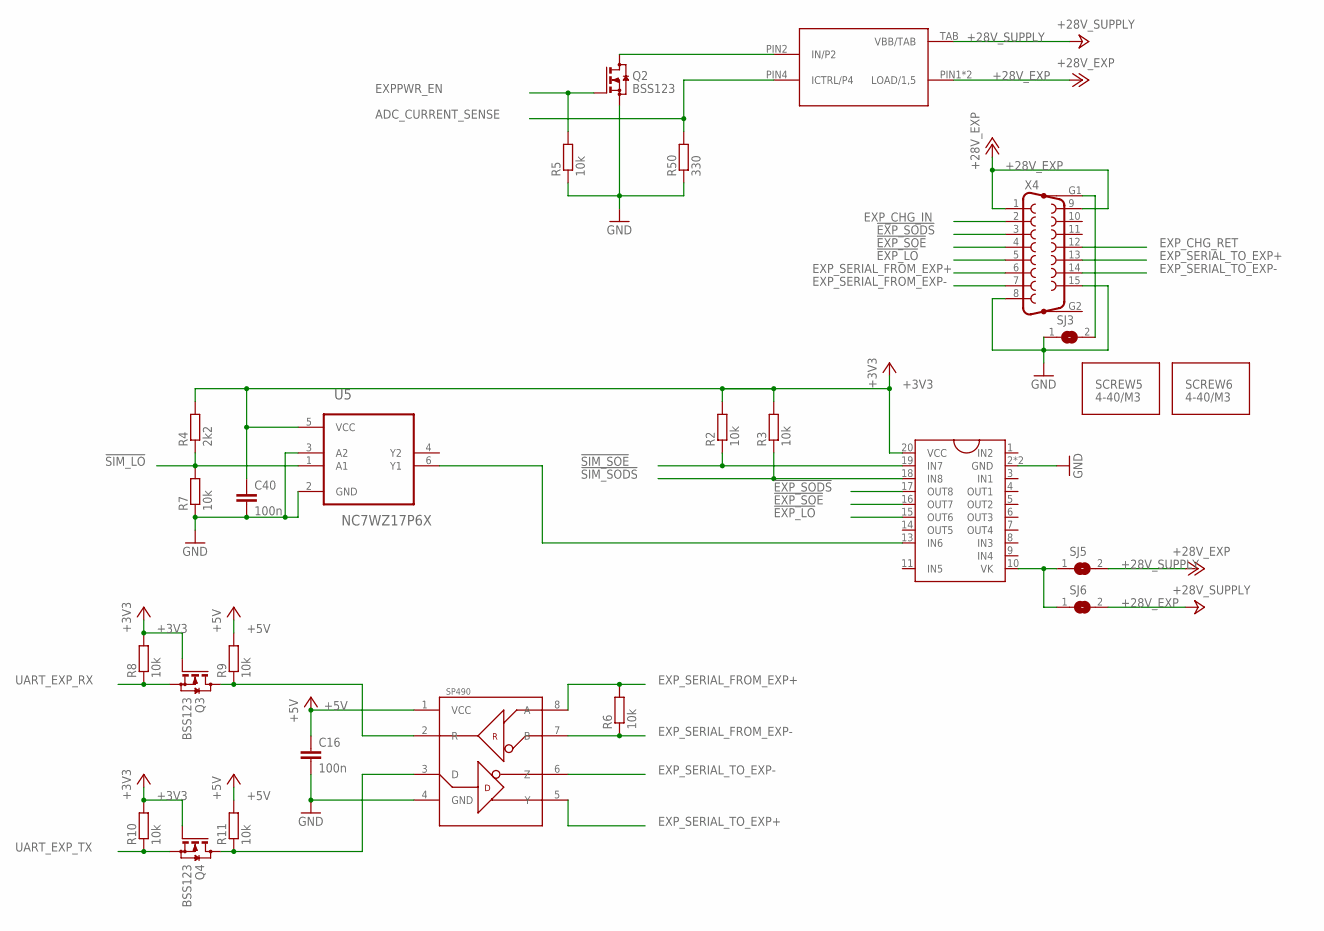
[picture p58: schematic rxsms-2.0.sch, sheet 4]

Parts:
C16, C40: 100n; C0805K
Q2, Q3, Q4: BSS123; SOT23
R2, R3, R5, R6, R7, R8, R9, R10, R11: 10k; R0805
R4: 2k2; R0805
R50: 330; R0805
SCREW5, SCREW6: 4-40/M3; SCREW_DUMMY
SJ3, SJ5, SJ6: SJ
U5: NC7WZ17P6X; SOT65P210X110-6N
U$4: UDN2596; DIL20
U$5: SP490; SO08
U$6: BTS6143; TO-252-5-1
X4: F15HP

Connections:
!EXP_LO: U$4.15 (OUT6), X4.5; also elsewhere on the board
!EXP_SODS: U$4.17 (OUT8), X4.3
!EXP_SOE: U$4.16 (OUT7), X4.4
!SIM_LO: R4.1, R7.2, U5.1 (A1); also elsewhere on the board
!SIM_SODS: R3.1, U$4.18 (IN8); also elsewhere on the board
!SIM_SOE: R2.1, U$4.19 (IN7); also elsewhere on the board
+3V3: C40.1, Q3.1 (G), Q4.1 (G), R2.2, R3.2, R4.2, R8.2, R10.2, U5.5 (VCC), U$4.20 (VCC); also elsewhere on the board
+5V: C16.1, R9.2, R11.2, U$5.1 (VCC); also elsewhere on the board
+28V_EXP: SJ6.2, U$6.PIN1 (LOAD/1,5), U$6.PIN5 (LOAD/1,5), X4.1, X4.9
+28V_SUPPLY: SJ5.2, U$6.TAB (VBB/TAB); also elsewhere on the board
ADC_CURRENT_SENSE: R50.2, U$6.PIN4 (ICTRL/P4); also elsewhere on the board
EXPPWR_EN: Q2.1 (G), R5.2; also elsewhere on the board
EXP_CHG_IN: X4.2; also elsewhere on the board
EXP_CHG_RET: X4.12; also elsewhere on the board
EXP_SERIAL_FROM_EXP+: R6.2, U$5.8 (A), X4.6
EXP_SERIAL_FROM_EXP-: R6.1, U$5.7 (B), X4.7
EXP_SERIAL_TO_EXP+: U$5.5 (Y), X4.13
EXP_SERIAL_TO_EXP-: U$5.6 (Z), X4.14
GND: C16.2, C40.2, Q2.2 (S), R5.1, R7.1, R50.1, SJ3.1, U5.2 (GND), U5.3 (A2), U$4.2 (GND), U$4.12 (GND), U$5.4 (GND), X4.8, X4.15; also elsewhere on the board
unnamed: Q2.3 (D), U$6.PIN2 (IN/P2)
unnamed: Q3.3 (D), R9.1, U$5.2 (R)
unnamed: Q4.3 (D), R11.1, U$5.3 (D)
unnamed: SJ5.1, SJ6.1, U$4.10 (VK)
unnamed: SJ3.2, X4.G1
unnamed: U5.6 (Y1), U$4.13 (IN6)
UART_EXP_RX: Q3.2 (S), R8.1; also elsewhere on the board
UART_EXP_TX: Q4.2 (S), R10.1; also elsewhere on the board

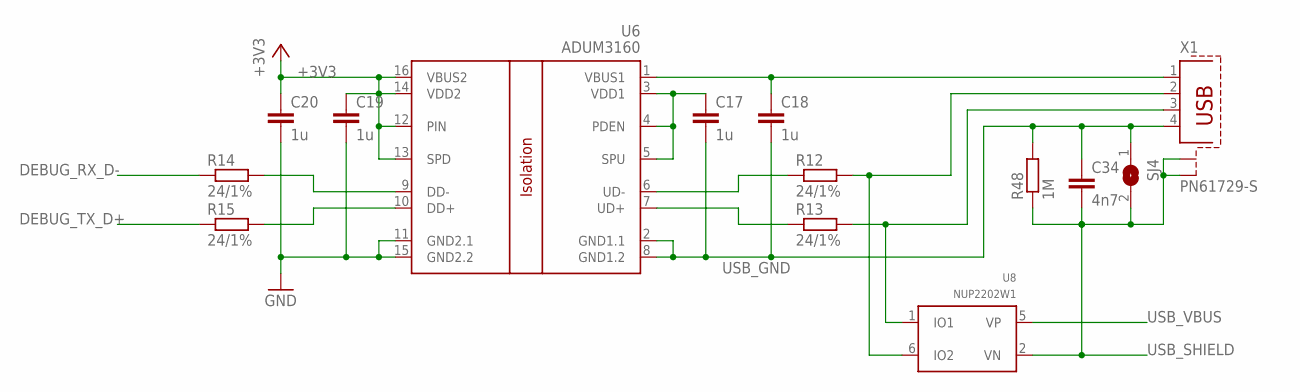
[picture p59: schematic rxsms-2.0.sch, sheet 5]

Parts:
C17, C18, C19, C20: 1u; C0805K
C34: 4n7; C0805K
R12, R13, R14, R15: 24/1%; R0805
R48: 1M; R0805
SJ4: SJ
U6: ADUM3160; SO-16W
U8: NUP2202W1; SOT363_PHILIPS
X1: PN61729-S

Connections:
+3V3: C19.1, C20.1, U6.12 (PIN), U6.13 (SPD), U6.14 (VDD2), U6.16 (VBUS2); also elsewhere on the board
DEBUG_RX_D-: R14.1; also elsewhere on the board
DEBUG_TX_D+: R15.1; also elsewhere on the board
GND: C19.2, C20.2, U6.11 (GND2.1), U6.15 (GND2.2); also elsewhere on the board
unnamed: C17.1, U6.3 (VDD1), U6.4 (PDEN), U6.5 (SPU)
unnamed: R12.1, U6.6 (UD-)
unnamed: R13.1, U6.7 (UD+)
unnamed: R12.2, U8.6 (IO2), X1.2
unnamed: R14.2, U6.9 (DD-)
unnamed: R15.2, U6.10 (DD+)
unnamed: R13.2, U8.1 (IO1), X1.3
USB_GND: C17.2, C18.2, C34.1, R48.2, SJ4.1, U6.2 (GND1.1), U6.8 (GND1.2), X1.4
USB_SHIELD: C34.2, R48.1, SJ4.2, U8.2 (VN), X1.S1, X1.S2
USB_VBUS: C18.1, U6.1 (VBUS1), U8.5 (VP), X1.1

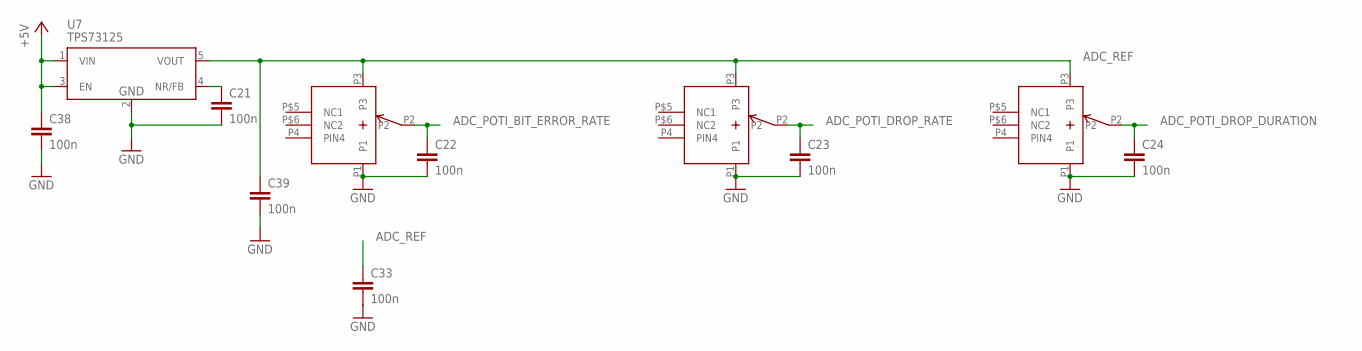
[picture p60: schematic rxsms-2.0.sch, sheet 6]

Parts:
C21, C22, C23, C24, C33, C38, C39: 100n; C0805K
U7: TPS73125; SOT25
U$7_BER, U$8_DROPR, U$9_DROPDUR: 50k; VERT_POTI

Connections:
+5V: C38.1, U7.1 (VIN), U7.3 (EN); also elsewhere on the board
ADC_POTI_BIT_ERROR_RATE: C22.1, U$7_BER.P2; also elsewhere on the board
ADC_POTI_DROP_DURATION: C24.1, U$9_DROPDUR.P2; also elsewhere on the board
ADC_POTI_DROP_RATE: C23.1, U$8_DROPR.P2; also elsewhere on the board
ADC_REF: C33.1, C39.1, U7.5 (VOUT), U$7_BER.P3, U$8_DROPR.P3, U$9_DROPDUR.P3; also elsewhere on the board
GND: C21.2, C22.2, C23.2, C24.2, C33.2, C38.2, C39.2, U7.2 (GND), U$7_BER.P1, U$8_DROPR.P1, U$9_DROPDUR.P1; also elsewhere on the board
unnamed: C21.1, U7.4 (NR/FB)

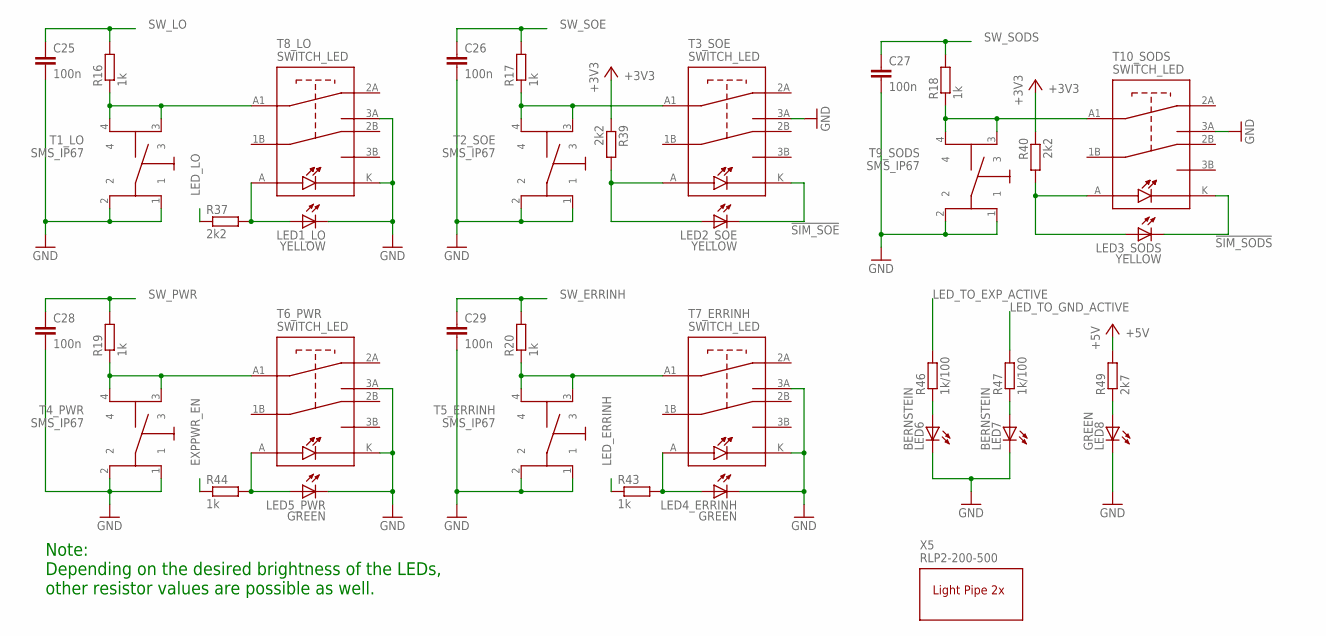
[picture p61: schematic rxsms-2.0.sch, sheet 7]

Parts:
C25, C26, C27, C28, C29: 100n; C0805K
LED1_LO, LED2_SOE, LED3_SODS: YELLOW; CHIPLED_1206
LED4_ERRINH, LED5_PWR, LED8: GREEN; CHIPLED_1206
LED6, LED7: BERNSTEIN; CHIPLED_1206
R16, R17, R18, R19, R20, R43, R44: 1k; R0805
R37, R39, R40: 2k2; R0805
R46, R47: 1k/100; R0805
R49: 2k7; R0805
T1_LO, T2_SOE, T4_PWR, T5_ERRINH, T9_SODS: SMS_IP67; IP67
T3_SOE, T6_PWR, T7_ERRINH, T8_LO, T10_SODS: SWITCH_LED
X5: RLP2-200-500

Connections:
!SIM_SODS: LED3_SODS.C, T10_SODS.K; also elsewhere on the board
!SIM_SOE: LED2_SOE.C, T3_SOE.K; also elsewhere on the board
+3V3: R39.1, R40.1; also elsewhere on the board
+5V: R49.2; also elsewhere on the board
EXPPWR_EN: R44.1; also elsewhere on the board
GND: C25.2, C26.2, C27.2, C28.2, C29.2, LED1_LO.C, LED4_ERRINH.C, LED5_PWR.C, LED6.C, LED7.C, LED8.C, T1_LO.1, T1_LO.2, T2_SOE.1, T2_SOE.2, T3_SOE.3A, T4_PWR.1, T4_PWR.2, T5_ERRINH.1, T5_ERRINH.2, T6_PWR.3A, T6_PWR.K, T7_ERRINH.3A, T7_ERRINH.K, T8_LO.3A, T8_LO.K, T9_SODS.1, T9_SODS.2, T10_SODS.3A; also elsewhere on the board
LED_ERRINH: R43.1; also elsewhere on the board
LED_LO: R37.1; also elsewhere on the board
LED_TO_EXP_ACTIVE: R46.2; also elsewhere on the board
LED_TO_GND_ACTIVE: R47.2; also elsewhere on the board
unnamed: LED2_SOE.A, R39.2, T3_SOE.A
unnamed: LED3_SODS.A, R40.2, T10_SODS.A
unnamed: LED8.A, R49.1
unnamed: R16.1, T1_LO.3, T1_LO.4, T8_LO.A1 (1A)
unnamed: R17.1, T2_SOE.3, T2_SOE.4, T3_SOE.A1 (1A)
unnamed: R18.1, T9_SODS.3, T9_SODS.4, T10_SODS.A1 (1A)
unnamed: LED1_LO.A, R37.2, T8_LO.A
unnamed: R19.1, T4_PWR.3, T4_PWR.4, T6_PWR.A1 (1A)
unnamed: R20.1, T5_ERRINH.3, T5_ERRINH.4, T7_ERRINH.A1 (1A)
unnamed: LED4_ERRINH.A, R43.2, T7_ERRINH.A
unnamed: LED5_PWR.A, R44.2, T6_PWR.A
unnamed: LED6.A, R46.1
unnamed: LED7.A, R47.1
SW_ERRINH: C29.1, R20.2; also elsewhere on the board
SW_LO: C25.1, R16.2; also elsewhere on the board
SW_PWR: C28.1, R19.2; also elsewhere on the board
SW_SODS: C27.1, R18.2; also elsewhere on the board
SW_SOE: C26.1, R17.2; also elsewhere on the board

Notes on the sheet:
Note: Depending on the desired brightness of the LEDs, other resistor values are possible as well.

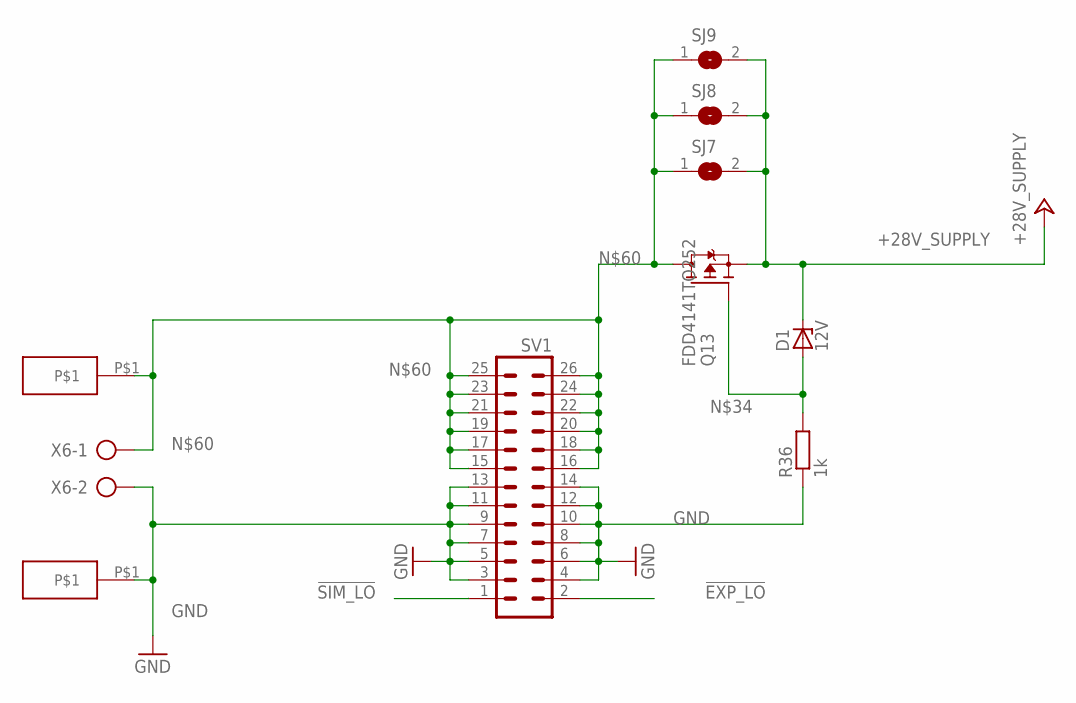
[picture p62: schematic rxsms-2.0.sch, sheet 8]

Parts:
D1: 12V; DO34Z7
Q13: FDD4141TO252; TO252
R36: 1k; R0805
SJ7, SJ8, SJ9: SJ
SV1: ML26L
U$3: black; JACK
U$9: red; JACK
X6: AK500/2

Connections:
!EXP_LO: SV1.2; also elsewhere on the board
!SIM_LO: SV1.1; also elsewhere on the board
+28V_SUPPLY: D1.C, Q13.2 (S), SJ7.2, SJ8.2, SJ9.2; also elsewhere on the board
GND: R36.1, SV1.3, SV1.4, SV1.5, SV1.6, SV1.7, SV1.8, SV1.9, SV1.10, SV1.11, SV1.12, SV1.13, SV1.14, U$3.P$1, X6.2; also elsewhere on the board
unnamed: D1.A, Q13.1 (G), R36.2
unnamed: Q13.3 (D), SJ7.1, SJ8.1, SJ9.1, SV1.15, SV1.16, SV1.17, SV1.18, SV1.19, SV1.20, SV1.21, SV1.22, SV1.23, SV1.24, SV1.25, SV1.26, U$9.P$1, X6.1

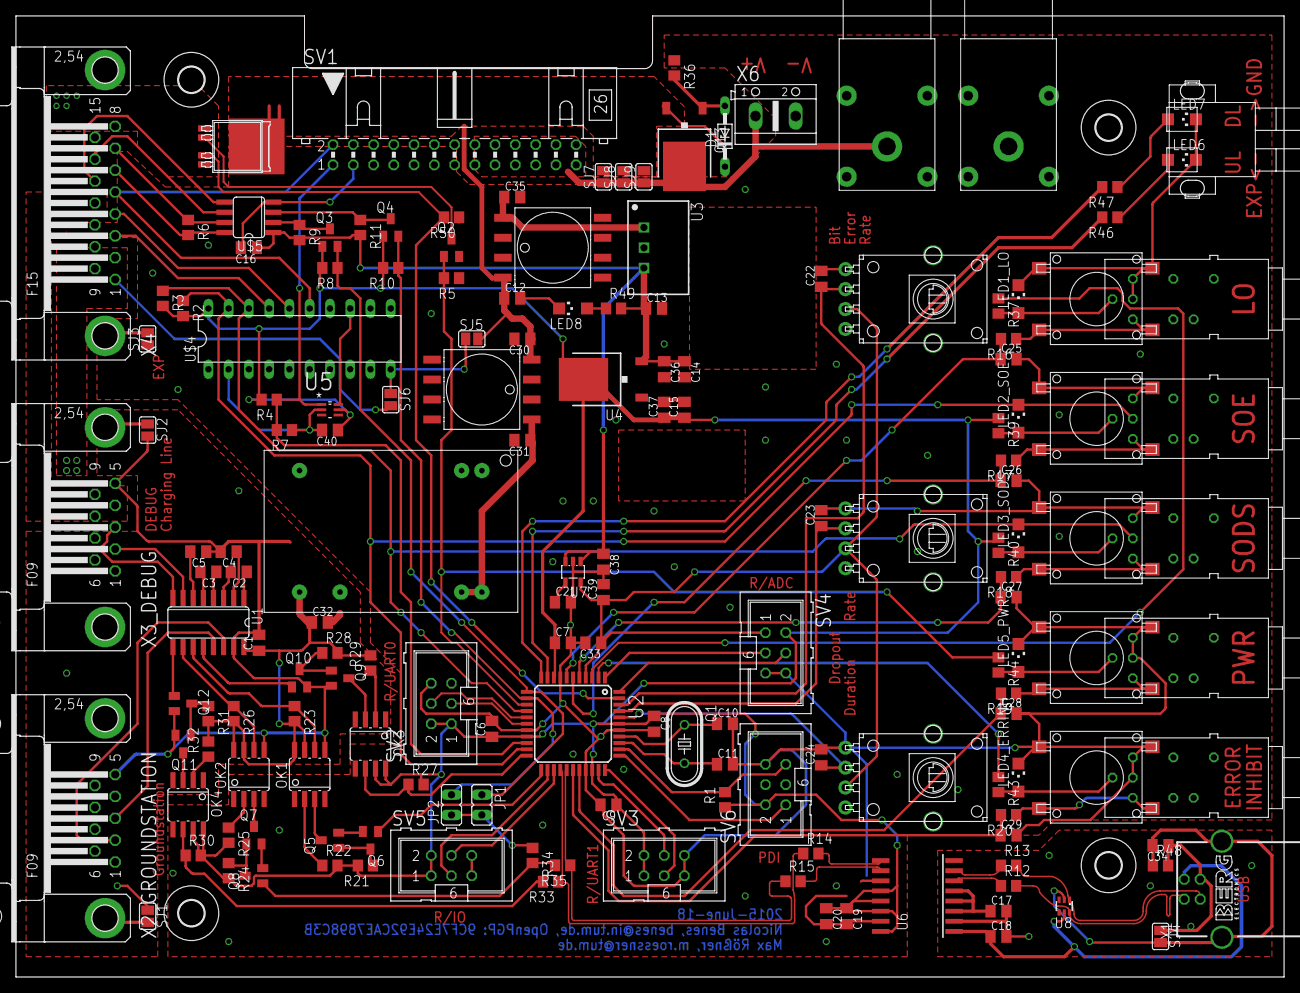
[picture p63: board rxsms-2.0.brd from above]

Board: 2 copper layers, 159.0 x 120.5 mm, 174 parts (0 on the bottom side), 117 nets.

Other parts of the board:
U$1, U$2, U$7, U$8: 3,2
