rx-viper/rxsms/eagle/pwrcircuit/rxsms-2.0-Stromvers.brd

## EAGLE design eagle/pwrcircuit/rxsms-2.0-Stromvers.brd (2015-04-29)

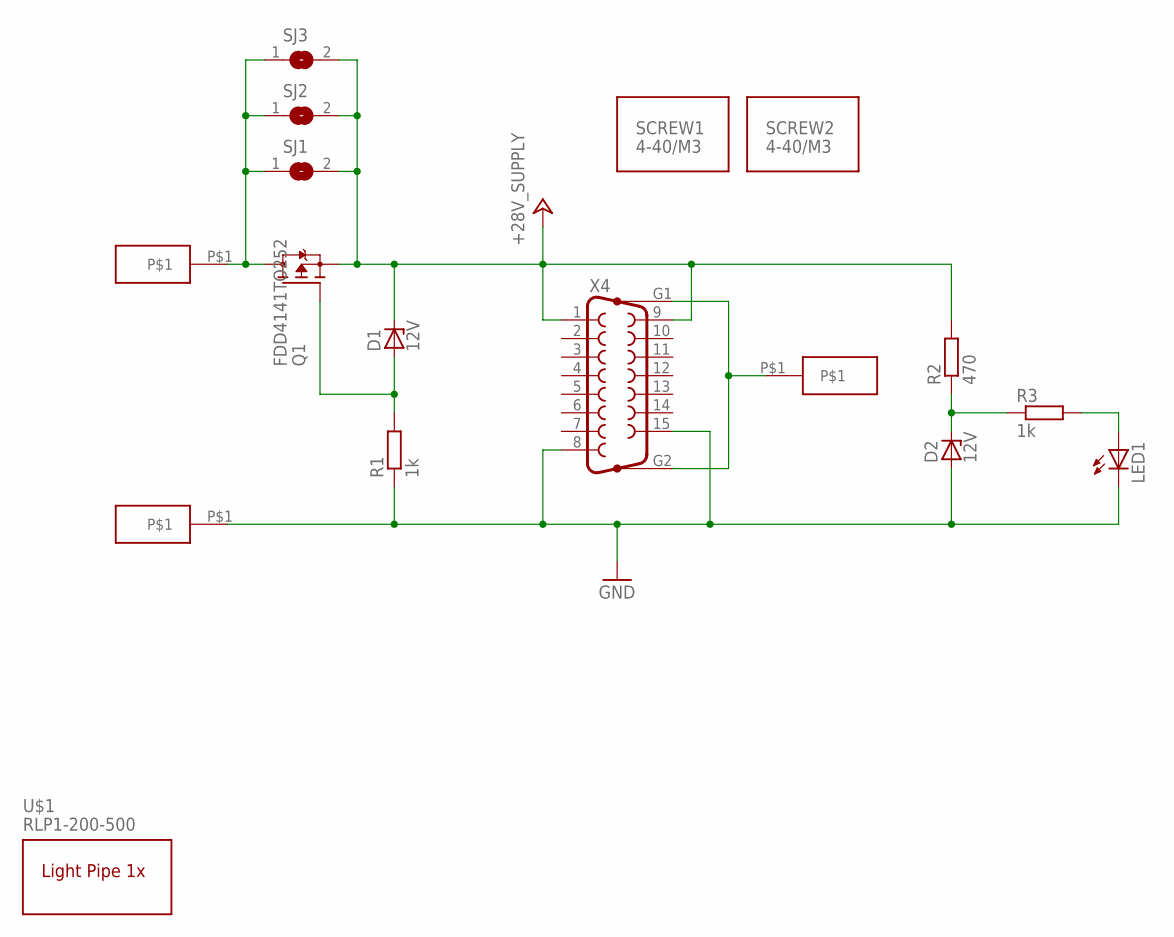
[picture p64: schematic rxsms-2.0-Stromvers.sch, sheet 1]

Parts:
D1, D2: 12V; DO34Z7
LED1: LEDCHIPLED_0805; CHIPLED_0805
Q1: FDD4141TO252; TO252
R1, R3: 1k; R0805
R2: 470; R0805
SCREW1, SCREW2: 4-40/M3; SCREW_DUMMY
SJ1, SJ2, SJ3: SJ
U$1: RLP1-200-500
U$3, U$4, U$5: JACK
X4: F15HP

Connections:
+28V_SUPPLY: D1.C, Q1.2 (S), R2.2, SJ1.2, SJ2.2, SJ3.2, X4.1, X4.9; also elsewhere on the board
BLUB: Q1.3 (D), SJ1.1, SJ2.1, SJ3.1, U$3.P$1
GND: D2.A, LED1.C, R1.1, U$4.P$1, X4.8, X4.15; also elsewhere on the board
unnamed: D2.C, R2.1, R3.1
unnamed: D1.A, Q1.1 (G), R1.2
unnamed: LED1.A, R3.2
PE: U$5.P$1, X4.G1, X4.G2

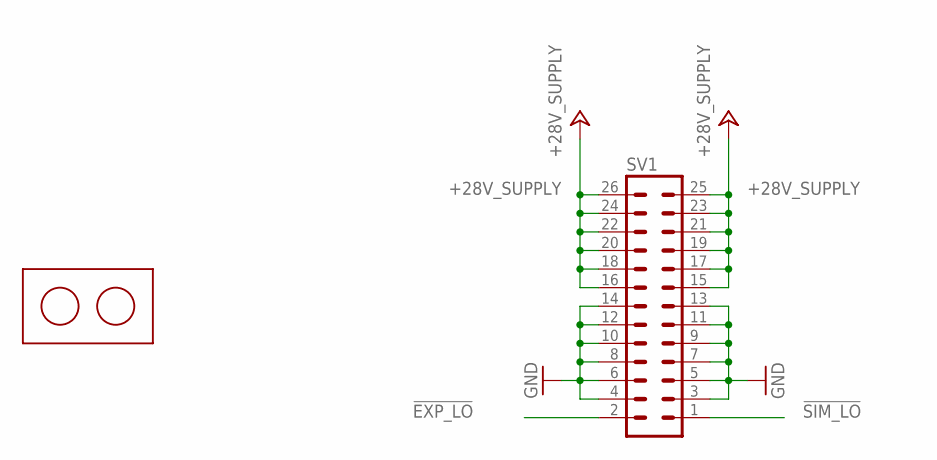
[picture p65: schematic rxsms-2.0-Stromvers.sch, sheet 2]

Parts:
SV1: ML26L
U$6: BUERKLIN17H912

Connections:
+28V_SUPPLY: SV1.15, SV1.16, SV1.17, SV1.18, SV1.19, SV1.20, SV1.21, SV1.22, SV1.23, SV1.24, SV1.25, SV1.26; also elsewhere on the board
GND: SV1.3, SV1.4, SV1.5, SV1.6, SV1.7, SV1.8, SV1.9, SV1.10, SV1.11, SV1.12, SV1.13, SV1.14; also elsewhere on the board

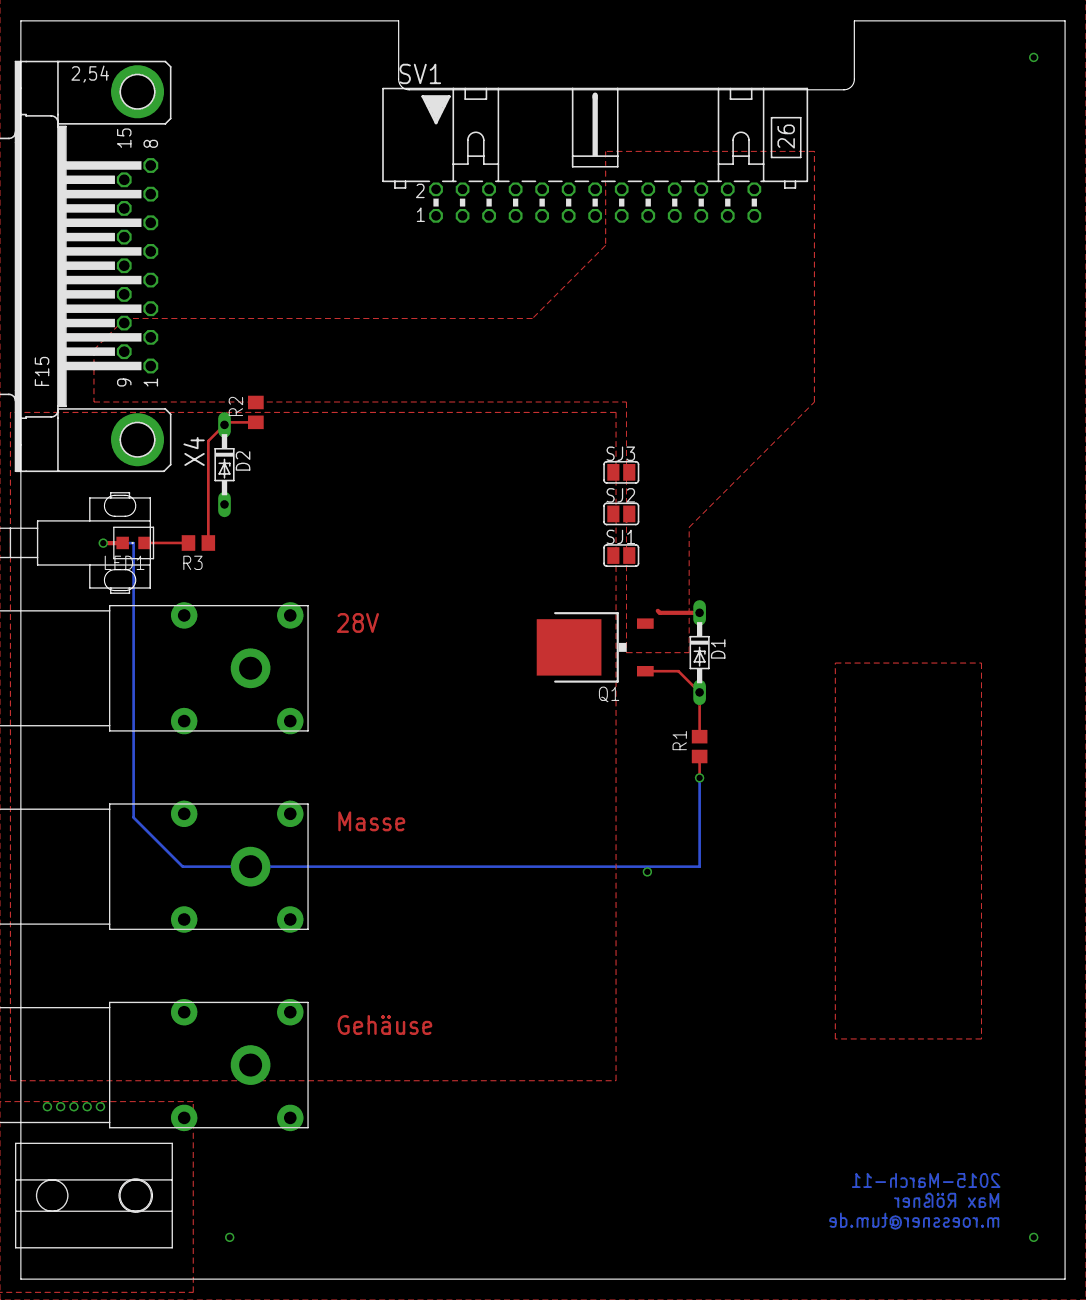
[picture p66: board rxsms-2.0-Stromvers.brd from above]

Board: 2 copper layers, 100.0 x 120.5 mm, 19 parts (0 on the bottom side), 7 nets.
