rx-viper/rxsms/eagle/Testplatine/Testplatine_01_wiebeauftragt.brd

## EAGLE design eagle/Testplatine/Testplatine_01_wiebeauftragt.brd (2015-03-17)

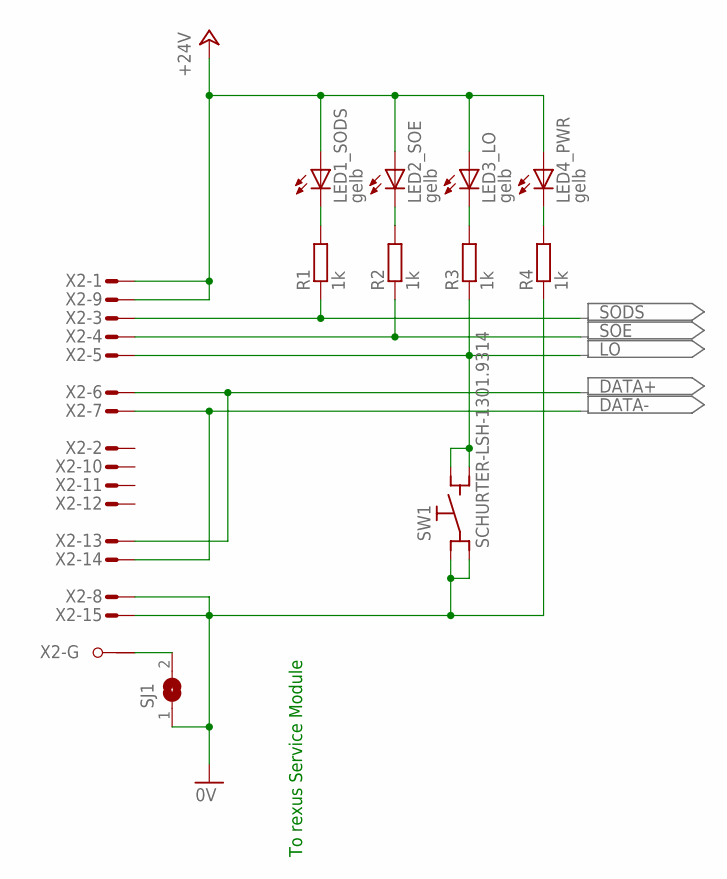
[picture p67: schematic Testplatine_01_wiebeauftragt.sch]

Parts:
LED1_SODS, LED2_SOE, LED3_LO, LED4_PWR: gelb; CHIPLED_0805
R1, R2, R3, R4: 1k; R0805
SJ1: SJ
SW1: SCHURTER-LSH-1301.9314; LSH
X2: M15HPS; M15HP

Connections:
0V: R4.1, SJ1.1, SW1.C1 (C), SW1.C2 (C), X2.8 (M), X2.15 (M)
+24V: LED1_SODS.A, LED2_SOE.A, LED3_LO.A, LED4_PWR.A, X2.1 (M), X2.9 (M)
DATA+: X2.6 (M), X2.13 (M)
DATA-: X2.7 (M), X2.14 (M)
LO: R3.1, SW1.NO1 (NO), SW1.NO2 (NO), X2.5 (M)
unnamed: LED1_SODS.C, R1.2
unnamed: LED2_SOE.C, R2.2
unnamed: LED3_LO.C, R3.2
unnamed: LED4_PWR.C, R4.2
unnamed: SJ1.2, X2.G1
SODS: R1.1, X2.3 (M)
SOE: R2.1, X2.4 (M)

Notes on the sheet:
To rexus Service Module

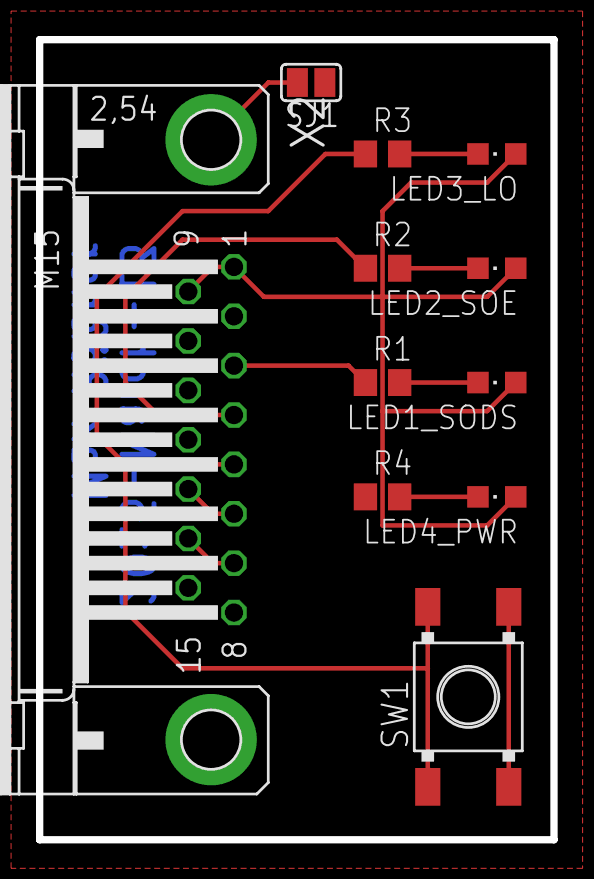
[picture p68: board Testplatine_01_wiebeauftragt.brd from above]

Board: 2 copper layers, 28.6 x 44.5 mm, 11 parts (0 on the bottom side), 12 nets.
