rx-viper/rxsms/code/main.c

/*
 *   This file is part of RXSMS.
 *   Copyright 2014  Kholodkov Jakov (original RXSMS author),
 *                   Thomas Grübler (Mentor)
 *             2014, 2015  Nicolas Benes
 *
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
 *   You should have received a copy of the GNU General Public License
 *   along with RXSMS.  If not, see <http://www.gnu.org/licenses/>.
 */

#include <avr/interrupt.h>
#include "init.h"
#include "sched.h"

// NOTE:
// We may use other FUSE settings, for instance to enable brown-out detection,
// but it works fine without them now.
// If they become necessary at a later point in time, we can add them then.
//
//      see FUSE_FUSEBYTE1..5 in the uC's io.h (ATxmega32A4u: iox32a4u.h)

/// Initialize and start the scheduler, and as a result all tasks.
int
main(void)
{
    init();

    sched_init();
    sched_start();
    sei();

    while (1) {
        // nothing much to do here:
        // the fun happens in the tasks executed by the scheduler ISR
        //      see sched.c and task_*.c
    }
}
