rx-viper/rxsms/code/task_buttons.c

/*
 *   This file is part of RXSMS.
 *   Copyright 2014, 2015  Nicolas Benes
 *
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
 *   You should have received a copy of the GNU General Public License
 *   along with RXSMS.  If not, see <http://www.gnu.org/licenses/>.
 */

#include <avr/io.h>
#include "task_buttons.h"

// Ressources used _once_ by this task:
// (none)
//
// Ressources _continously_ used by this task:
// BUTTON_PORT: BUTTON_LO_bp BUTTON_SOE_bp BUTTON_SODS_bp BUTTON_ERRINH_bp
// BUTTON_EXTENDED_PORT: BUTTON_EXTENDED_PWR_bp

#define BUTTON_PORT         PORTB
#define BUTTON_LO_bp        PIN3_bp
#define BUTTON_SOE_bp       PIN2_bp
#define BUTTON_SODS_bp      PIN1_bp

#define BUTTON_EXTENDED_PORT        PORTE
#define BUTTON_EXTENDED_PWR_bp      PIN1_bp
#define BUTTON_EXTENDED_ERRINH_bp   PIN0_bp

/// The minimum time a button must be pressed to be counted as valid signal
#define DURATION_DEBOUNCE    125

static void init(void);
static void run(void);

const struct task task_buttons = { .init = &init, .run = &run };

struct button {
    uint8_t pressed;
    uint8_t released;
    uint8_t triggered : 1;
};

#define BUTTON_INITIALIZER {.pressed = DURATION_DEBOUNCE, \
                            .released = DURATION_DEBOUNCE, \
                            .triggered = 0}
#define BUTTON(name)    static struct button name = BUTTON_INITIALIZER
BUTTON(lo);
BUTTON(soe);
BUTTON(sods);
BUTTON(errinh);
BUTTON(pwr);
#undef BUTTON
#undef BUTTON_INITIALIZER

static void
init(void)
{
    BUTTON_PORT.DIRCLR = _BV(BUTTON_LO_bp) | _BV(BUTTON_SOE_bp)
        | _BV(BUTTON_SODS_bp);
    BUTTON_EXTENDED_PORT.DIRCLR = _BV(BUTTON_EXTENDED_PWR_bp)
        | _BV(BUTTON_EXTENDED_ERRINH_bp);

    // must be done in two steps to allow resolving of num in PINCTRL first,
    // before doing the actual conatenation/token pasting; otherwise we would
    // get something like PINBUTTON_SOE_bpCTRL, which we do not want!
#define PINCTRL_CONCAT(num) PIN##num##CTRL
#define PINCTRL(num)        PINCTRL_CONCAT(num)
    BUTTON_PORT.PINCTRL(BUTTON_LO_bp) = PORT_OPC_PULLUP_gc;
    BUTTON_PORT.PINCTRL(BUTTON_SOE_bp) = PORT_OPC_PULLUP_gc;
    BUTTON_PORT.PINCTRL(BUTTON_SODS_bp) = PORT_OPC_PULLUP_gc;
    BUTTON_EXTENDED_PORT.PINCTRL(BUTTON_EXTENDED_PWR_bp) =
        PORT_OPC_PULLUP_gc;
    BUTTON_EXTENDED_PORT.PINCTRL(BUTTON_EXTENDED_ERRINH_bp) =
        PORT_OPC_PULLUP_gc;
#undef PINCTRL
#undef PINCTRL_CONCAT
}

static void
debounce(uint8_t current, struct button *btn)
{
    if (current) {
        if (btn->released)      // prevent underflow when already 0
            --btn->released;
        btn->pressed = DURATION_DEBOUNCE;
    } else {
        // decrease other counter only, iff we were back to normal (released)
        // state for long enough
        if (!btn->released) {
            // prevent underflow when already 0
            if (btn->pressed) {
                --btn->pressed;
            } else {
                // we have a valid low signal, so let's reset the high time
                btn->triggered = 1;
                btn->released = DURATION_DEBOUNCE;
            }
        }
    }
}

static void
run(void)
{
    const uint8_t port = BUTTON_PORT.IN;
    const uint8_t extended_port = BUTTON_EXTENDED_PORT.IN;

    debounce(port & _BV(BUTTON_LO_bp), &lo);
    debounce(port & _BV(BUTTON_SOE_bp), &soe);
    debounce(port & _BV(BUTTON_SODS_bp), &sods);
    debounce(extended_port & _BV(BUTTON_EXTENDED_ERRINH_bp), &errinh);
    debounce(extended_port & _BV(BUTTON_EXTENDED_PWR_bp), &pwr);

#define PUBLISH_STATE(signal) \
        task_buttons_toggle_request.signal = signal.triggered; \
        signal.triggered = 0
    PUBLISH_STATE(lo);
    PUBLISH_STATE(soe);
    PUBLISH_STATE(sods);
    PUBLISH_STATE(errinh);
    PUBLISH_STATE(pwr);
#undef PUBLISH_STATE
}
