rx-viper/rxsms/code/init.c

/*
 *   This file is part of RXSMS.
 *   Copyright 2014, 2015  Nicolas Benes
 *
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
 *   You should have received a copy of the GNU General Public License
 *   along with RXSMS.  If not, see <http://www.gnu.org/licenses/>.
 */

#include <avr/io.h>
#include "init.h"

/// Set the CPU clock to F_CPU Hz.
static void
clock(void)
{
    // enable 32.768 kHz and 32 MHz clock
    const uint8_t enable_clk = OSC.CTRL | OSC_RC32MEN_bm | OSC_RC32KEN_bm;
    CCP = CCP_IOREG_gc;
    OSC.CTRL = enable_clk;
    do {
        asm volatile ("");      // wait for MHz and kHz Osc
    } while (!(OSC.STATUS & OSC_RC32MRDY_bm)
             || !(OSC.STATUS & OSC_RC32KRDY_bm));

    // RC32K calibration not needed (done automatically by hardware after
    // reset), but here could go the CAL value
    //OSC.RC32KCAL = <calibration value>;

    // select RC32K as DFLL reference and set DFLL auto run-time CAL value
    OSC.DFLLCTRL |= OSC_RC32MCREF_RC32K_gc;
    DFLLRC32M.COMP1 = (F_CPU / 1024) & 0xff;
    DFLLRC32M.COMP2 = ((F_CPU / 1024) >> 8) & 0xff;
    DFLLRC32M.CTRL |= DFLL_ENABLE_bm;

    // select 32 MHz clock as system clock
    CCP = CCP_IOREG_gc;
    CLK.CTRL = CLK_SCLKSEL_RC32M_gc;

    // disable all prescalers (this is the default, but to make it sure)
    CCP = CCP_IOREG_gc;
    CLK.PSCTRL = CLK_PSADIV_1_gc | CLK_PSBCDIV_1_1_gc;

    // disable 2MHz internal osc
    const uint8_t disable_clk = OSC.CTRL & (~OSC_RC2MEN_bm);
    CCP = CCP_IOREG_gc;
    OSC.CTRL = disable_clk;

    // disable all further changes to the clock system
    CCP = CCP_IOREG_gc;
    CLK.LOCK = CLK_LOCK_bm;
}

/// Power down all peripherals by default.
static void
prr(void)
{
    PR.PRGEN = PR_USB_bm | PR_AES_bm | PR_EBI_bm | PR_RTC_bm | PR_EVSYS_bm
        | PR_DMA_bm;
    PR.PRPA = PR_DAC_bm | PR_ADC_bm | PR_AC_bm;
    PR.PRPC = PR_TWI_bm | PR_USART1_bm | PR_USART0_bm | PR_SPI_bm
        | PR_HIRES_bm | PR_TC1_bm | PR_TC0_bm;
    PR.PRPD = PR_TWI_bm | PR_USART1_bm | PR_USART0_bm | PR_SPI_bm
        | PR_HIRES_bm | PR_TC1_bm | PR_TC0_bm;
    PR.PRPE = PR_TWI_bm | PR_USART1_bm | PR_USART0_bm | PR_SPI_bm
        | PR_HIRES_bm | PR_TC1_bm | PR_TC0_bm;
}

/// Enable the DMA *Controller* so tasks can initialize their individual
/// DMA *Channels*.
static void
dma(void)
{
    PR.PRGEN &= ~PR_DMA_bm;
    DMA.CTRL =
        DMA_ENABLE_bm | DMA_DBUFMODE_DISABLED_gc | DMA_PRIMODE_RR0123_gc;
}

void
init(void)
{
    clock();
    prr();

    dma();
}
