rx-viper/rxsms/(commit log)

2014-08-31 migration to own init and adc implementation
2014-09-01 also cleanup the intermediate *.i and *.s files, if the --save-temps switch was set in the Makefile
2014-09-01 added scheduling and the button debounce task and RXSM CTRL interface task
2014-10-31 migrate ADC sampling from background task to foreground
2014-10-31 refactor ADC sampling task
2014-10-31 updated schematics to fix ADC ref voltage
    [rauschsimulator_V4.sch]
2014-11-01 enabled ADC sample task
2014-11-02 ignore incoming traffic from groundstation if LO is given
2014-11-02 refactor and add range check for ADC result
2014-11-03 bit error generation added
    [task_sample_adc_inputs.c, task_sample_adc_inputs.h, task_sendrecv.c]
2014-11-20 also switch on Error Inhibit LED using poti values
    [task_ctrl.c]
2014-11-20 reset bit error interval in inhibit
    [task_sendrecv.c]
2014-11-21 switch to 8 slots and 200us complete cycle
2014-11-28 disable DMA since it is not used
2014-12-19 FIX: UART transmission
2015-02-13 update ADC specific defines for avr-libc 1.8.1
2015-02-14 split GPIO setup for groundstation and experiment side UART
2015-02-14 refactor UART initialization
2015-02-14 fix misleading commit: byte is not dropped here yet
    [task_sendrecv.c]
2015-02-15 refactor bit error generation to separate task
    [sched.c, task_error.c, task_error.h, task_sendrecv.c]
2015-02-16 fix wrong error pattern: flipped too many and wrong bits
    [task_error.c]
2015-02-16 fix: wrong assignment of bins on bit error generation
    [task_sample_adc_inputs.c]
2015-02-16 fix: ignore error generation if inhibit button was toggled
    [task_error.c]
2015-02-16 fix build errors due to partial variable renaming
    [task_sendrecv.c]
2015-02-16 update the UART status LEDs before sending instead of after receive
2015-02-16 simplify use of UART status LED
2015-02-16 put UART status LEDs code into single function and hide LED state/settings
2015-02-16 remove ignore_recv() function, too short for much content
    [task_sendrecv.c]
2015-02-17 simplify reception when uplink/gnd->exp is disabled after LO
2015-02-17 rename task_sample_adc_inputs to shorter task_adc
    [sched.c, task_adc.c, task_adc.h, task_ctrl.c, task_error.c]
2015-02-17 fix year in copyright notice
    [util.h]
2015-02-18 allow other tasks/compilation units to see the slot lengths and number
2015-02-18 rename buffer fr adc values to match naming convention for task variables
2015-02-18 add space for the temperature measurement results
2015-02-18 condense reading and evaluating of the ADC values
2015-02-20 fix lost values because of 16bit shift
    [task_adc.c]
2015-02-20 improve bit error generator and documentstion
    [task_adc.c]
2015-02-20 increase hysteresis width because of too much noise
    [task_adc.c]
2015-02-20 rewrite function to update the error generators' settings
    [task_error.c]
2015-02-20 make the UART status LED a bit faster
2015-03-01 schematics for new HW
    [exp-if.sch, gndsta-iso-a.sch, gndsta-iso-b.sch, input-poti-sw.sch, rxsms.sch, usb.sch]
2015-03-01 add separate 2.5V LDO for potis and ADCREF
    [input-poti-sw.sch, rxsms.sch]
2015-03-02 add connectors for two reserved UARTs
    [rxsms.sch]
2015-03-02 add optional external crystal and capacitors
    [rxsms.sch]
2015-03-02 update refdes attribute
    [input-poti-sw.sch]
2015-03-02 updated schematic PDFs
2015-03-02 fix: use 28V of the experiment to power UDN2596A
    [exp-if.sch]
2015-03-02 WIP schematics and layout
    [rxsms-2.0.brd, rxsms-2.0.sch]
2015-03-03 continued schematics
    [rxsms-2.0.brd, rxsms-2.0.sch]
2015-03-03 added current schematics as PNGs
2015-03-03 use polarized capacitors at in- and output of LD1117
    [rxsms.sch]
2015-03-03 fix: connect LD1117 tab and out
    [rxsms.sch]
2015-03-04 capacitors for isolating DCDC converter added
    [rxsms-2.0.brd, rxsms-2.0.sch]
2015-03-04 add filter for TMV0505EN
    [gndsta-iso-a.sch]
2015-03-04 added optocouplers for MAX3232
    [rxsms-2.0.brd, rxsms-2.0.sch]
2015-03-04 update TODOs in schematics and increase font size
    [rxsms-2.0.sch]
2015-03-04 added RX EXP charging line to debug serial DSUB
    [rxsms-2.0.brd, rxsms-2.0.sch]
2015-03-04 add push-button switch eagle lib
2015-03-04 second set of buttons and LEDs added
    [rxsms-2.0.brd, rxsms-2.0.sch]
2015-03-04 updated switch+led
    [rxsms-2.0.brd, rxsms-2.0.sch]
2015-03-04 replace schematic PNGs with single PDF
2015-03-05 add note that gEDA schematic is outdated
    [gndsta-iso-a.sch]
2015-03-05 progress on schematics
    * add of TVS supressor diodes for USB
    * add of RC-filter for USB
    * new library for light pipe
    * add of light-pipe to the schematics
    * add of pinheaders for two reserved UARTs
    * some resistors for LEDs updated, not final yet
    * some OC_FARNELL order codes added
    * assignment of signals to uC symbol
    * implement current sense functionality
    [rxsms-2.0.brd, rxsms-2.0.sch]
2015-03-06 updated export of schematics to PDF
2015-03-06 remove note/TODO; decide to use MLCC capacitor for LD1117
    [rxsms-2.0.sch]
2015-03-06 reordered signals on uC
    [rxsms-2.0.brd, rxsms-2.0.sch]
2015-03-06 add pinheaders for reserved ADC and GPIO pins
    [rxsms-2.0.brd, rxsms-2.0.sch]
2015-03-06 add power supply connectors
    [rxsms-2.0.brd, rxsms-2.0.sch]
2015-03-06 minor cleanup, TODOs updated
    [rxsms-2.0.sch]
2015-03-06 most components selected
    * replaced unregulated TMV regulator with TES3
    * added coil library
    * added missing coils to DCDC regulators
    * added various 100nF capacitors
    * added jumper between USB shield and RC filter
    * operate MAX3232 at 3.3V and use matching capacitors
    [rxsms-2.0.brd, rxsms-2.0.sch]
2015-03-06 updated PDF of schematics
2015-03-09 Placement of components acording to mechanical CAD
    [rxsms-2.0.brd, rxsms-2.0.sch]
2015-03-10 continued layout
    [rxsms-2.0.brd, rxsms-2.0.sch]
2015-03-10 charging line and some extension headers added
    [rxsms-2.0.brd]
2015-03-10 most of buttons connected
    [rxsms-2.0.brd]
2015-03-11 filled top and bot
    [rxsms-2.0.brd]
2015-03-11 added PDFs of schematics and layout
2015-03-12 added separate power supply board
    [rxsms-2.0-Stromvers.brd, rxsms-2.0-Stromvers.dxf, rxsms-2.0-Stromvers.sch]
2015-03-12 fix some warnings in layout and move light pipe's former dimension layer to milling layer
    [rxsms-2.0.brd, rxsms-2.0.sch]
2015-03-12 more OC_FARNELL added
    [rxsms-2.0.brd, rxsms-2.0.sch]
2015-03-12 fix: use correct lib name for TEN 3-2410N DCDC iso regulator
    [rxsms-2.0.brd, rxsms-2.0.sch]
2015-03-12 more OC added
    [rxsms-2.0.brd, rxsms-2.0.sch]
2015-03-12 added even more OC
    [rxsms-2.0.brd, rxsms-2.0.sch]
2015-03-12 more finalization on the layout
    [rxsms-2.0.brd, rxsms-2.0.sch]
2015-03-12 bom added
2015-03-12 Added logos, added ordering codes, otherwise minor changes
    [rxsms-2.0-Stromvers.brd, rxsms-2.0-Stromvers.sch]
2015-03-12 added logos
    [rxsms-2.0-Stromvers.brd, rxsms-2.0.brd, rxsms-2.0.sch]
2015-03-13 rename BOM files
2015-03-13 added OCs for 0 Ohm resistors
    [rxsms-2.0.brd, rxsms-2.0.sch]
2015-03-13 exported pwr circuit schematics, board and BOM
    [rxsms-2.0-Stromvers-parts.csv, rxsms-2.0-Stromvers-values.csv]
2015-03-13 added RXSMS experiment test circuit
    [Testplatine_01_wiebeauftragt-bom-parts.csv, Testplatine_01_wiebeauftragt-bom-values.csv, Testplatine_01_wiebeauftragt.brd, Testplatine_01_wiebeauftragt.sch]
2015-03-13 BOM for individual configurations added
    [bom.xls, bom.xlsx]
2015-03-15 converted BOM file from XLS to ODS and added variants
    [bom.ods, bom.xls, bom.xlsx]
2015-03-15 initial BOM for 19 main simulator PCBs total
    [bom-total.ods, bom.ods]
2015-03-15 update old/discontinued schematics and layout
    [rauschsimulator_V4.sch]
2015-03-16 port SW to rxsms-2.0-rc1 PCB
2015-03-16 update BOM's order codes, min. qty and qty intervals
    [bom-total.ods, bom.ods]
2015-03-16 current BOM as CSV
    [bom-total-buerklin.csv, bom-total-farnell.csv, bom-total-rs.csv]
2015-03-16 buy less TEN 3-2410N
    [bom-total-rs.csv, bom-total.ods]
2015-03-16 buy more switches so they get cheaper
    [bom-total-buerklin.csv, bom-total.ods]
2015-03-16 found a way to get remaining TEN 3-2410N regulators
    [bom-total-rs.csv, bom-total.ods]
2015-03-16 add labels on PCB for switches, potis and expansion headers
    [rxsms-2.0.brd, rxsms-2.0.sch]
2015-03-16 add labels to DSUB connectors and screw terminal
    [rxsms-2.0.brd]
2015-03-16 update change date to next Thursday
    [rxsms-2.0.brd]
2015-03-17 Revert "update old/discontinued schematics and layout"
    This reverts commit 747fb5a004a441a50f034454c07004aeee56455b.
    [rauschsimulator_V4.sch]
2015-03-18 increase font size of button labels and LEDs
    [rxsms-2.0.brd]
2015-03-18 make more space for ERROR INHIBIT button label
    [rxsms-2.0.brd]
2015-03-18 add more traces to attach the experiment power FET to support the thermal
    [rxsms-2.0.brd]
2015-03-21 refactor and fix ordering of ADC channels and attached potis
    [task_adc.c]
2015-03-23 FIX: Various important hardware fixes
    Several bugs in the PCB were found during soldering of the first rxsms-rc1
    PCB. This commit fixes these.
    o Add forgotten connection of VCC of NC7WZ17P6X schmitt-trigger and of
    bypass capacitor to actual VCC/3V3
    o Remove the 100k Ohm termination resitstor on SP490 output
    o Swap RS485 output and input wire pair on the REXUS experiment
    connector
    [rxsms-2.0.brd, rxsms-2.0.sch]
2015-03-23 make label for V+/V- supply inputs also in the tStop layer
    [rxsms-2.0.brd]
2015-03-23 move 100nF capacitor closer to LM1117 LDO
    [rxsms-2.0.brd]
2015-03-23 update version's date on PCB
    [rxsms-2.0.brd]
2015-03-25 allow SIM_LO pin to run in open drain (wired-and) configuration
2015-03-25 use the real SIM_LO value to update the LED
2015-03-25 make the error inhibit status LED flashing when errors are allowed but not set by potis
    [task_ctrl.c]
2015-03-25 fix LO default state
    [task_ctrl.c]
2015-03-26 fix ADC CH0 SCAN register value
    [task_adc.c]
2015-03-26 add simple task_debug implementation to dump raw ADC values
2015-03-26 fix: replace Zener diode with voltage divider
    [rxsms-2.0.brd, rxsms-2.0.sch]
2015-03-26 increase resistor values for uplink/downlink and sim-pwr-led
    [rxsms-2.0.brd, rxsms-2.0.sch]
2015-03-26 update resistors for LEDs
    - delete separate resistors for SMD and THT push buttons,
    use single footprint instead
    - update the /SIM_LO line routing
    - increase LED resistor values and order codes
    [rxsms-2.0.brd, rxsms-2.0.sch]
2015-03-26 update date of PCB release
    [rxsms-2.0.brd]
2015-03-26 add jumpers for UDN2596A VK-pin to 28V EXP or 28V Supply
    [rxsms-2.0.brd, rxsms-2.0.sch]
2015-03-26 added GPLv3 logo to PCB
    [rxsms-2.0.brd]
2015-03-27 update order code of light pipe
    [rxsms-2.0.brd, rxsms-2.0.sch]
2015-03-27 remove empty bmpxxxx layers
    [rxsms-2.0.brd]
2015-03-27 update DRC
    [rxsms-2.0.brd]
2015-03-27 added 4mm jacks for supply
    [rxsms-2.0.brd, rxsms-2.0.sch]
2015-03-27 several ordercodes updated
    [rxsms-2.0.brd, rxsms-2.0.sch]
2015-03-27 some unneeded traces removed in favour of thermals
    [rxsms-2.0.brd]
2015-03-27 ZARM logo slightly moved
    [rxsms-2.0.brd]
2015-04-02 add reverse input voltage protection
    [rxsms-2.0.brd, rxsms-2.0.sch]
2015-04-02 shifted polygon to make text more visible
    [rxsms-2.0.brd]
2015-04-02 OC for 1k resistor updated
    [rxsms-2.0.brd, rxsms-2.0.sch]
2015-04-02 OC for 270 ohm resistor updated
    [rxsms-2.0.brd, rxsms-2.0.sch]
2015-04-02 OC for 4u7/50V capacitor updated
    [rxsms-2.0.brd, rxsms-2.0.sch]
2015-04-02 OC for 22u capacitor updated, increase vtg rating from 16V to 25V
    [rxsms-2.0.brd, rxsms-2.0.sch]
2015-04-02 fix prefix for coil
    [rxsms-2.0.brd, rxsms-2.0.sch]
2015-04-02 updated TODO list, cleared OC update tasks
    [bom-total.ods]
2015-04-09 minor beautification
    * mirrored reverse polarity schematics
    * some wires moved and a via inserted
    [rxsms-2.0.brd, rxsms-2.0.sch]
2015-04-09 Updated BOM parts lists
2015-04-09 unify file names
    [rxsms-2.0-parts.csv, rxsms-2.0-values.csv]
2015-04-15 split connectors and screws and update ordercode
    [rxsms-2.0.brd, rxsms-2.0.sch]
2015-04-15 update date/version info
    [rxsms-2.0.brd]
2015-04-15 remove superflous polygon in GND plane
    [rxsms-2.0.brd]
2015-04-15 add screws to power PCB
    [rxsms-2.0-Stromvers.brd, rxsms-2.0-Stromvers.sch]
2015-04-15 update BOMs
    [rxsms-2.0-Stromvers-parts.csv, rxsms-2.0-Stromvers-values.csv, rxsms-2.0-parts.csv, rxsms-2.0-values.csv]
2015-04-15 fix schematics and layout
    o add a dummy package (circle) to the screw. without package, it does not
    appear in the BOM
    o update the order code for the screw: new model is a bit longer but
    much cheaper which is important because of the high number of pieces.
    o synchronize/update the screws in the layout files
    [rxsms-2.0-Stromvers.brd, rxsms-2.0-Stromvers.sch, rxsms-2.0.brd, rxsms-2.0.sch]
2015-04-24 renamed original per simulator BOM
    [bom-sim.ods]
2015-04-24 add library for screw terminal
2015-04-29 rename the BOM file for the first version's part order
    [bom-sim-order_2015mar17.ods]
2015-04-30 exported layout and schematics
2015-04-30 add missing order code to 1k resistor
    [rxsms-2.0-parts.csv, rxsms-2.0-values.csv, rxsms-2.0.brd, rxsms-2.0.sch]
2015-04-30 more separate circuits to their directories
    [rxsms-2.0-Stromvers-parts.csv, rxsms-2.0-Stromvers-values.csv, rxsms-2.0-Stromvers.brd, rxsms-2.0-Stromvers.dxf, rxsms-2.0-Stromvers.sch, rxsms-2.0-parts.csv, rxsms-2.0-values.csv, rxsms-2.0.brd]
2015-04-30 cleanup: old and outdated gEDA files
    [exp-if.sch, gndsta-iso-a.sch, gndsta-iso-b.sch, input-poti-sw.sch, rxsms.sch, usb.sch]
2015-05-07 changed OC of BSS123 FETs, use normal tape instead of re-reel'ed version
    [bom-total-farnell.csv, rxsms-2.0-parts.csv, rxsms-2.0-values.csv, rxsms-2.0.brd, rxsms-2.0.sch]
2015-05-08 fix OC for USB resistors
    [rxsms-2.0-parts.csv, rxsms-2.0-values.csv, rxsms-2.0.brd, rxsms-2.0.sch]
2015-05-08 make color and ordercode explicit for 4mm jacks
    [rxsms-2.0-parts.csv, rxsms-2.0-values.csv, rxsms-2.0.brd, rxsms-2.0.sch]
2015-05-08 move exported schematics and layout printouts to subdir
2015-05-08 moved simulator BOMs to simulator's subdir
    [bom-sim-order_2015mar17.ods, bom-sim.ods]
2015-05-08 assing value to 0 Ohm resistors
    [rxsms-2.0-parts.csv, rxsms-2.0-values.csv, rxsms-2.0.brd, rxsms-2.0.sch]
2015-05-08 updated date in PCB version
    [rxsms-2.0.brd]
2015-05-08 reexport BOM from eagle
    [rxsms-2.0-values.csv]
2015-05-21 update BOM
    [bom-sim.ods, bom-total.ods]
2015-05-21 BOM as in the second order
    [bom-sim-farnell.csv, bom-sim-rs.csv, bom-sim.ods]
2015-05-26 highlight parts to add to manufactured PCBs
    [bom-sim.ods]
2015-06-03 add 'ok' for verified components
    [bom-sim.ods]
2015-06-03 add part list of variant for assembly
    [var_assembly.csv]
2015-06-18 update date of order of PCBs
    [rxsms-2.0.brd]
2015-08-05 add change records for first 2 completed PCBs
2015-08-05 add TODOs for SW: we could use table lookups instead of calculating the error probabilities/masks.
    [task_adc.c]
2015-08-21 fix names for different versions of compiler/avrlibc
    [task_adc.c]
2015-08-22 move raw adc measurements to internal/file-local scope
2015-08-22 remove reading of the internal temperature sensor
    There's an internal temperature sensor but we do not know how to
    convert the sensor readings to the actual temperature or the sensor
    is simply /very/ inaccurate.
    Up to now we never used these values so we can easily remove them
    and increase readability of the program and reduce the LOC count.
    If at a later point in time the temperature gets interesting again
    we can add the code for it then.
2015-08-22 shorten 'triggered' struct member using bitfield
    [task_buttons.c]
2015-08-23 move error genration from task_adc to task_error
    [task_adc.c, task_adc.h, task_ctrl.c, task_error.c, task_error_tables.h]
2015-08-23 add string representation of error tables
    [task_error_tables.h]
2015-08-23 print test string in task_debug via DMA
2015-08-23 print status info via task_debug
2015-08-24 simplify and shorten task_adc
    [task_adc.c]
2015-08-26 beautify layout
    [rxsms-2.0.sch]
2015-08-26 added more schematics and layouts as PDF
2015-08-26 forgot update of PDF after schematic were changed
2015-08-31 added current documentation for RXSMS
